Dreamy-Z3r0/VGU-WirelessMeteorologyStation/05 - Literature/Figures/Hardware/Misol station - internal PCB.jpg

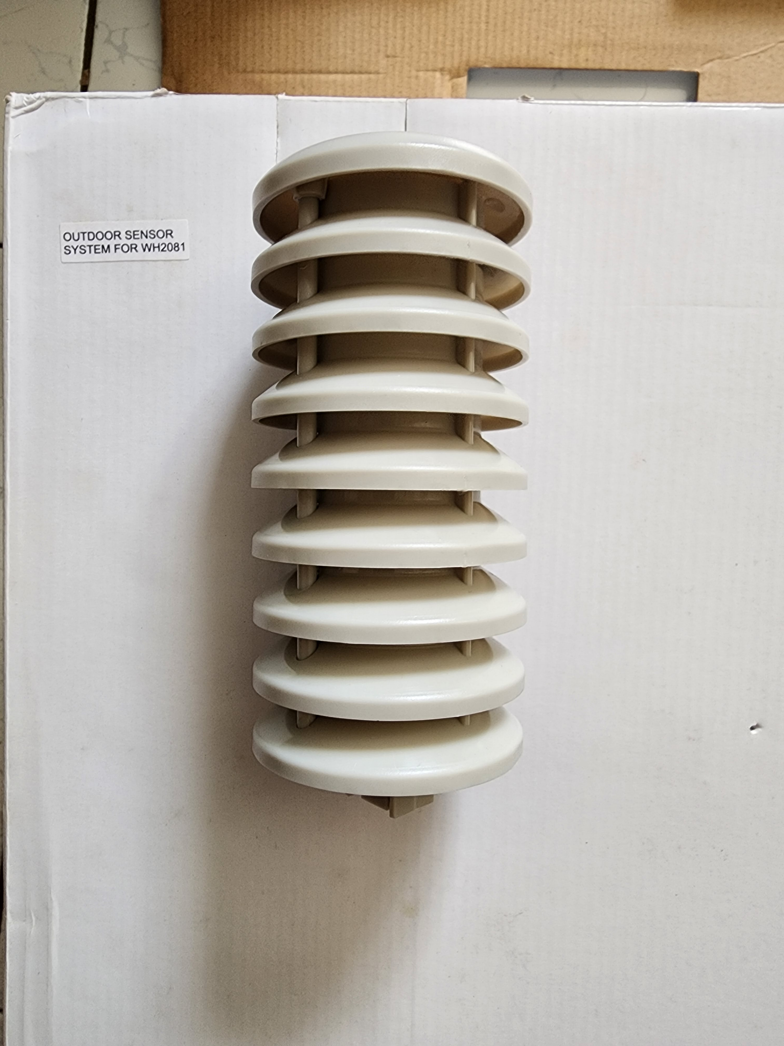
05 - Literature/Figures/Hardware/Misol station - internal PCB.jpg
