Dreamy-Z3r0/VGU-WirelessMeteorologyStation/05 - Literature/Figures/Hardware/Misol station - weather-proof case.jpg

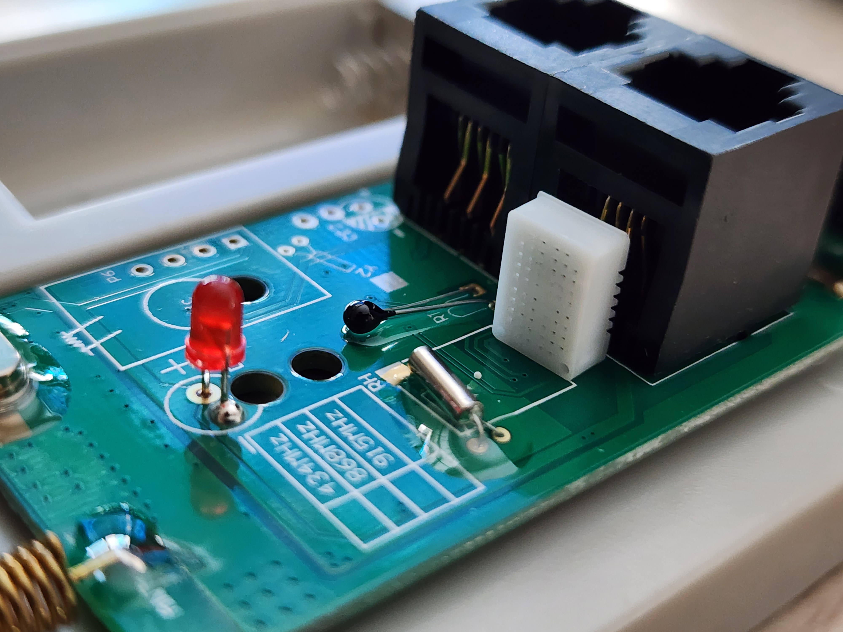
05 - Literature/Figures/Hardware/Misol station - weather-proof case.jpg
