Dreamy-Z3r0/VGU-WirelessMeteorologyStation/05 - Literature/Figures/40403.jpg

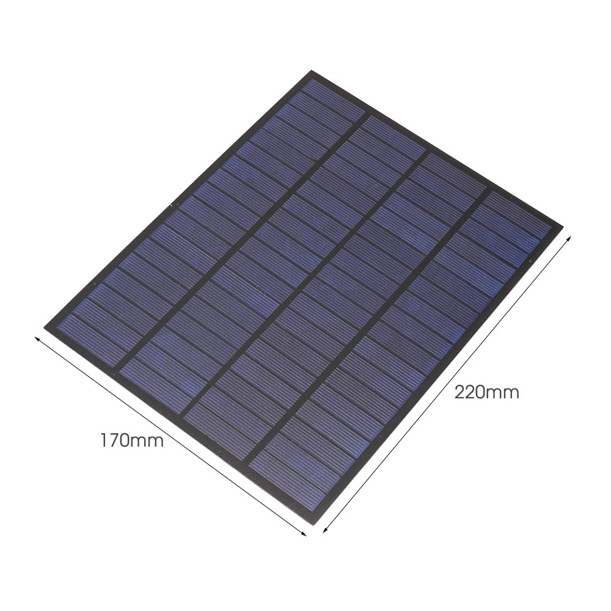
05 - Literature/Figures/40403.jpg
