Dreamy-Z3r0/VGU-WirelessMeteorologyStation/05 - Literature/Figures/50713.jpg

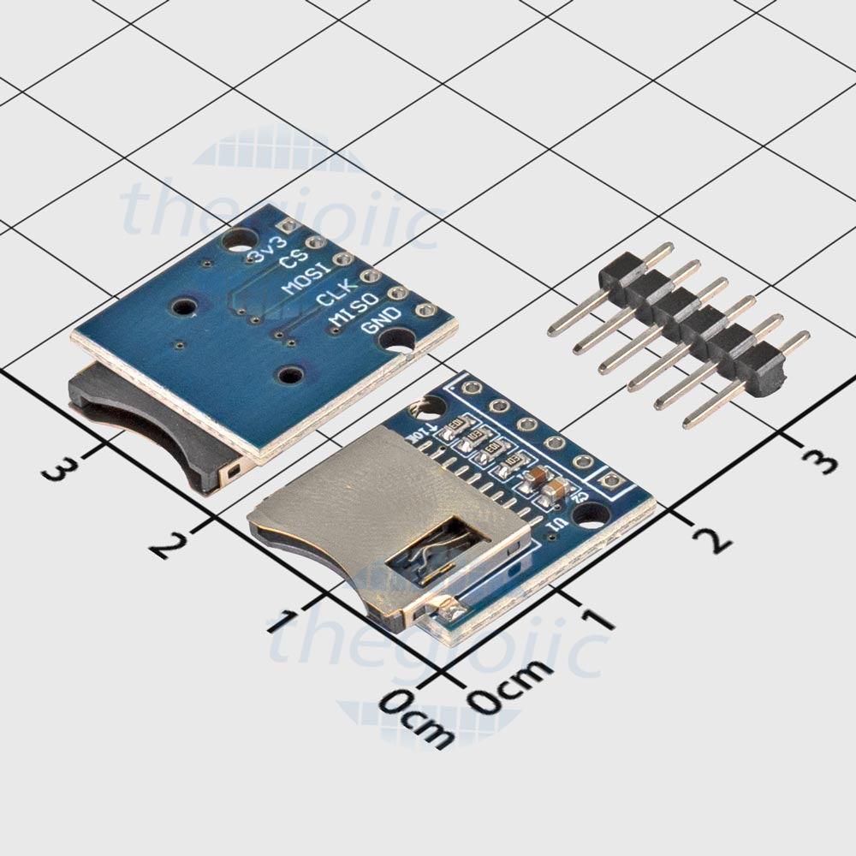
05 - Literature/Figures/50713.jpg
