Dreamy-Z3r0/VGU-WirelessMeteorologyStation/05 - Literature/Figures/20230910_115903.jpg

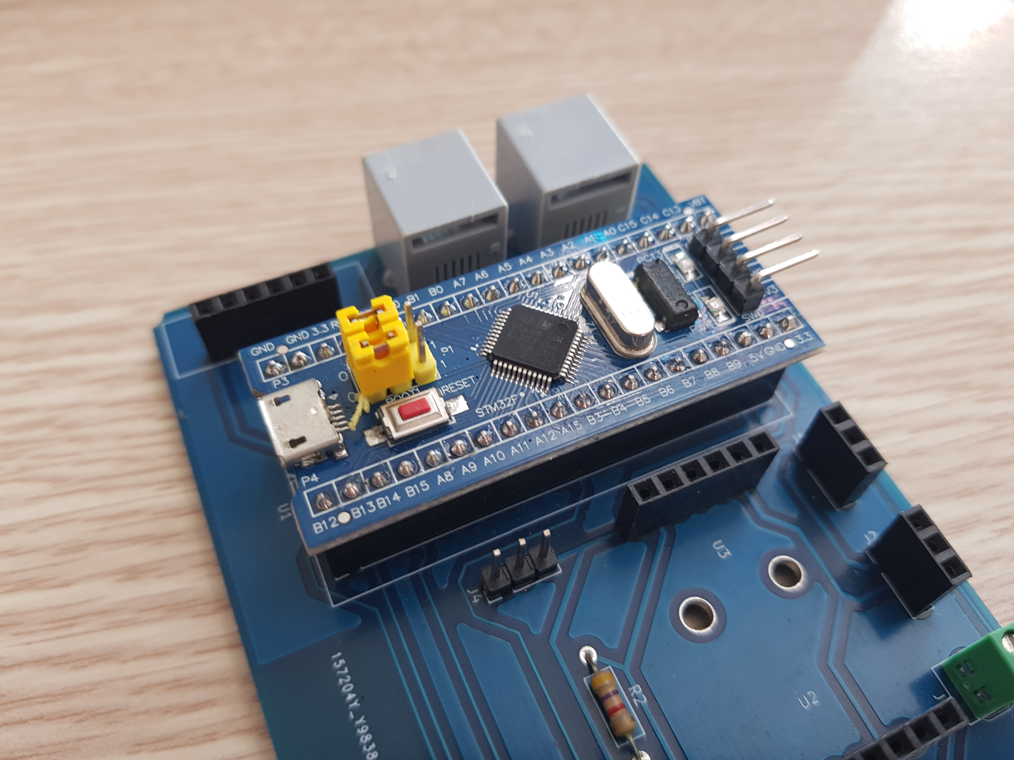
05 - Literature/Figures/20230910_115903.jpg
