Dreamy-Z3r0/VGU-WirelessMeteorologyStation/05 - Literature/Figures/[DS18B20] Read routine.png

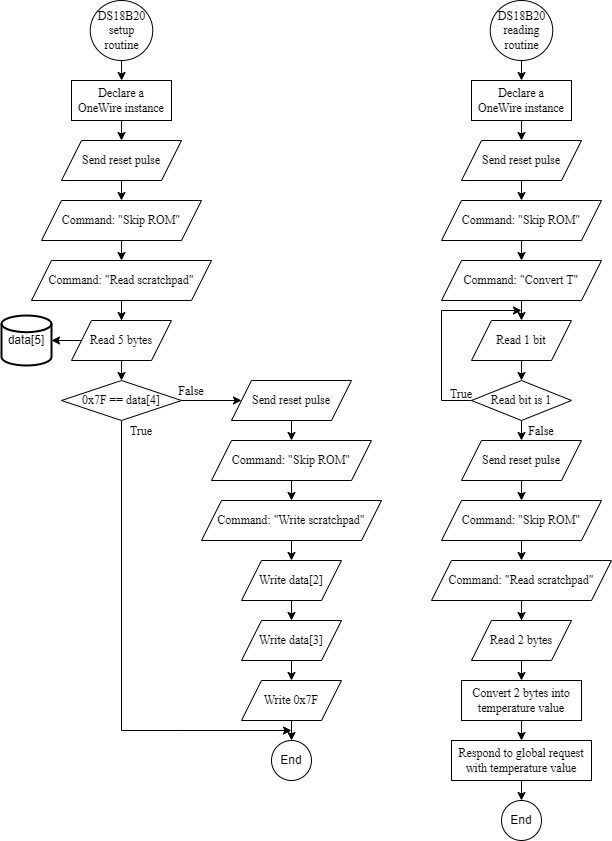
05 - Literature/Figures/[DS18B20] Read routine.png
