Dreamy-Z3r0/VGU-WirelessMeteorologyStation/05 - Literature/Figures/[Gateway] Software.png

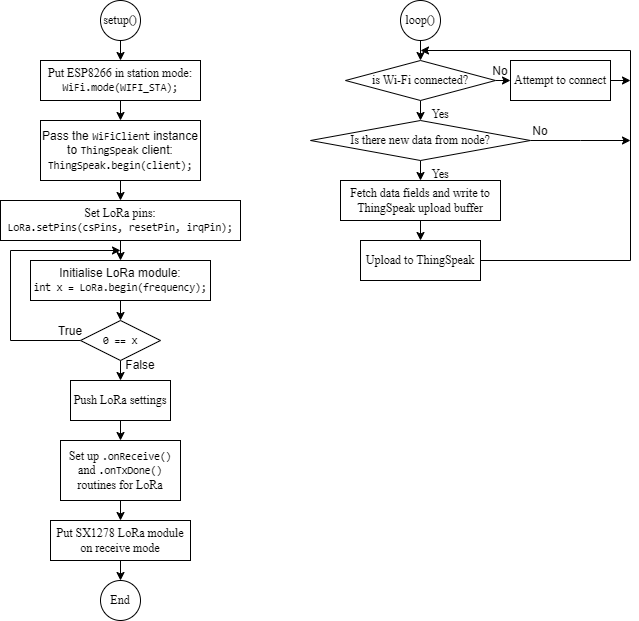
05 - Literature/Figures/[Gateway] Software.png
