Dreamy-Z3r0/VGU-WirelessMeteorologyStation/05 - Literature/Figures/[SX1278] Software design flow.png

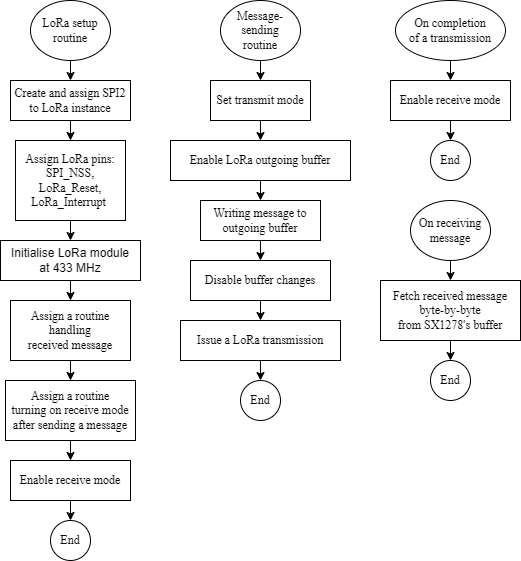
05 - Literature/Figures/[SX1278] Software design flow.png
