Dreamy-Z3r0/VGU-WirelessMeteorologyStation/05 - Literature/Figures/Active filter.PNG

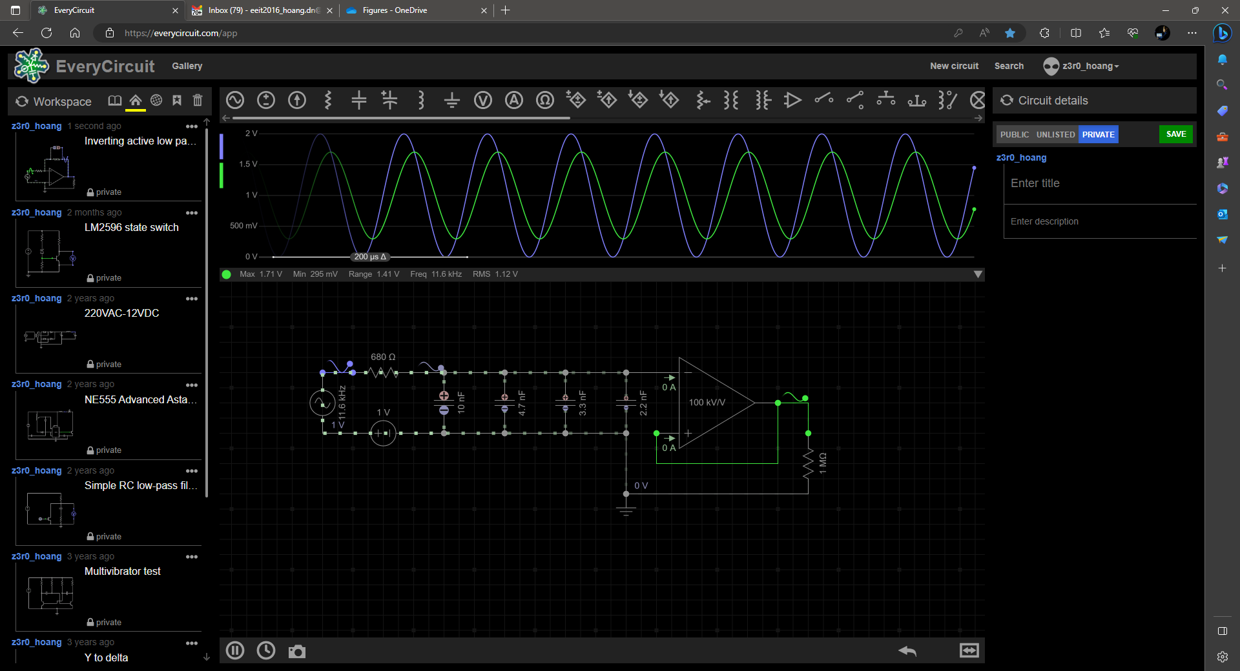
05 - Literature/Figures/Active filter.PNG
