Dreamy-Z3r0/VGU-WirelessMeteorologyStation/05 - Literature/Figures/Active filter/SCR46.PNG

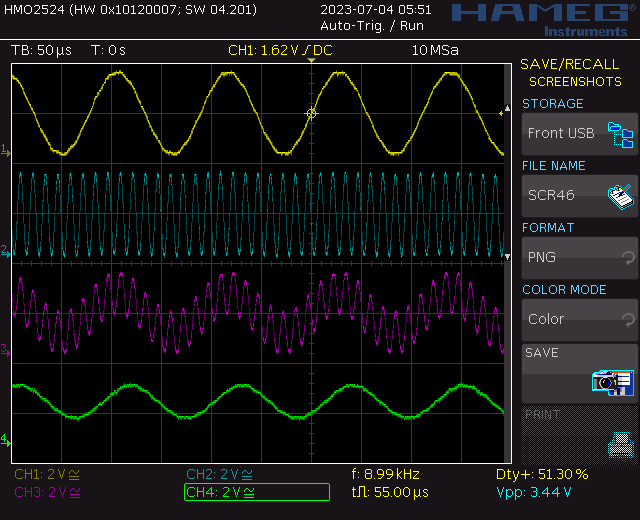
05 - Literature/Figures/Active filter/SCR46.PNG
