Dreamy-Z3r0/VGU-WirelessMeteorologyStation/05 - Literature/Figures/ADC_simplified.PNG

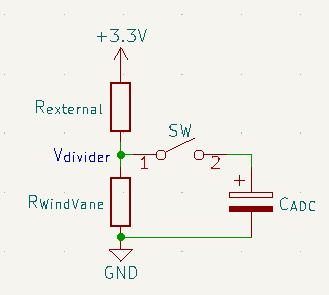
05 - Literature/Figures/ADC_simplified.PNG
