Dreamy-Z3r0/VGU-WirelessMeteorologyStation/05 - Literature/Figures/ADC_simplified_current source_equivalent.PNG

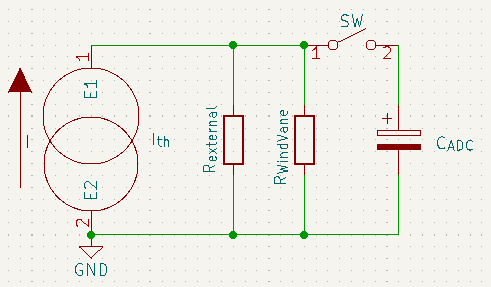
05 - Literature/Figures/ADC_simplified_current source_equivalent.PNG
