Dreamy-Z3r0/VGU-WirelessMeteorologyStation/05 - Literature/Figures/ADC_simplified_current source_final.PNG

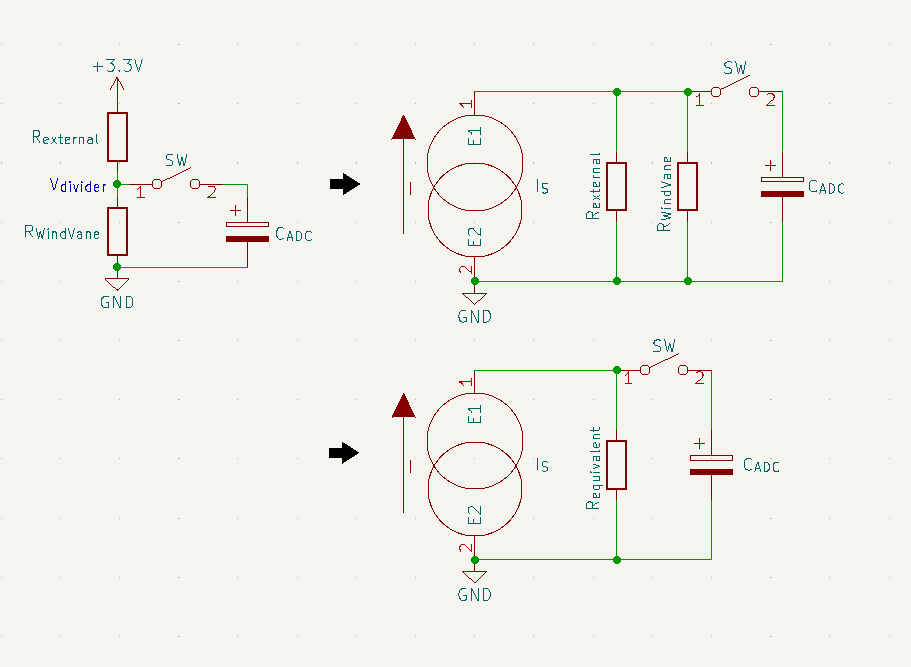
05 - Literature/Figures/ADC_simplified_current source_final.PNG
