Dreamy-Z3r0/VGU-WirelessMeteorologyStation/05 - Literature/Figures/ADC_simplified_current source_to voltage source.PNG

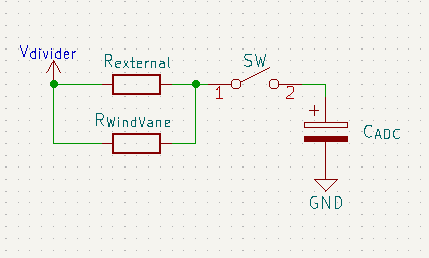
05 - Literature/Figures/ADC_simplified_current source_to voltage source.PNG
