Dreamy-Z3r0/VGU-WirelessMeteorologyStation/05 - Literature/Figures/Anemometer factor chart.png

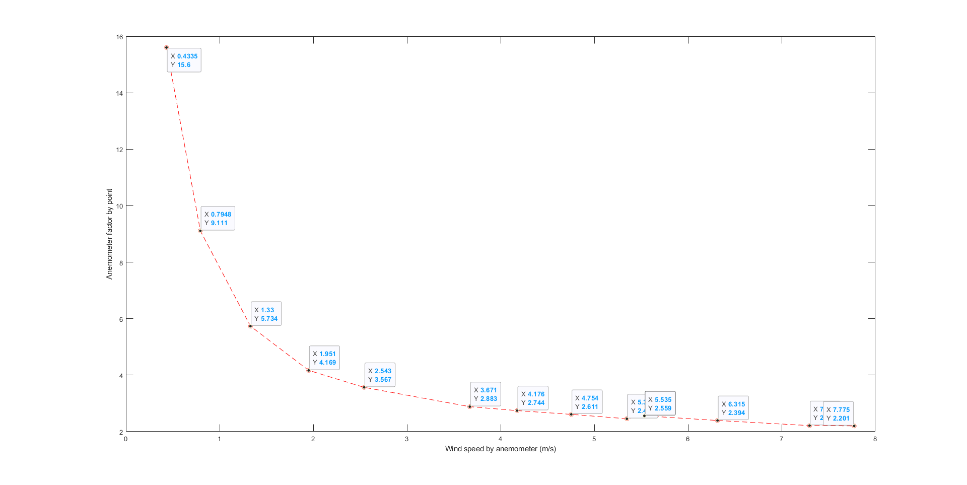
05 - Literature/Figures/Anemometer factor chart.png
