Dreamy-Z3r0/VGU-WirelessMeteorologyStation/05 - Literature/Figures/Blue Pill - ADC.PNG

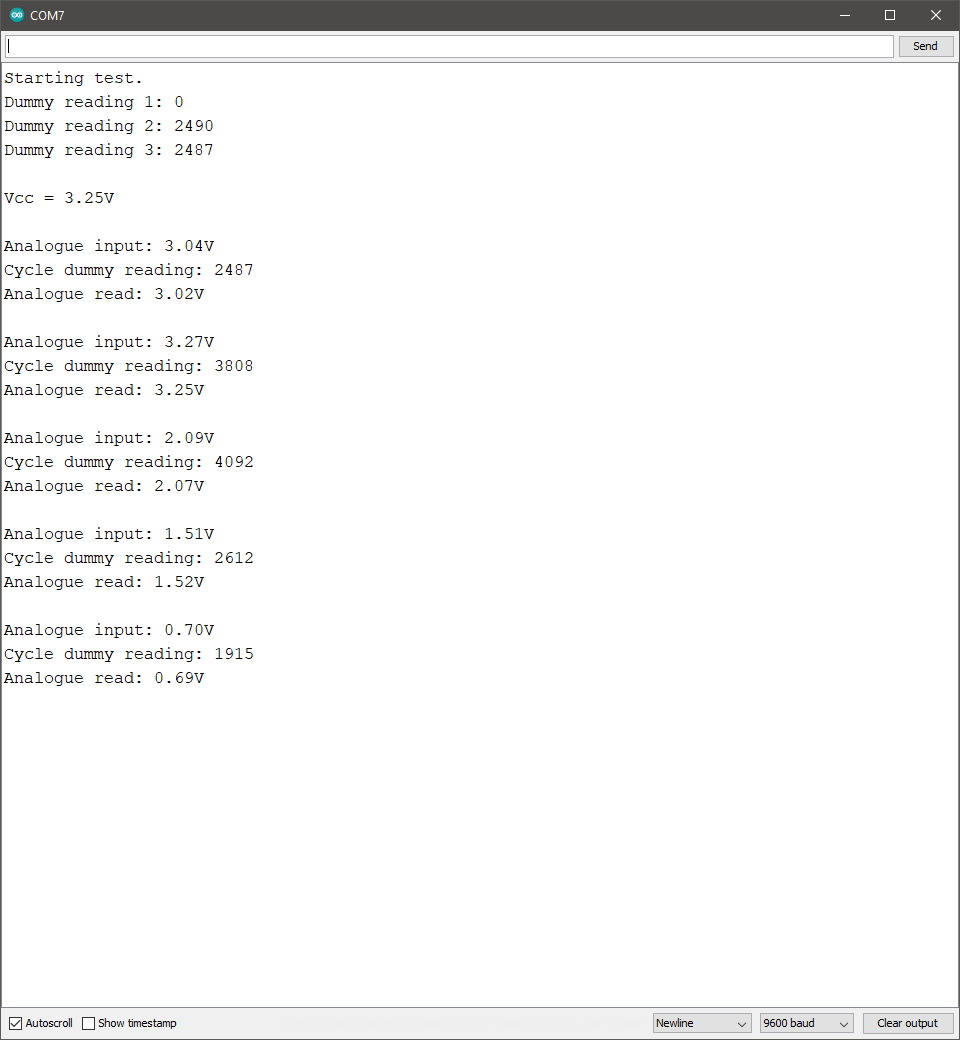
05 - Literature/Figures/Blue Pill - ADC.PNG
