Dreamy-Z3r0/VGU-WirelessMeteorologyStation/05 - Literature/Figures/Blue Pill - External interrupt and output delay.PNG

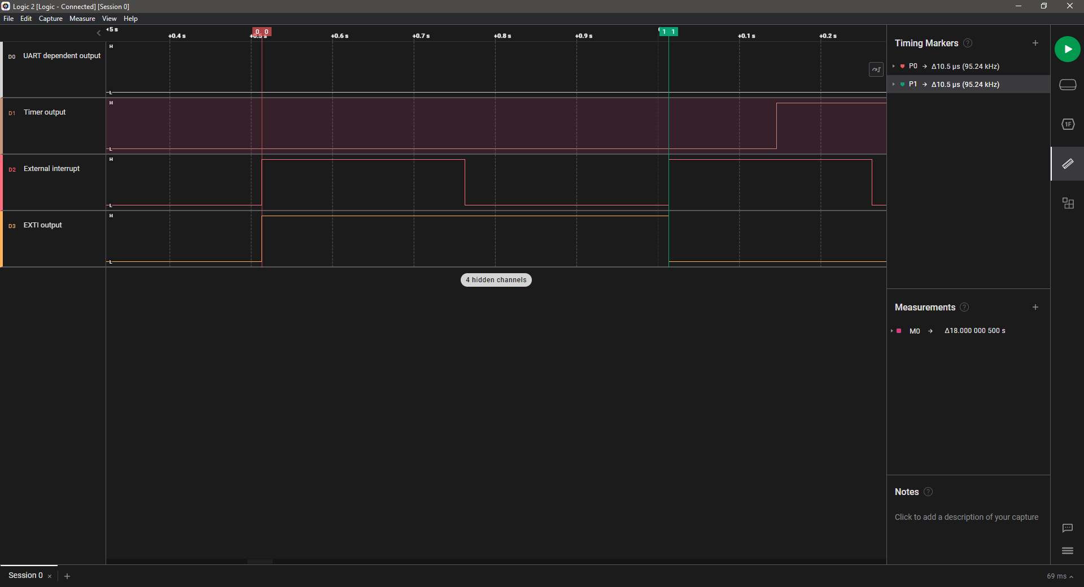
05 - Literature/Figures/Blue Pill - External interrupt and output delay.PNG
