Dreamy-Z3r0/VGU-WirelessMeteorologyStation/05 - Literature/Figures/Blue Pill - UART routine.PNG

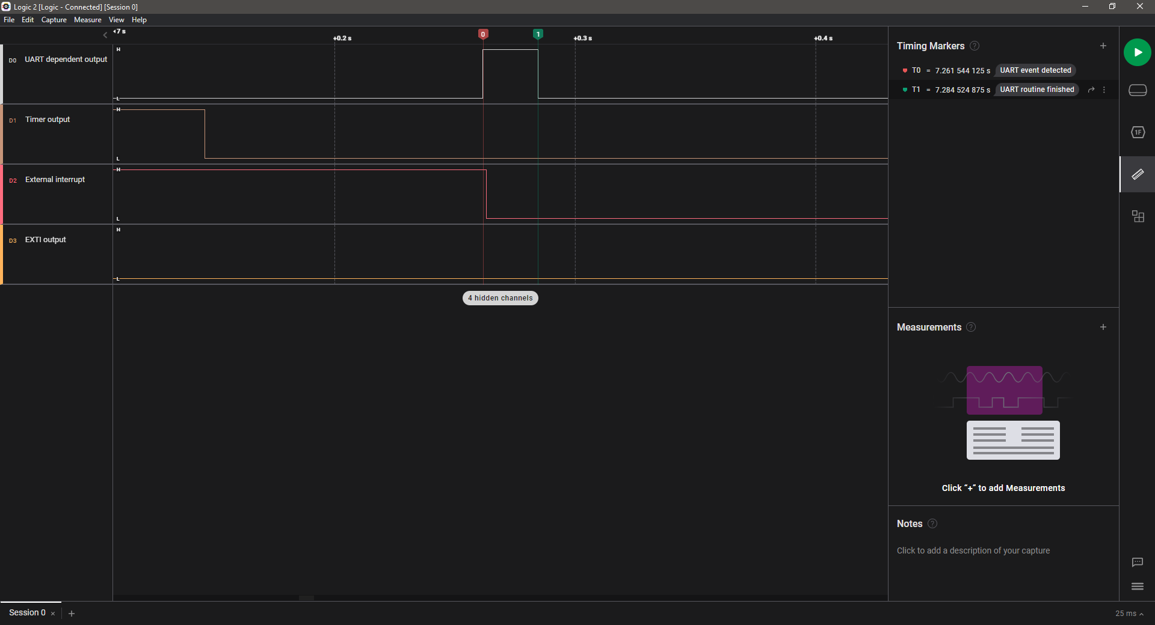
05 - Literature/Figures/Blue Pill - UART routine.PNG
