Dreamy-Z3r0/VGU-WirelessMeteorologyStation/05 - Literature/Figures/Blue Pill schematic.png

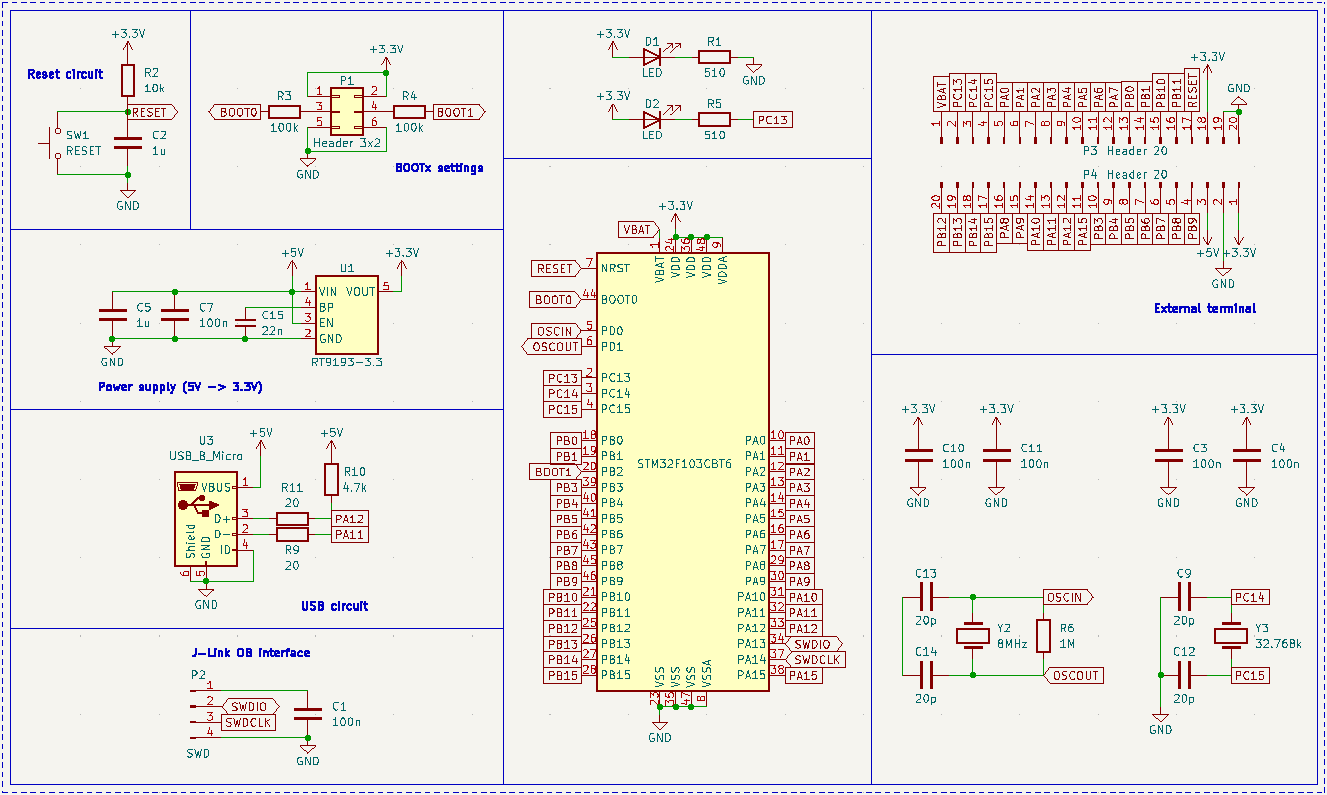
05 - Literature/Figures/Blue Pill schematic.png
