Dreamy-Z3r0/VGU-WirelessMeteorologyStation/05 - Literature/Figures/Blue Pill simplified - 1Hz output on EXTI.PNG

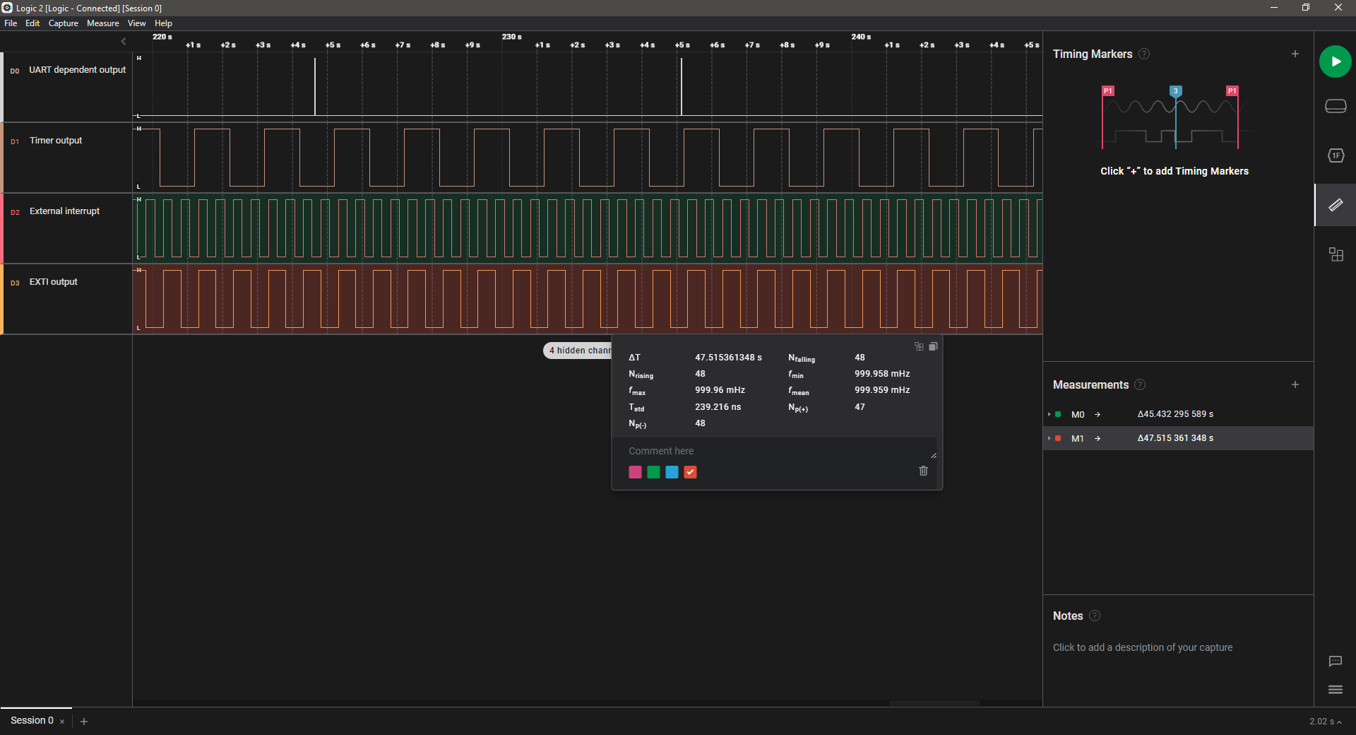
05 - Literature/Figures/Blue Pill simplified - 1Hz output on EXTI.PNG
