Dreamy-Z3r0/VGU-WirelessMeteorologyStation/05 - Literature/Figures/Blue Pill simplified - 1Hz Timer for 0.5Hz output.PNG

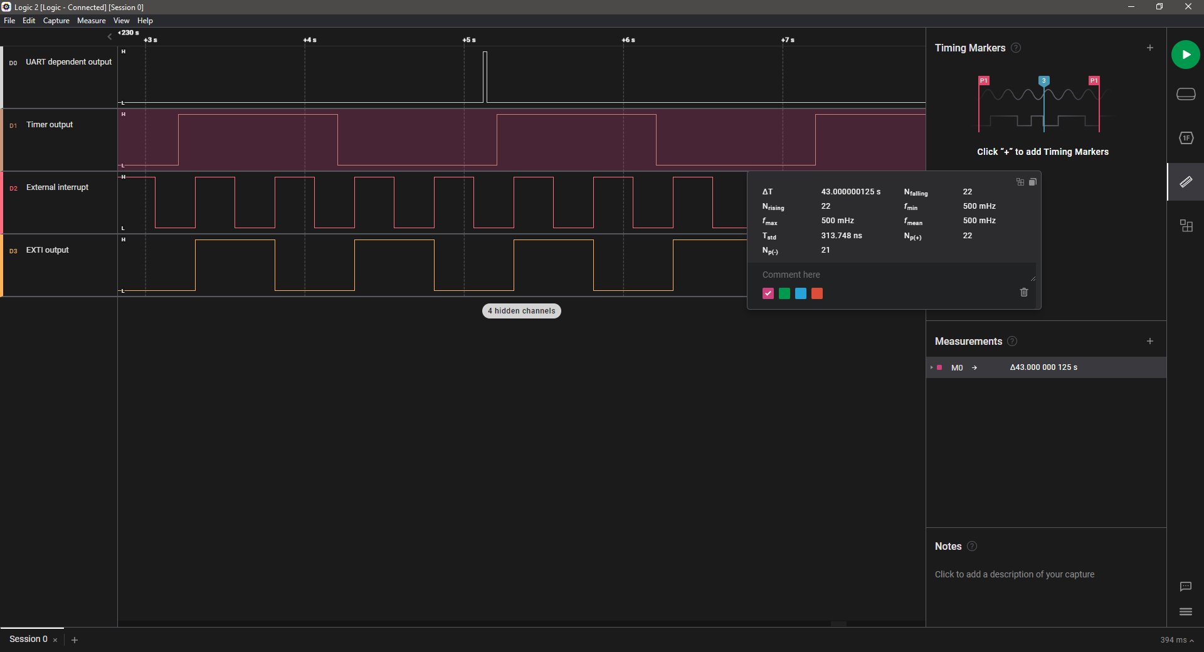
05 - Literature/Figures/Blue Pill simplified - 1Hz Timer for 0.5Hz output.PNG
