Dreamy-Z3r0/VGU-WirelessMeteorologyStation/05 - Literature/Figures/Blue Pill simplified - 2Hz external interrupt.PNG

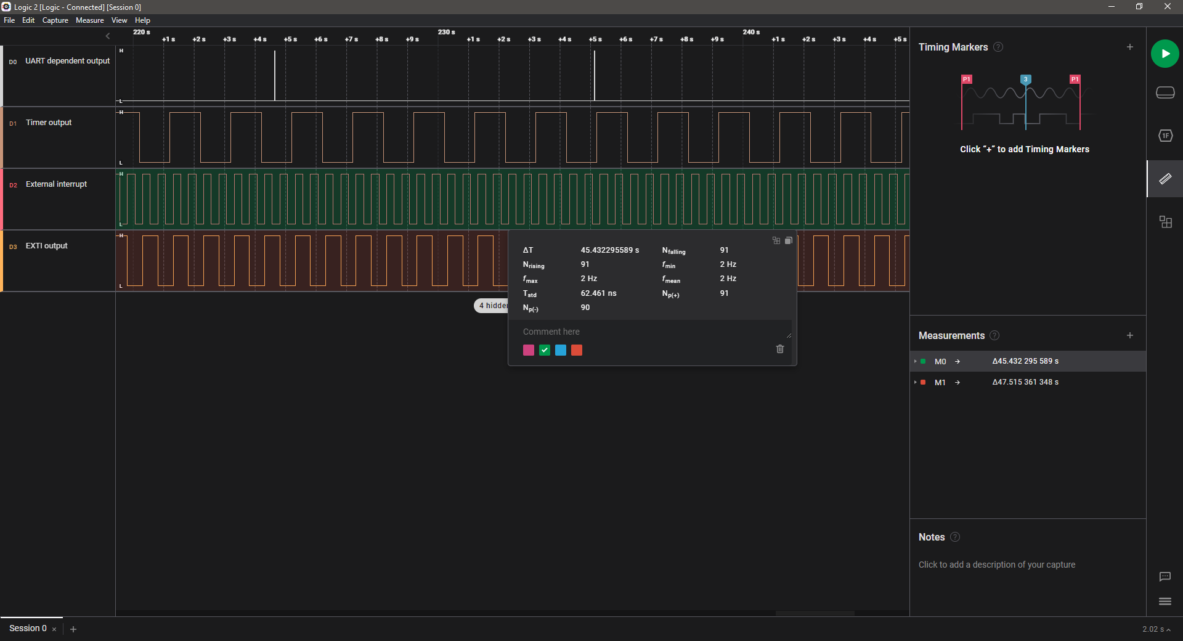
05 - Literature/Figures/Blue Pill simplified - 2Hz external interrupt.PNG
