Dreamy-Z3r0/VGU-WirelessMeteorologyStation/05 - Literature/Figures/Determining R_external.PNG

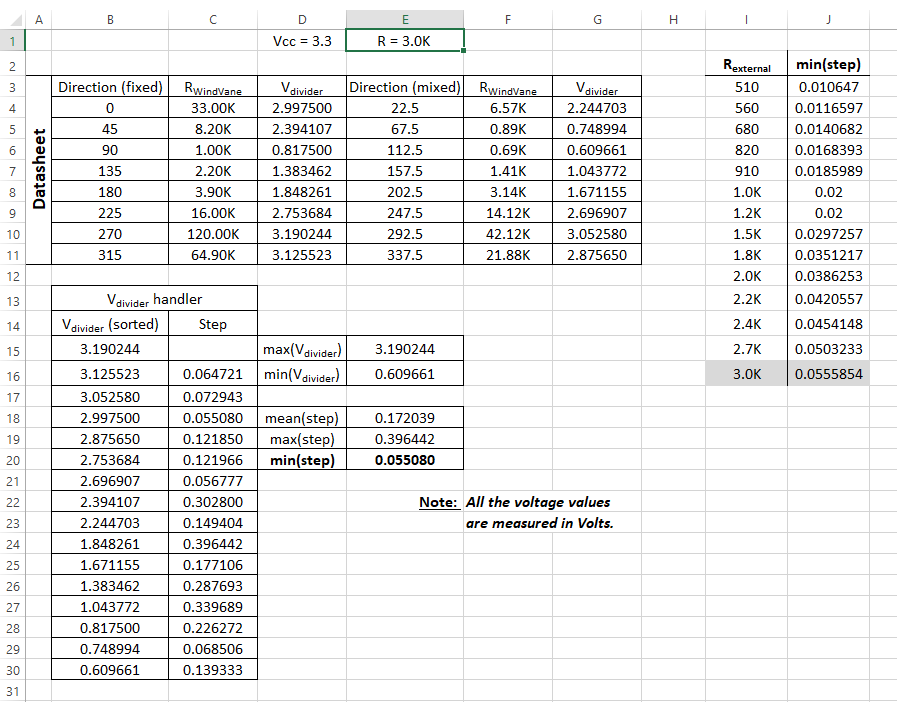
05 - Literature/Figures/Determining R_external.PNG
