Dreamy-Z3r0/VGU-WirelessMeteorologyStation/05 - Literature/Figures/Finalised circuitry for anemometer and rain gauge.PNG

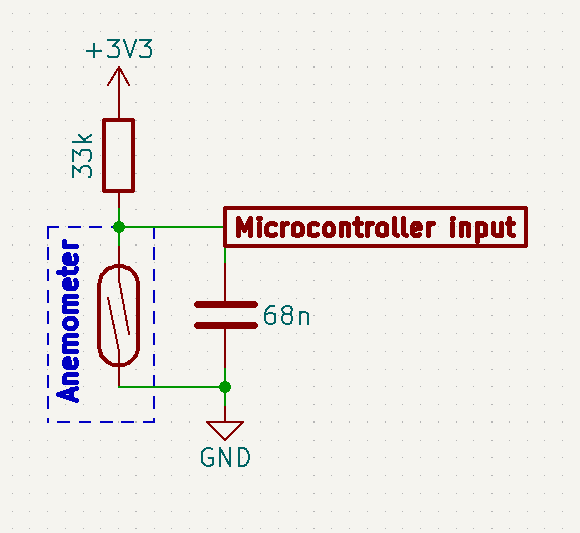
05 - Literature/Figures/Finalised circuitry for anemometer and rain gauge.PNG
