Dreamy-Z3r0/VGU-WirelessMeteorologyStation/05 - Literature/Figures/No reverse current protection - high pv output.jpeg

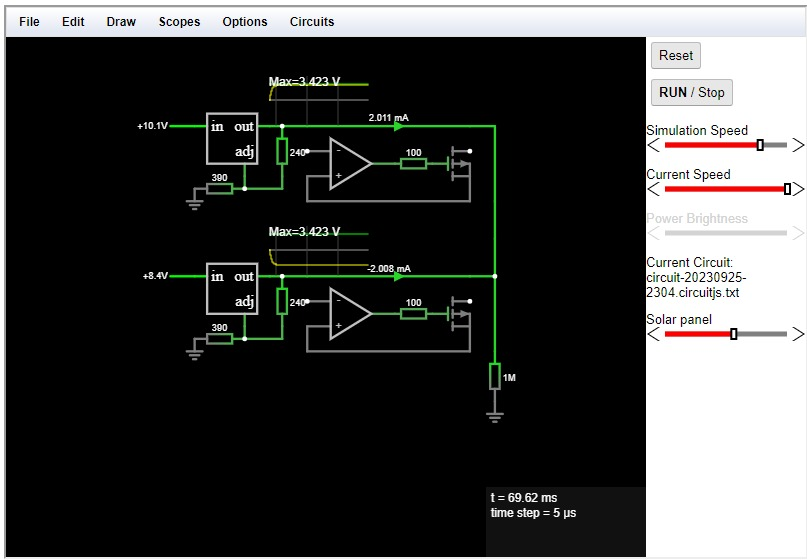
05 - Literature/Figures/No reverse current protection - high pv output.jpeg
