Dreamy-Z3r0/VGU-WirelessMeteorologyStation/05 - Literature/Figures/No reverse current protection - reverse current present.jpeg

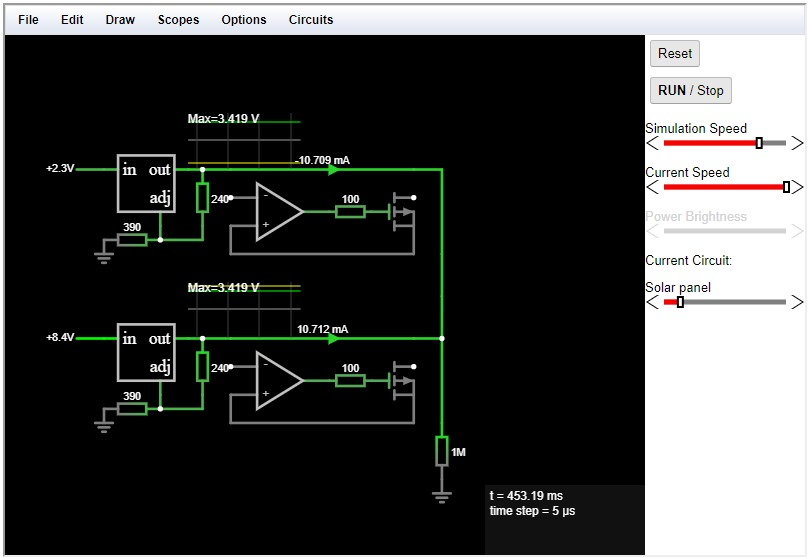
05 - Literature/Figures/No reverse current protection - reverse current present.jpeg
