Dreamy-Z3r0/VGU-WirelessMeteorologyStation/05 - Literature/Figures/STM32CubeProg detecting C8T6 with 128KB.PNG

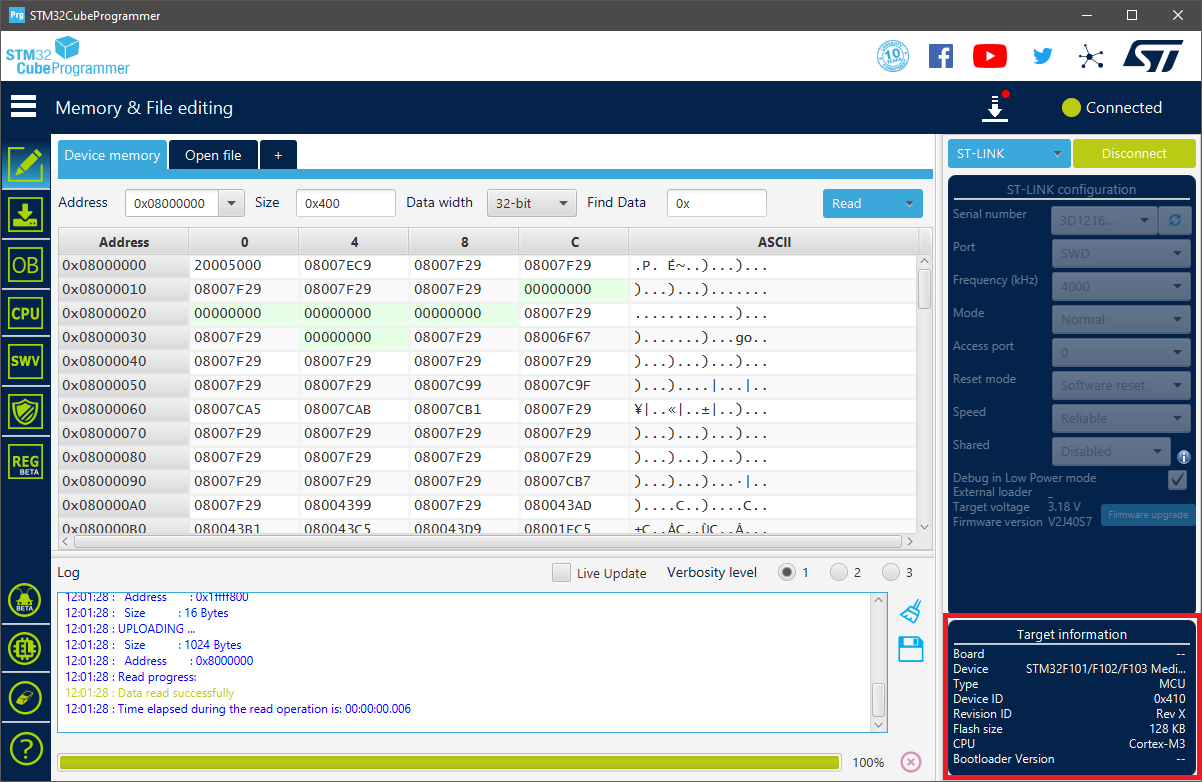
05 - Literature/Figures/STM32CubeProg detecting C8T6 with 128KB.PNG
