Dreamy-Z3r0/VGU-WirelessMeteorologyStation/05 - Literature/Figures/Thingspeak - configuring charts.jpeg

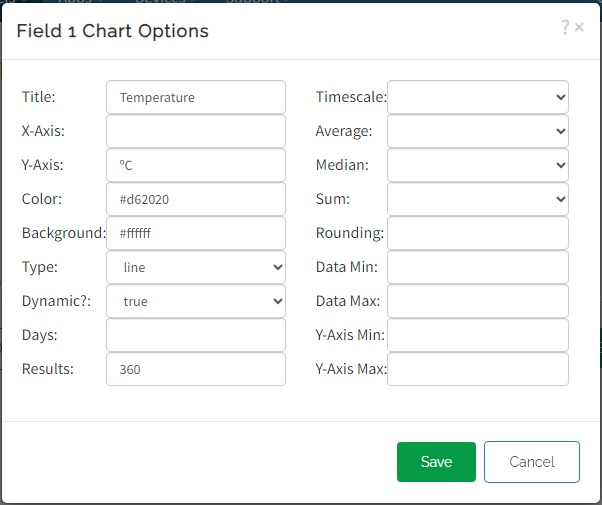
05 - Literature/Figures/Thingspeak - configuring charts.jpeg
