Dreamy-Z3r0/VGU-WirelessMeteorologyStation/01 - Simulations/2nd order active LPF/2nd order active LPF.png

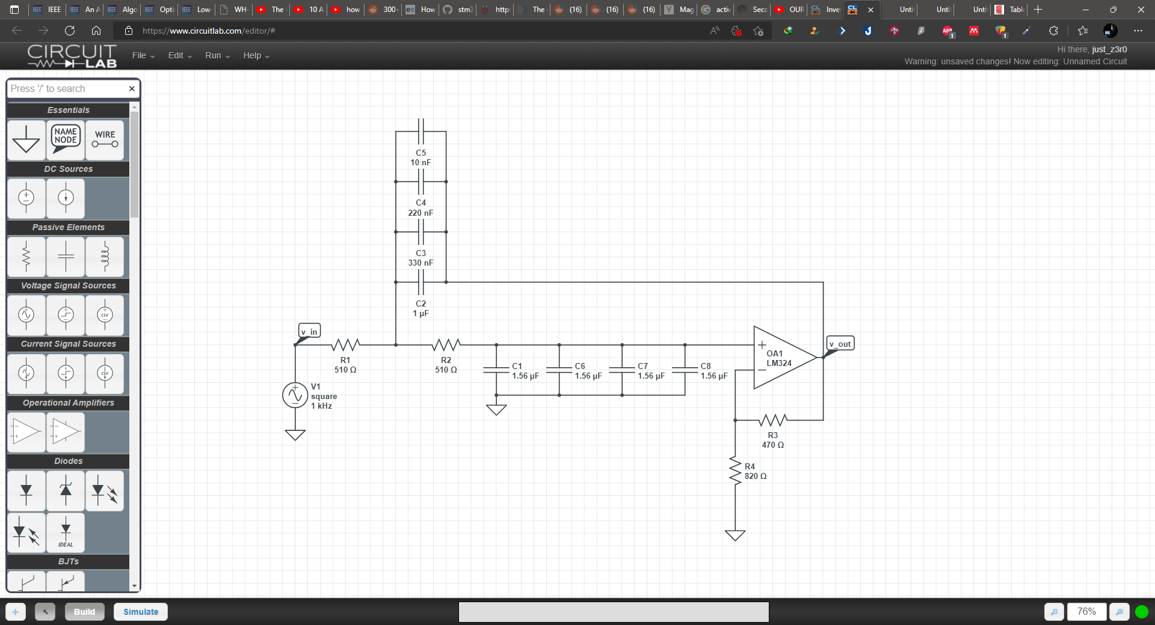
01 - Simulations/2nd order active LPF/2nd order active LPF.png
