Dreamy-Z3r0/VGU-WirelessMeteorologyStation/01 - Simulations/2nd order active LPF/LM324 - phase.png

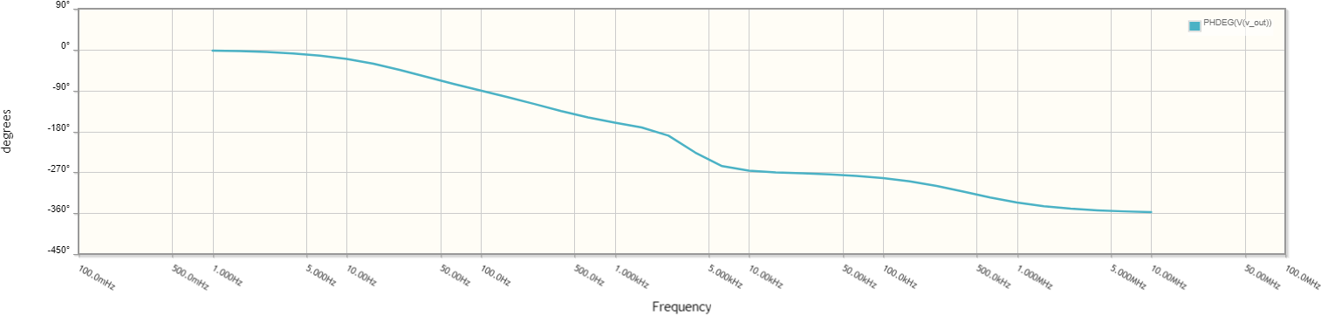
01 - Simulations/2nd order active LPF/LM324 - phase.png
