Dreamy-Z3r0/VGU-WirelessMeteorologyStation/04 - Assembly/Version 0.2.1 (Beta) - minor update/Main_Code/README.md

# Assembly
### Version 0.2.1 (beta)

- Initialization of the main code: ***Main_Code.ino***, ***Libraries.h***, and ***Macros_and_Variables.h***
- First feature of the assembly: *Real-time Clock*
- Second feature of the assembly: *Ambient temperature - Relative humidity - Barometric pressure*
- (*minor update*) Remove SPI remapping
