Dreamy-Z3r0/VGU-WirelessMeteorologyStation/04 - Assembly/Version 1.4 (Beta)/Main_Code/README.md

# Assembly
### Beta release - Version 1.4

Change log:
- Add main routine for Sensor_Control class
- Remove most of main.ino contents
