Dreamy-Z3r0/VGU-WirelessMeteorologyStation/04 - Assembly/Version 1.1 (Beta)/Main_Code/README.md

# Assembly
### Beta release - Version 1.1

Change log:
- HAL implementation added for ADC functionality.
- Improved code readability.
