Dreamy-Z3r0/VGU-WirelessMeteorologyStation/04 - Assembly/Version 1.2 (Beta)/Main_Code/README.md

# Assembly
### Beta release - Version 1.2

Change log:
- Restructured code hierarchies.
- New methods for anemometer control.
- Simplified processing functions of vind vane by the removal of unnecessary variable dynamic allocation.
- Bug fixed: Invalid results produced by high ordered IIR filter.
