Dreamy-Z3r0/VGU-WirelessMeteorologyStation/04 - Assembly/Version 1.3 (Beta)/Main_Code/README.md

# Assembly
### Beta release - Version 1.3

Change log:
- Change of wind vane reading method
- Bug fixed: Conflicted access of DS3231 due to the update of timestamps for sensors.
