Dreamy-Z3r0/VGU-WirelessMeteorologyStation/05 - Literature/Figures/[Anemometer] Software setup.png

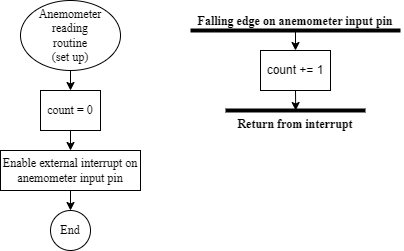
05 - Literature/Figures/[Anemometer] Software setup.png
