Dreamy-Z3r0/VGU-WirelessMeteorologyStation/05 - Literature/Figures/Bypass capacitor setup.PNG

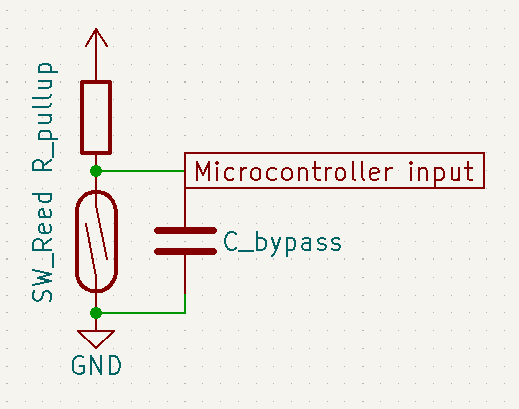
05 - Literature/Figures/Bypass capacitor setup.PNG
