Dreamy-Z3r0/VGU-WirelessMeteorologyStation/05 - Literature/Figures/Dummie mechanical switch setup.PNG

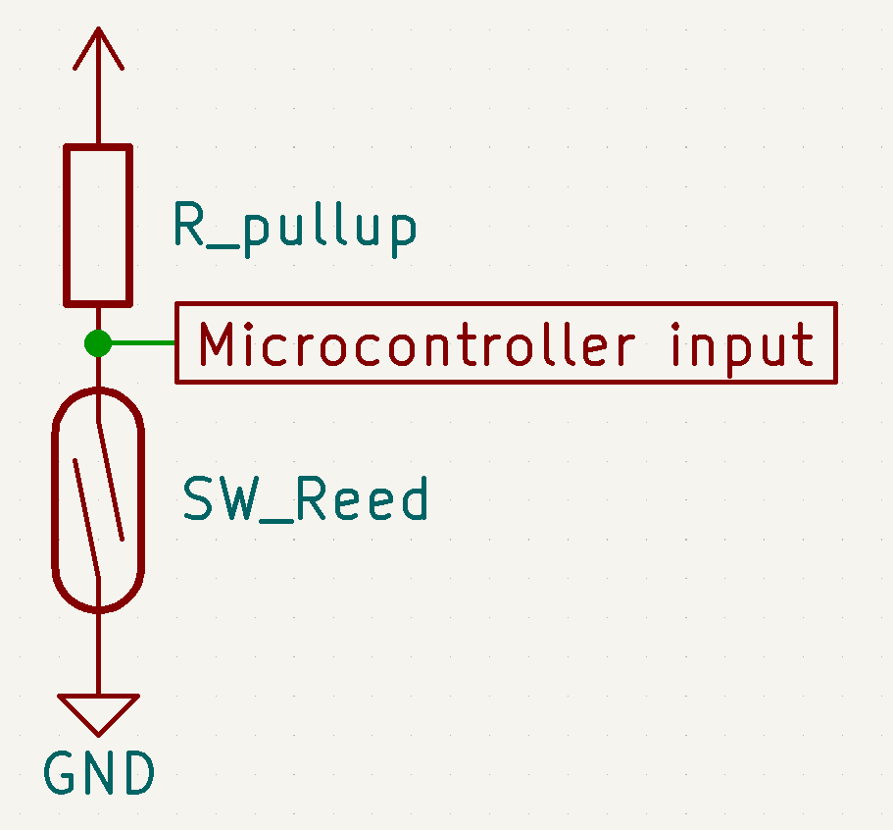
05 - Literature/Figures/Dummie mechanical switch setup.PNG
