Dreamy-Z3r0/VGU-WirelessMeteorologyStation/05 - Literature/Figures/OpAmp buffer test - CA3140EZ - Sine/TEST_INFO.txt

Device in test: CA3140EZ
Test wave: Sine wave, 440Hz, A = 3.3Vpp, 1.65V offset
Variable: OpAmp supply voltage
