Dreamy-Z3r0/VGU-WirelessMeteorologyStation/05 - Literature/Figures/OpAmp buffer test - CA3140EZ - Sawtooth/500mHz/TEST_INFO.txt

Device in test: CA3140EZ
Test wave: Sawtooth wave, 500mHz, A = 3.3Vpp, 1.65V offset, 100% symmetry
Variable: OpAmp supply voltage
