Dreamy-Z3r0/VGU-WirelessMeteorologyStation/05 - Literature/Figures/OpAmp buffer test - CA3140EZ - Sawtooth/50Hz/TEST_INFO.txt

Device in test: CA3140EZ
Test wave: Sawtooth wave, 50Hz, A = 3.3Vpp, 1.65V offset, 100% symmetry
Variable: OpAmp supply voltage
