Dreamy-Z3r0/VGU-WirelessMeteorologyStation/02 - Module Testings/Power supply tests/LM317.xlsx

LM317 |  |  |  |  |  | LM317 + TL431
18 | 3.3 | 18 | 3.93 | 18 | 4.25 | 18 | 18 | 3.55 | 18 | 3.74 | 18 | 15.13
15 | 3.27 | 15 | 3.78 | 15 | 4.08 | 15 | 15 | 3.47 | 15 | 3.62 | 15 | 14.06
12 | 3.13 | 12 | 3.59 | 12 | 3.88 | 12 | 12 | 3.39 | 12 | 3.52 | 12 | 11.05
10 | 3.13 | 10 | 3.44 | 10 | 3.71 | 10 | 10 | 3.33 | 10 | 3.44 | 10 | 9.18
8.4 | 3.13 | 8.4 | 3.3 | 8.4 | 3.56 | 8.4 | 8.4 | 3.3 | 8.4 | 3.39 | 8.4 | 7.59
6.3 | 3.12 | 6.3 | 3.06 | 6.3 | 3.3 | 6.3 | 6.3 | 3.24 | 6.3 | 3.3 | 6.3 | 5.46
5 | 3.09 | 5 | 2.88 | 5 | 3.1 | 4.1 | 4.1 | 3 | 4.1 | 3.04 | 4.1 | 3.3
3.3 | 2.4 | 3.3 | 2.43 | 3.3 | 2.36 | 3.3 | 3.3 | 2.29 | 3.3 | 2.34 | 3.3 | 2.53
2.5 | 1.67 | 2.5 | 1.67 | 2.5 | 1.69 | 2.5 | 2.5 | 1.62 | 2.5 | 1.57 | 2.5 | 1.74
1.25 | 0.55 | 1.25 | 0.55 | 1.25 | 0.56 | 1.25 | 1.25 | 0.52 | 1.25 | 0.54 | 1.25 | 0.44
 |  |  |  |  |  | min(Vin) = 4.1V
