Dreamy-Z3r0/VGU-WirelessMeteorologyStation/05 - Literature/Data/ADC test - wind vane/Active filter - 3.3k pull down/Active filter - 3.3k pull down.xlsx

Direction (read) | Raw ADC | V_in | R_read | Direction (read) | Raw ADC | V_in | R_read | Direction (read) | Raw ADC | V_in | R_read | Direction (read) | Raw ADC | V_in | R_read
Direction: | 0 | 2.9949 V |  | Direction: | 22.5 | 2.1995 V |  | Direction: | 45 | 2.3538 V |  | Direction: | 67.5 | 0.7084 V
0 | 3741 | 2.99 | 35643.78 | 22.5 | 2740 | 2.19 | 6680.43 | 45 | 2933 | 2.34 | 8339.53 | 67.5 | 867 | 0.69 | 885.04
0 | 3738 | 2.99 | 34873.71 | 22.5 | 2737 | 2.19 | 6673.06 | 45 | 2933 | 2.34 | 8329.52 | 67.5 | 864 | 0.69 | 886.34
0 | 3739 | 2.98 | 34552.92 | 22.5 | 2739 | 2.19 | 6651.03 | 45 | 2930 | 2.34 | 8329.52 | 67.5 | 873 | 0.69 | 882.45
0 | 3741 | 2.99 | 34659.27 | 22.5 | 2734 | 2.19 | 6665.71 | 45 | 2929 | 2.34 | 8299.57 | 67.5 | 863 | 0.7 | 894.13
0 | 3736 | 2.99 | 34873.71 | 22.5 | 2735 | 2.18 | 6629.1 | 45 | 2931 | 2.34 | 8289.62 | 67.5 | 861 | 0.69 | 881.16
0 | 3734 | 2.98 | 34342.06 | 22.5 | 2739 | 2.18 | 6636.4 | 45 | 2933 | 2.34 | 8309.54 | 67.5 | 865 | 0.69 | 878.57
0 | 3736 | 2.98 | 34133.5 | 22.5 | 2735 | 2.19 | 6665.71 | 45 | 2934 | 2.34 | 8329.52 | 67.5 | 863 | 0.69 | 883.75
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
