Dreamy-Z3r0/VGU-WirelessMeteorologyStation/05 - Literature/Data/ADC test - wind vane/Active filter - 4.7k pull down/Active filter - 4.7k pull down.xlsx

Direction (read) | Raw ADC | V_in | R_read | Direction (read) | Raw ADC | V_in | R_read | Direction (read) | Raw ADC | V_in | R_read | Direction (read) | Raw ADC | V_in | R_read
Direction: | 0 | 2.9943 V |  | Direction: | 22.5 | 2.1988 V |  | Direction: | 45 | 2.3535 V |  | Direction: | 67.5 | 0.7083 V
0 | 3744 | 2.99 | 35983.42 | 22.5 | 2755 | 2.19 | 6754.69 | 45 | 2957 | 2.35 | 8502.18 | 67.5 | 858 | 0.68 | 869.55
0 | 3745 | 2.99 | 35200 | 22.5 | 2753 | 2.2 | 6784.7 | 45 | 2945 | 2.36 | 8574.78 | 67.5 | 860 | 0.68 | 874.7
0 | 3749 | 2.99 | 35309.99 | 22.5 | 2752 | 2.2 | 6769.67 | 45 | 2945 | 2.35 | 8450.87 | 67.5 | 860 | 0.69 | 877.28
0 | 3744 | 2.99 | 35756.36 | 22.5 | 2753 | 2.19 | 6762.17 | 45 | 2946 | 2.35 | 8450.87 | 67.5 | 857 | 0.69 | 877.28
0 | 3747 | 2.99 | 35200 | 22.5 | 2746 | 2.2 | 6769.67 | 45 | 2946 | 2.35 | 8461.1 | 67.5 | 861 | 0.68 | 873.41
0 | 3744 | 2.99 | 35531.88 | 22.5 | 2749 | 2.19 | 6717.42 | 45 | 2952 | 2.35 | 8461.1 | 67.5 | 857 | 0.69 | 878.57
0 | 3746 | 2.99 | 35200 | 22.5 | 2750 | 2.19 | 6739.75 | 45 | 2947 | 2.35 | 8522.83 | 67.5 | 863 | 0.68 | 873.41
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
