Dreamy-Z3r0/VGU-WirelessMeteorologyStation/05 - Literature/Data/ADC test - wind vane/CA3140EZ @ 6V/Filter (11.587kHz) and voltage buffer.xlsx

Direction (read) | Raw ADC | V_in | R_read | Direction (read) | Raw ADC | V_in | R_read | Direction (read) | Raw ADC | V_in | R_read | Direction (read) | Raw ADC | V_in | R_read
Direction: | 0 |  |  | Direction: | 22.5 |  |  | Direction: | 45 |  |  | Direction: | 67.5
0 | 3711 | 2.95 | 31528.6 | 22.5 | 2711 | 2.16 | 6499.49 | 45 | 2905 | 2.31 | 8065.43 | 67.5 | 932 | 0.72 | 928.25
0 | 3713 | 2.96 | 31891.39 | 22.5 | 2715 | 2.16 | 6464.09 | 45 | 2900 | 2.31 | 8055.88 | 90 | 927 | 0.74 | 972.37
0 | 3701 | 2.96 | 32075.66 | 22.5 | 2715 | 2.16 | 6492.39 | 45 | 2903 | 2.31 | 8008.37 | 90 | 911 | 0.74 | 965.62
0 | 3723 | 2.95 | 30998.23 | 22.5 | 2709 | 2.16 | 6492.39 | 45 | 2903 | 2.31 | 8036.83 | 67.5 | 934 | 0.73 | 944.19
0 | 3703 | 2.96 | 33026.6 | 22.5 | 2724 | 2.16 | 6450 | 45 | 2899 | 2.31 | 8036.83 | 90 | 913 | 0.74 | 975.07
0 | 3723 | 2.95 | 31173.22 | 22.5 | 2719 | 2.17 | 6556.67 | 45 | 2899 | 2.31 | 7998.91 | 90 | 913 | 0.73 | 946.86
0 | 3716 | 2.96 | 33026.6 | 22.5 | 2709 | 2.17 | 6520.86 | 45 | 2900 | 2.31 | 7998.91 | 90 | 902 | 0.73 | 946.86
0 | 3724 | 2.96 | 32355.68 | 22.5 | 2711 | 2.16 | 6450 | 45 | 2895 | 2.31 | 8008.37 | 67.5 | 909 | 0.72 | 932.23
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
