Dreamy-Z3r0/VGU-WirelessMeteorologyStation/05 - Literature/Data/ADC test - wind vane/CA3140EZ @ 6V/Only voltage buffer.xlsx

Direction (read) | Raw ADC | V_in | R_read | Direction (read) | Raw ADC | V_in | R_read | Direction (read) | Raw ADC | V_in | R_read | Direction (read) | Raw ADC | V_in | R_read
Direction: | 0 |  |  | Direction: | 22.5 |  |  | Direction: | 45 |  |  | Direction: | 67.5
0 | 3730 | 2.97 | 33421.47 | 22.5 | 2720 | 2.17 | 6535.15 | 45 | 2906 | 2.31 | 7998.91 | 67.5 | 905 | 0.72 | 938.86
0 | 3721 | 2.97 | 33723.28 | 22.5 | 2717 | 2.17 | 6528 | 45 | 2909 | 2.32 | 8065.43 | 67.5 | 917 | 0.72 | 936.21
0 | 3719 | 2.96 | 32832.35 | 22.5 | 2698 | 2.16 | 6506.6 | 45 | 2912 | 2.32 | 8094.18 | 90 | 913 | 0.73 | 952.2
0 | 3725 | 2.96 | 32640.16 | 22.5 | 2715 | 2.15 | 6373.23 | 45 | 2921 | 2.32 | 8123.08 | 90 | 917 | 0.73 | 946.86
0 | 3718 | 2.97 | 33222.98 | 22.5 | 2707 | 2.16 | 6492.39 | 45 | 2927 | 2.33 | 8210.65 | 90 | 901 | 0.73 | 952.2
0 | 3705 | 2.96 | 32544.83 | 22.5 | 2714 | 2.16 | 6435.95 | 45 | 2917 | 2.33 | 8269.78 | 67.5 | 892 | 0.72 | 930.9
0 | 3721 | 2.95 | 31350 | 22.5 | 2729 | 2.16 | 6485.3 | 45 | 2906 | 2.32 | 8171.56 | 67.5 | 912 | 0.71 | 919.01
0 | 3715 | 2.96 | 32832.35 | 22.5 | 2719 | 2.17 | 6592.75 | 45 | 2894 | 2.32 | 8065.43 | 90 | 898 | 0.73 | 945.52
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
