Dreamy-Z3r0/VGU-WirelessMeteorologyStation/05 - Literature/Data/ADC test - wind vane/MCP6002 @ 3.3V/Filter (11.587kHz) and voltage buffer.xlsx

Direction (read) | Raw ADC | V_in | R_read | Direction (read) | Raw ADC | V_in | R_read | Direction (read) | Raw ADC | V_in | R_read | Direction (read) | Raw ADC | V_in | R_read
Direction: | 0 |  |  | Direction: | 22.5 |  |  | Direction: | 45 |  |  | Direction: | 67.5
292.5 | 3771 | 3.02 | 38929.68 | 22.5 | 2756 | 2.2 | 6784.7 | 45 | 2965 | 2.37 | 8637.72 | 67.5 | 869 | 0.69 | 882.45
292.5 | 3776 | 3.02 | 38408.32 | 22.5 | 2758 | 2.2 | 6792.23 | 45 | 2962 | 2.37 | 8658.85 | 67.5 | 855 | 0.7 | 888.93
292.5 | 3769 | 3.02 | 39062.05 | 22.5 | 2762 | 2.21 | 6807.33 | 45 | 2955 | 2.37 | 8627.19 | 67.5 | 862 | 0.68 | 870.83
292.5 | 3774 | 3.02 | 38152.44 | 22.5 | 2754 | 2.21 | 6837.66 | 45 | 2954 | 2.36 | 8553.95 | 67.5 | 854 | 0.69 | 879.86
292.5 | 3771 | 3.02 | 38798.1 | 22.5 | 2755 | 2.2 | 6777.18 | 45 | 2963 | 2.36 | 8543.56 | 67.5 | 860 | 0.68 | 869.55
292.5 | 3771 | 3.02 | 38408.32 | 22.5 | 2758 | 2.2 | 6784.7 | 45 | 2960 | 2.37 | 8637.72 | 67.5 | 854 | 0.69 | 877.28
292.5 | 3771 | 3.02 | 38408.32 | 22.5 | 2759 | 2.21 | 6807.33 | 45 | 2943 | 2.37 | 8606.17 | 67.5 | 862 | 0.68 | 869.55
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
