Dreamy-Z3r0/VGU-WirelessMeteorologyStation/05 - Literature/Figures/LoRa - Range test - Server signal.jpeg

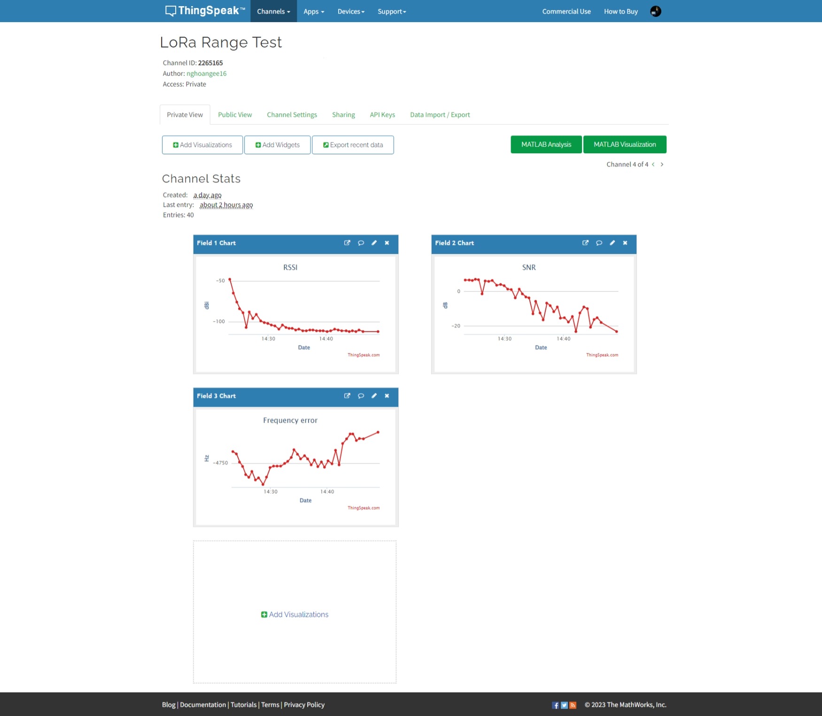
05 - Literature/Figures/LoRa - Range test - Server signal.jpeg
