Dreamy-Z3r0/VGU-WirelessMeteorologyStation/05 - Literature/Figures/microSD - interfacing test - root.PNG

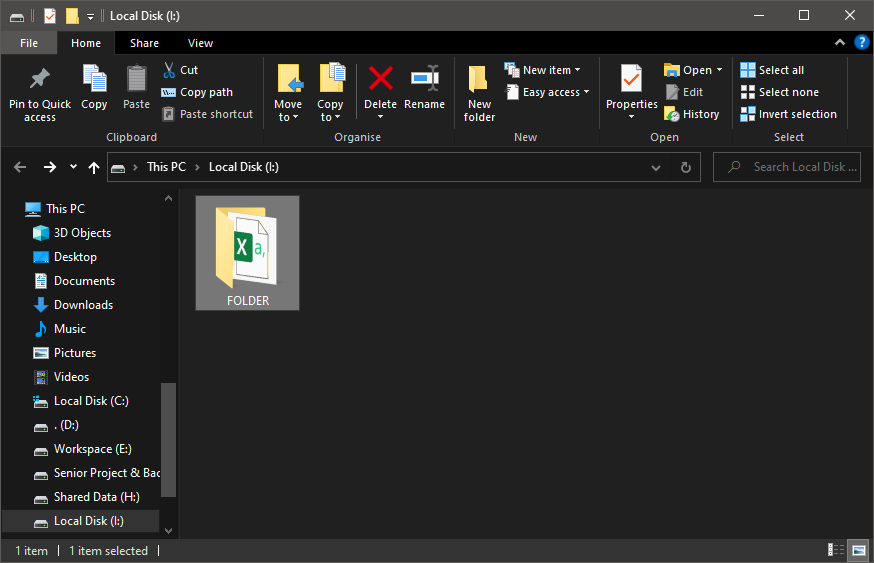
05 - Literature/Figures/microSD - interfacing test - root.PNG
