Dreamy-Z3r0/VGU-WirelessMeteorologyStation/05 - Literature/Figures/OpAmp buffer test - CA3140EZ - Sawtooth/500mHz/(5) 17V5.PNG

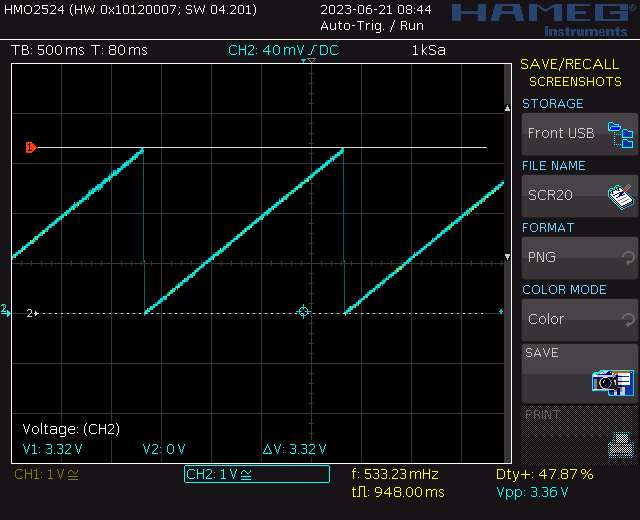
05 - Literature/Figures/OpAmp buffer test - CA3140EZ - Sawtooth/500mHz/(5) 17V5.PNG
