Dreamy-Z3r0/VGU-WirelessMeteorologyStation/05 - Literature/Figures/OpAmp buffer test - CA3140EZ - Sine/(2) 5V.PNG

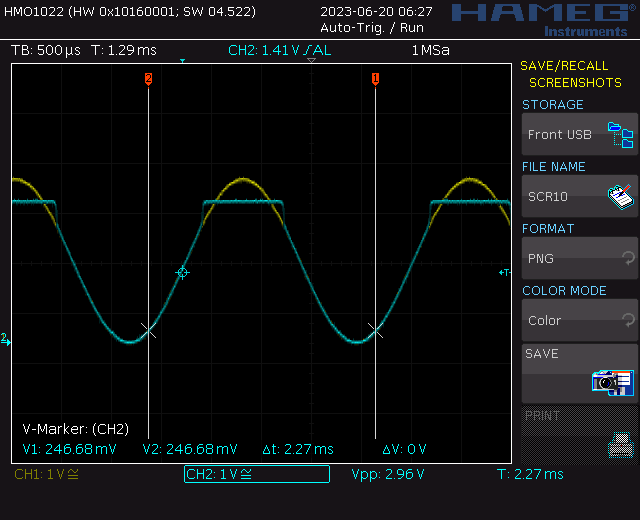
05 - Literature/Figures/OpAmp buffer test - CA3140EZ - Sine/(2) 5V.PNG
