Dreamy-Z3r0/VGU-WirelessMeteorologyStation/05 - Literature/Figures/OpAmp buffer test - CA3140EZ - Sine/(7) 8V5.PNG

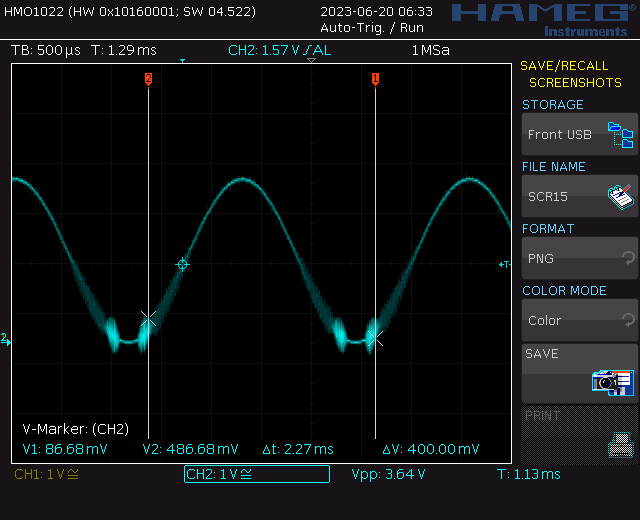
05 - Literature/Figures/OpAmp buffer test - CA3140EZ - Sine/(7) 8V5.PNG
