Dreamy-Z3r0/VGU-WirelessMeteorologyStation/05 - Literature/Figures/OpAmp device test for voltage buffer (3.3V)/UA741CP.PNG

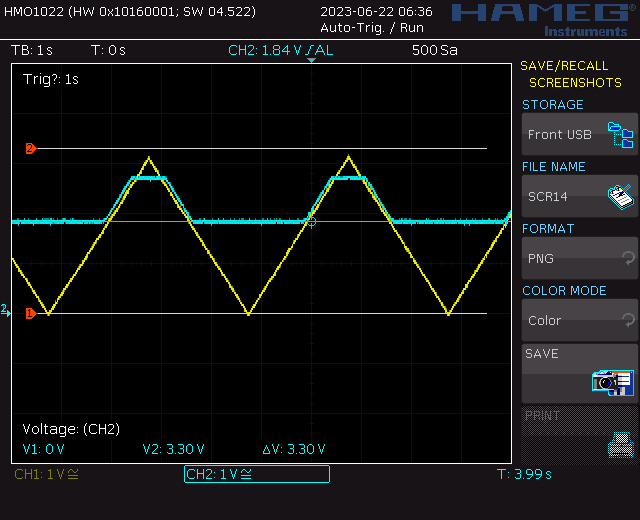
05 - Literature/Figures/OpAmp device test for voltage buffer (3.3V)/UA741CP.PNG
