Dreamy-Z3r0/VGU-WirelessMeteorologyStation/05 - Literature/Figures/RC practicability test circuit.PNG

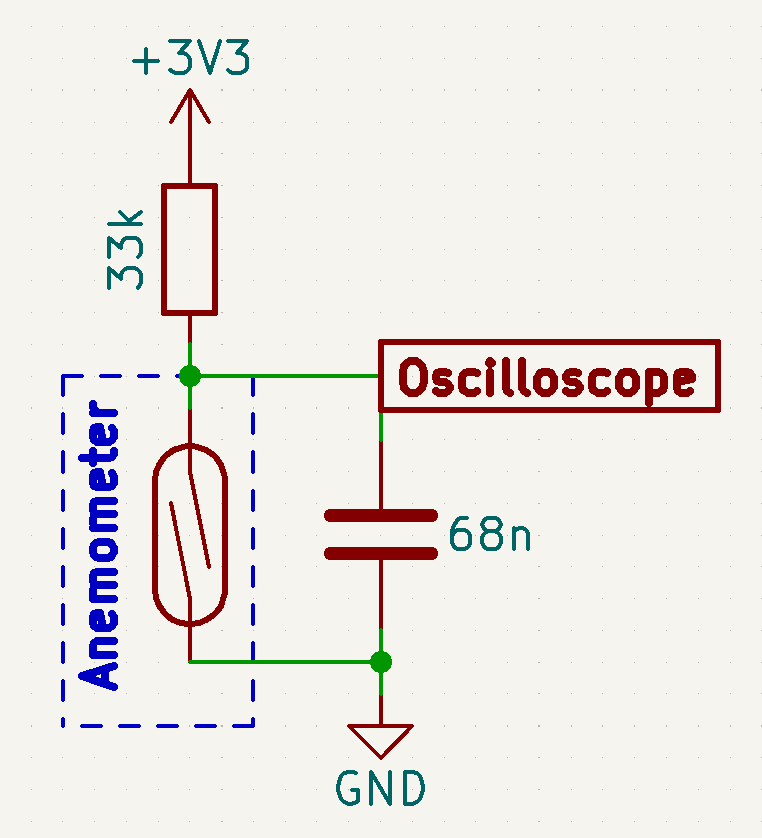
05 - Literature/Figures/RC practicability test circuit.PNG
