Dreamy-Z3r0/VGU-WirelessMeteorologyStation/05 - Literature/Figures/RTC - alarm test.PNG

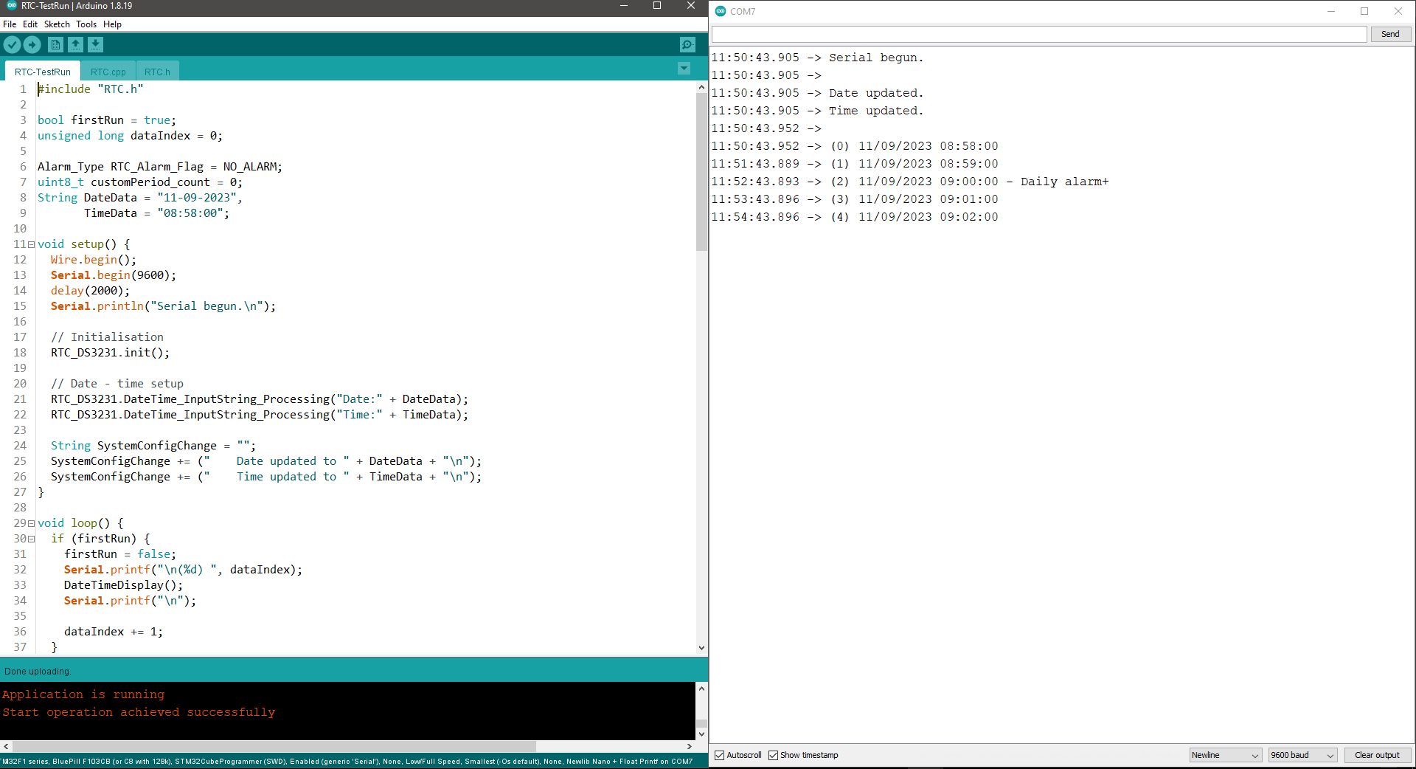
05 - Literature/Figures/RTC - alarm test.PNG
