Dreamy-Z3r0/VGU-WirelessMeteorologyStation/05 - Literature/Figures/RTC and microSD - joint test - halted.PNG

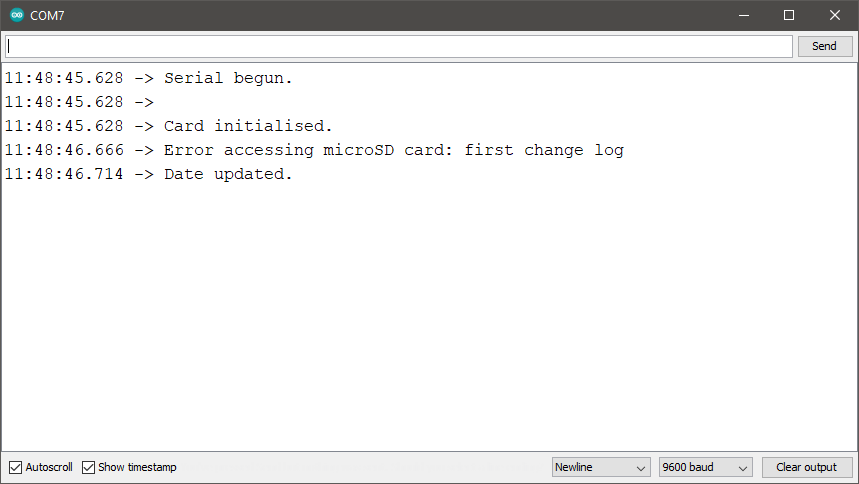
05 - Literature/Figures/RTC and microSD - joint test - halted.PNG
