Dreamy-Z3r0/VGU-WirelessMeteorologyStation/05 - Literature/Figures/Server test - private view.jpeg

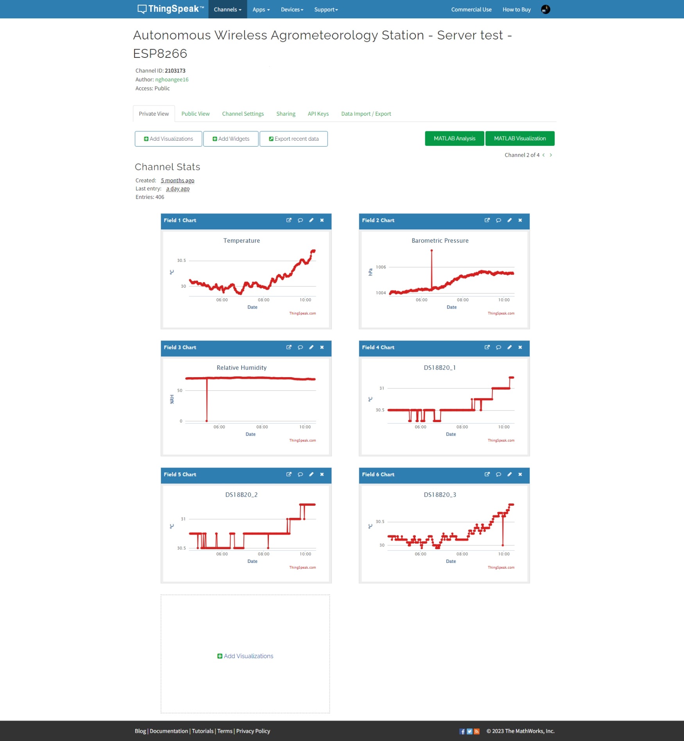
05 - Literature/Figures/Server test - private view.jpeg
