Dreamy-Z3r0/VGU-WirelessMeteorologyStation/05 - Literature/Figures/Server test - public view - 60 data points per chart.jpeg

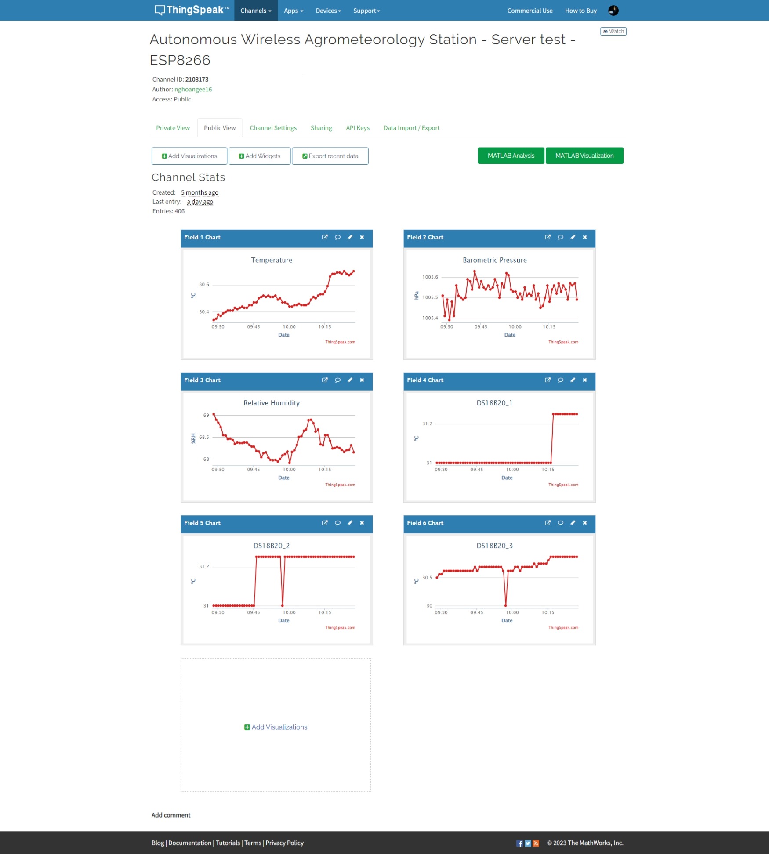
05 - Literature/Figures/Server test - public view - 60 data points per chart.jpeg
