Dreamy-Z3r0/VGU-WirelessMeteorologyStation/01 - Simulations/LM317 output simulation/V_out and V_adj from V_in.pdf

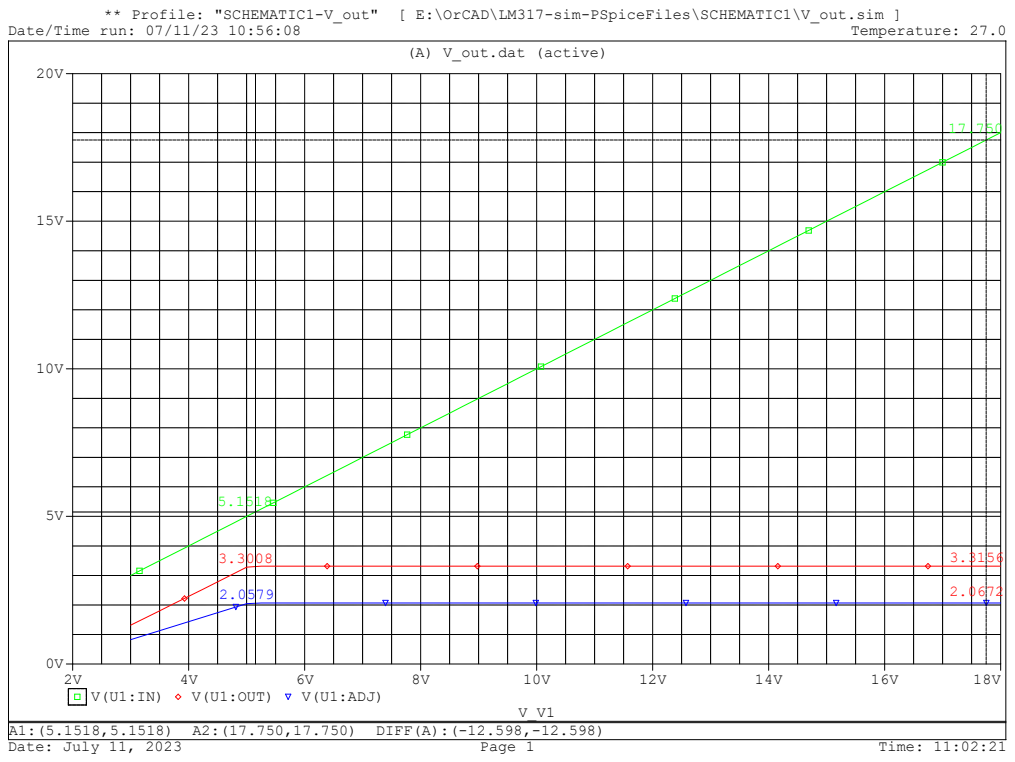
[picture p66: page 1]
A1:(5.1518,5.1518) A2:(17.750,17.750) DIFF(A):(-12.598,-12.598); Temperature: 27.0; Date: July 11, 2023; Page 1; Time: 11:02:21; (A) V_out.dat (active); V(U1:OUT); V(U1:ADJ)

** Profile: "SCHEMATIC1-V_out" [ E:\OrCAD\LM317-sim-PSpiceFiles\SCHEMATIC1\V_out.sim ]

Date/Time run: 07/11/23 10:56:08
