Dreamy-Z3r0/VGU-WirelessMeteorologyStation/01 - Simulations/LM317 output simulation/Simulation setup.pdf

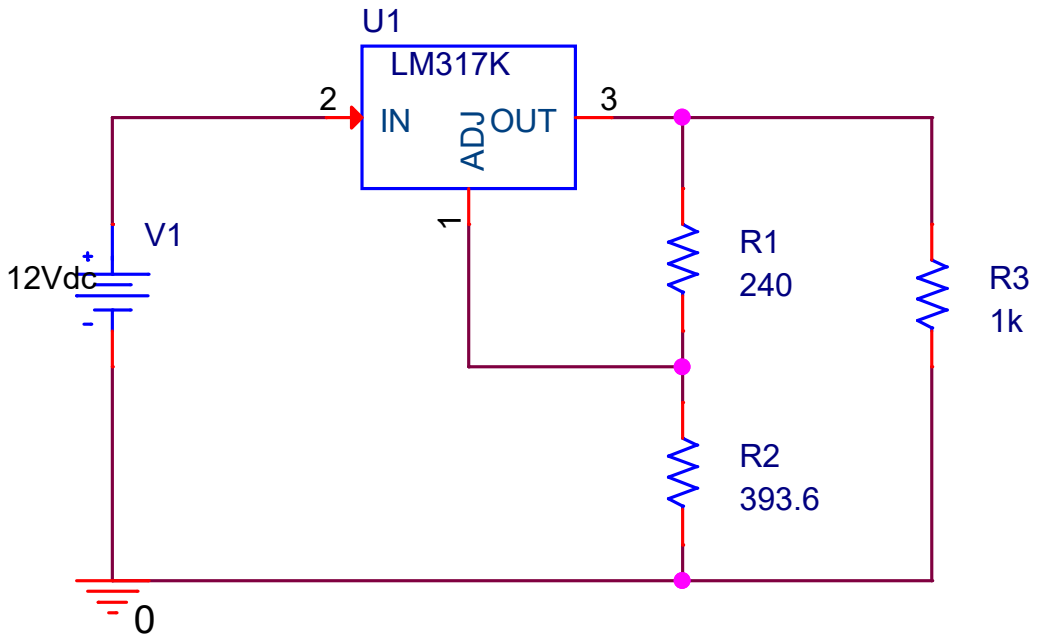
[picture p67: page 1]
Title; Size; Document Number; Rev; Date:; Sheet; <Doc>; <RevCode>; <Title>; Tuesday, July 11, 2023; OUT 3 ADJ 1V1; 12Vdc
