Dreamy-Z3r0/VGU-WirelessMeteorologyStation/03 - Hardware/01-Beta-PCB-From-Breadboard/Schematic.pdf

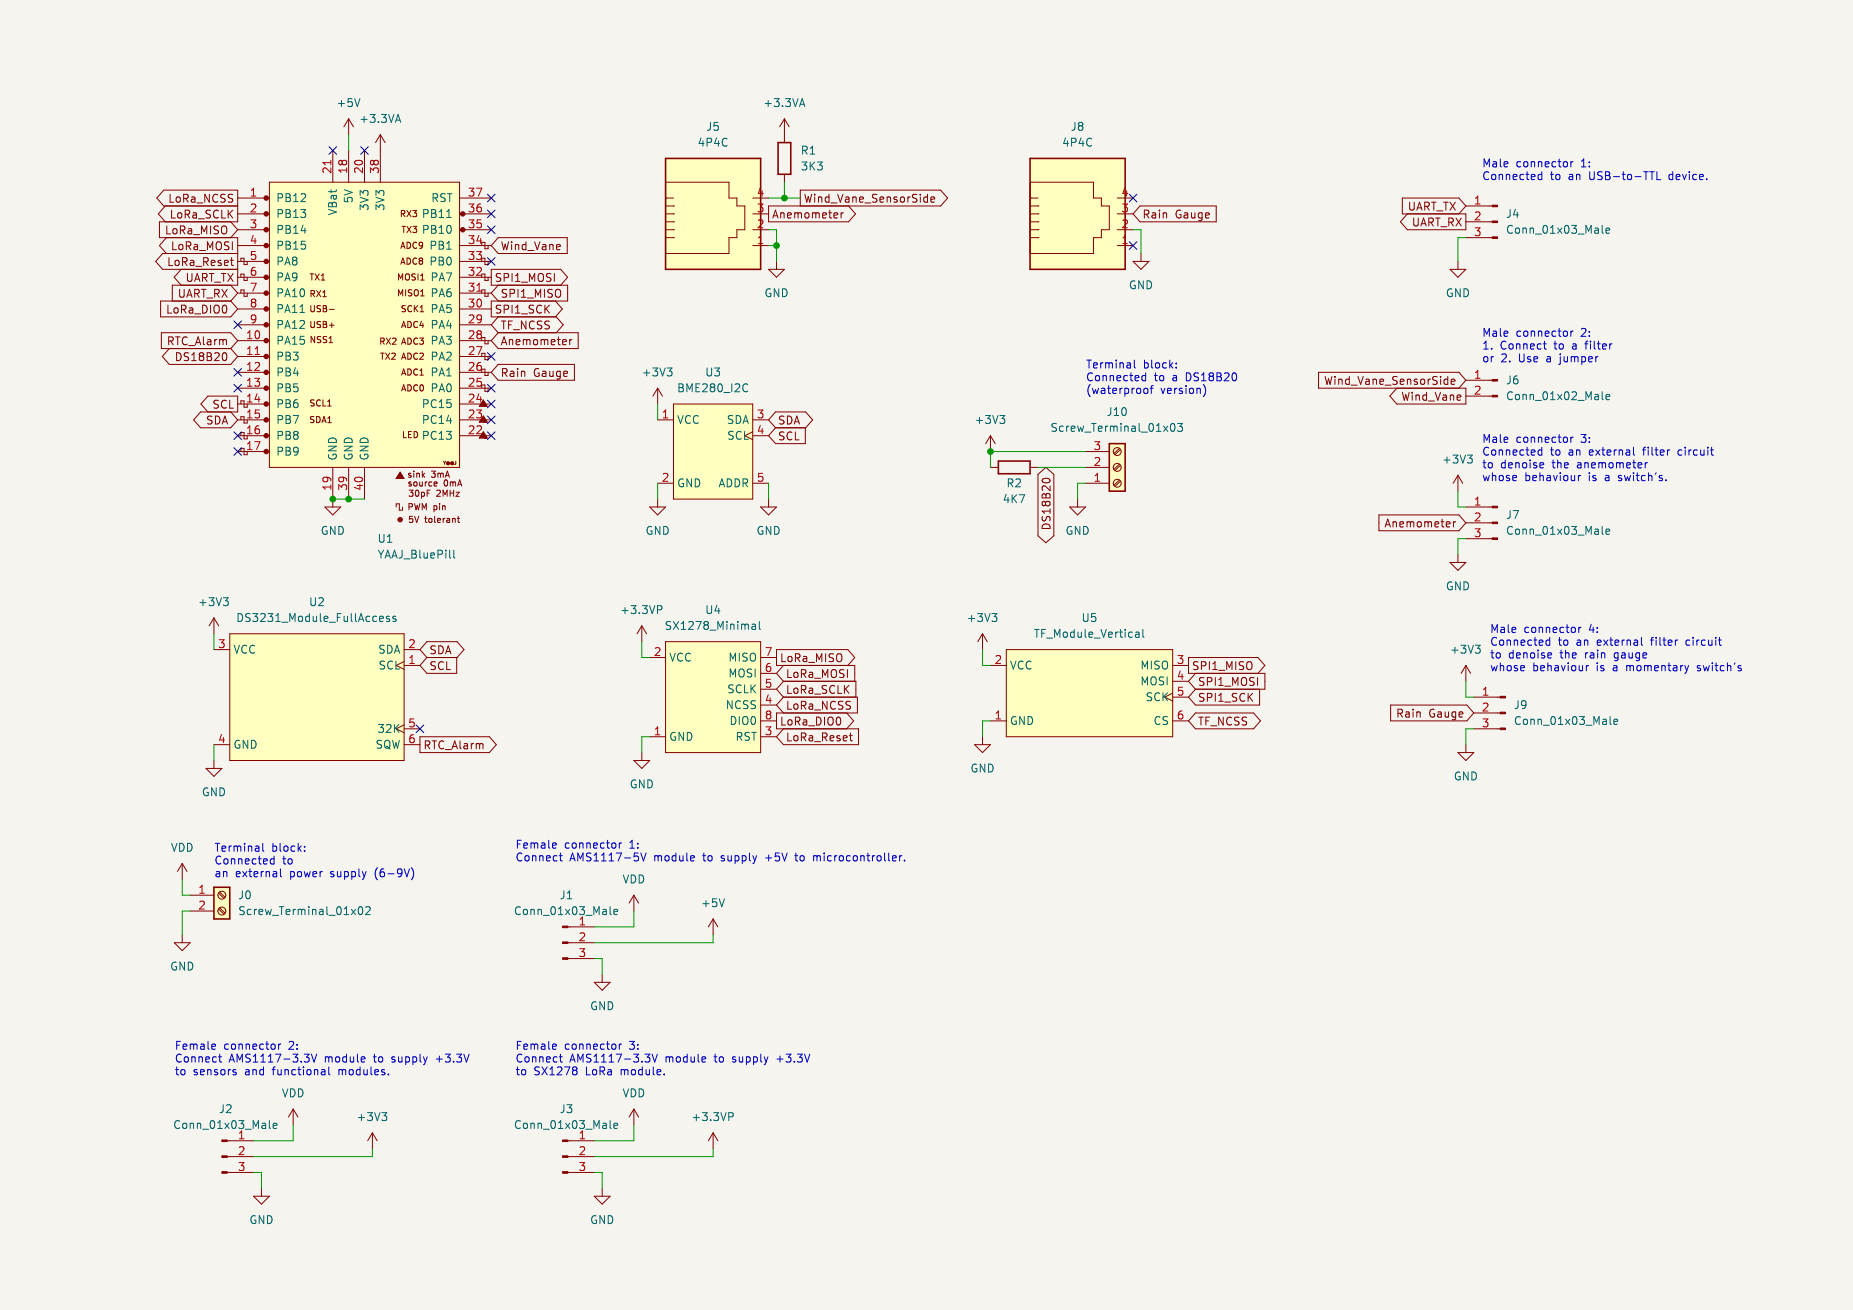
[picture p68: page 1]
