Dreamy-Z3r0/VGU-WirelessMeteorologyStation/03 - Hardware/09-Prototype-Final/gerber/copper_layers.pdf

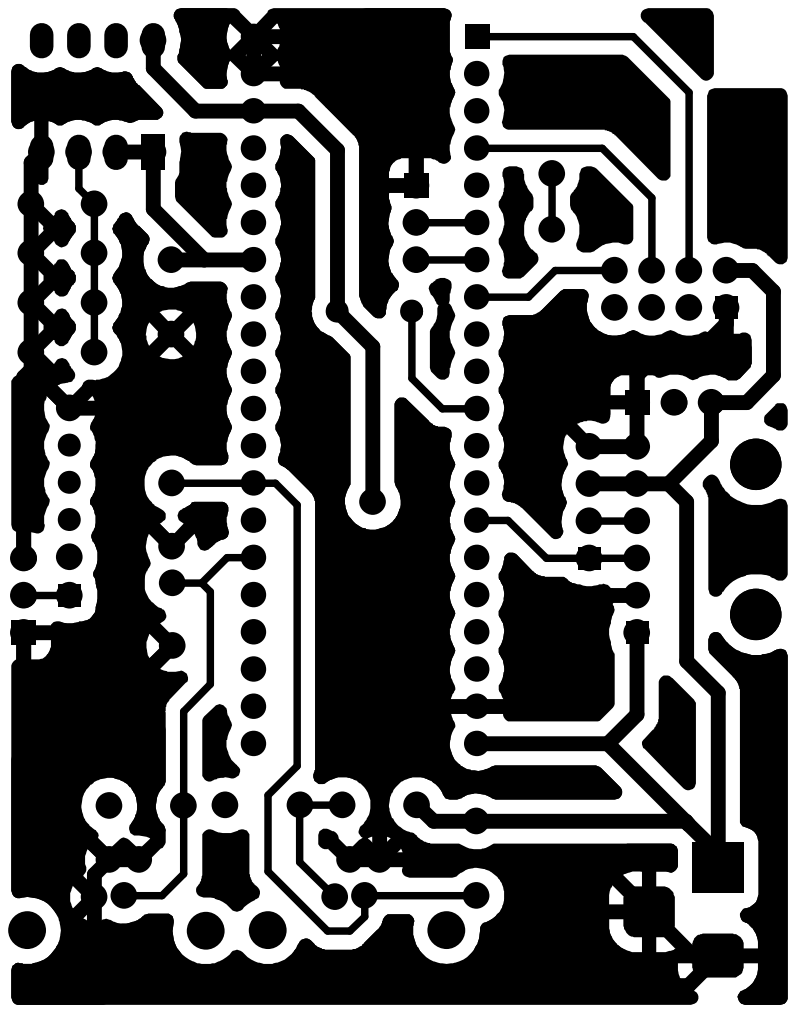
[picture p69: page 1]

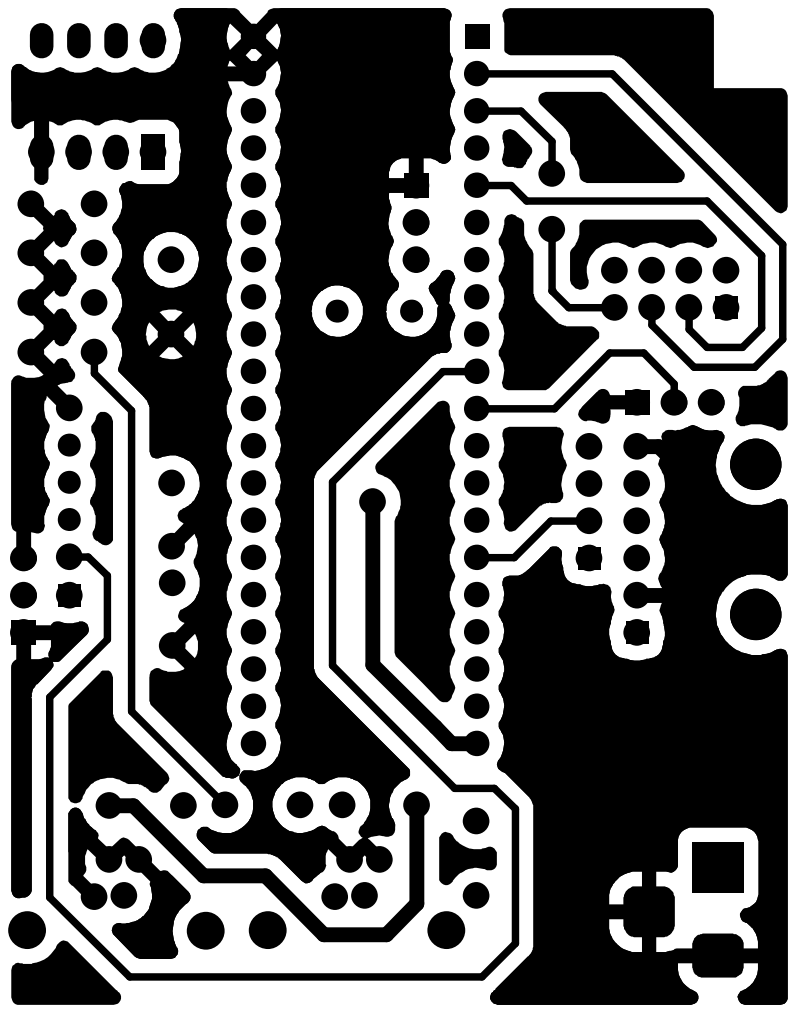
[picture p70: page 2]
