Dreamy-Z3r0/VGU-WirelessMeteorologyStation/(list of files, drawings)

Other design files:
01 - Simulations/Archive - from Senior Project/LPF/Analog RC Filter/01-ChebyshevLPF/CHEBYSHEVLPF.DSN
01 - Simulations/Archive - from Senior Project/LPF/Analog RC Filter/01-ChebyshevLPF/ChebyshevLPF.opj
01 - Simulations/LPF/Analog RC Filter/01-ChebyshevLPF/CHEBYSHEVLPF.DSN
01 - Simulations/LPF/Analog RC Filter/01-ChebyshevLPF/ChebyshevLPF.opj
