Dreamy-Z3r0/VGU-WirelessMeteorologyStation/03 - Hardware/10-Prototype-SMT/10-Prototype-SMT.kicad_pcb

## KiCad design 03 - Hardware/10-Prototype-SMT/10-Prototype-SMT.kicad_pcb (2023-10-22)

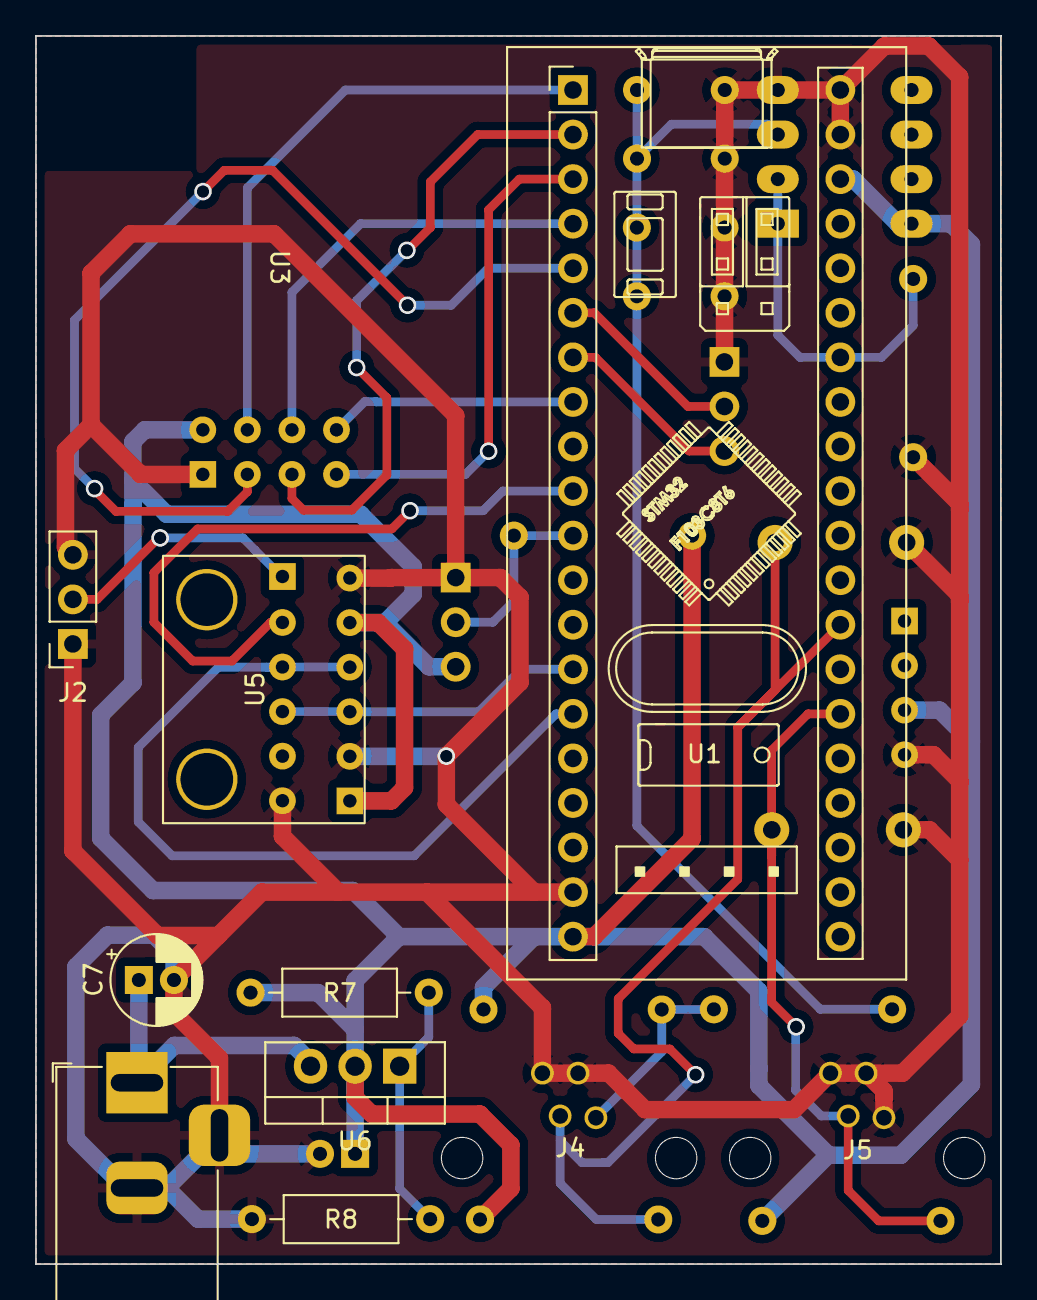
[picture p71: board 10-Prototype-SMT.kicad_pcb from above]

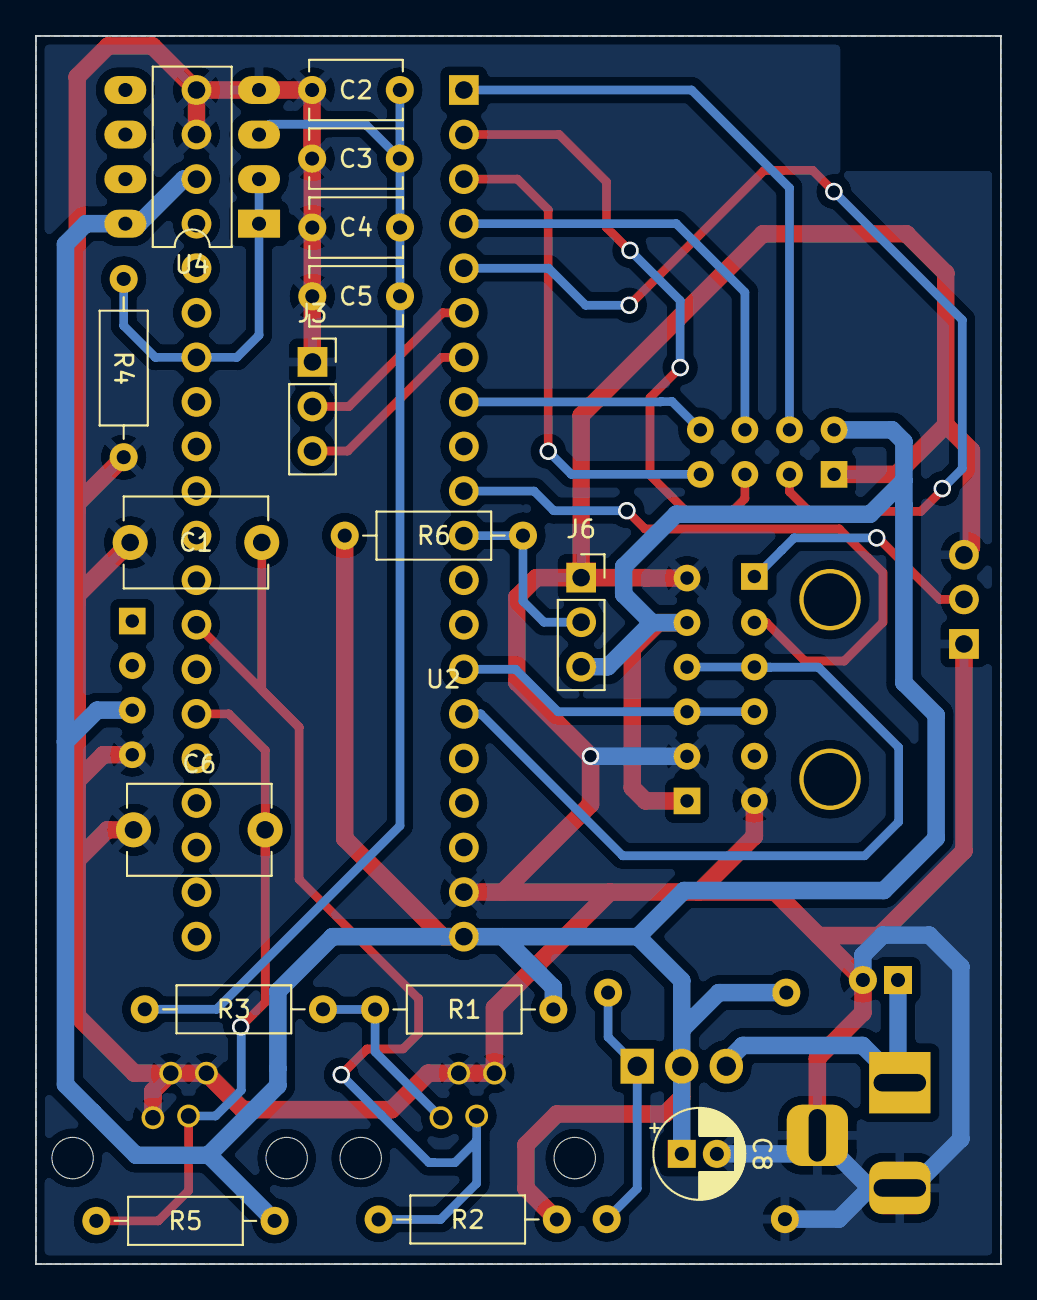
[picture p72: board 10-Prototype-SMT.kicad_pcb from below]

Board: 2 copper layers, 55.0 x 70.0 mm, 28 parts (17 on the bottom side), 22 nets.

Parts:
C1, C6: 68n; C_Disc_D8.0mm_W5.0mm_P7.50mm
C2: 10n; C_Disc_D5.1mm_W3.2mm_P5.00mm
C3: 4.7n; C_Disc_D5.1mm_W3.2mm_P5.00mm
C4: 3.3n; C_Disc_D5.1mm_W3.2mm_P5.00mm
C5: 2.2n; C_Disc_D5.1mm_W3.2mm_P5.00mm
C7: 0.1u; CP_Radial_D5.0mm_P2.00mm
C8: 1u; CP_Radial_D5.0mm_P2.00mm
J1: Barrel_Jack; BarrelJack_Horizontal
J2, J3, J6: Conn_01x03_Male; PinSocket_1x03_P2.54mm_Vertical
J4, J5: 4P4C
R1: 3k; R_Axial_DIN0207_L6.3mm_D2.5mm_P10.16mm_Horizontal
R2, R5: 33k; R_Axial_DIN0207_L6.3mm_D2.5mm_P10.16mm_Horizontal
R3: 680; R_Axial_DIN0207_L6.3mm_D2.5mm_P10.16mm_Horizontal
R4: 3.3k; R_Axial_DIN0207_L6.3mm_D2.5mm_P10.16mm_Horizontal
R6: 4.7k; R_Axial_DIN0207_L6.3mm_D2.5mm_P10.16mm_Horizontal
R7: 240; R_Axial_DIN0207_L6.3mm_D2.5mm_P10.16mm_Horizontal
R8: 390; R_Axial_DIN0207_L6.3mm_D2.5mm_P10.16mm_Horizontal
U1: YAAJ_BluePill; YAAJ_BluePill_1
U2: DS3231_Full_Pinout; DS3231_Module_FullSize
U3: SX1278_Minimal
U4: MCP6002-xP; DIP-8_W7.62mm_LongPads
U5: BME280_I2C_New_LK888; BME280_I2C_Small
U6: LM317_TO-220; TO-220-3_Vertical

Connections:
+3V3: C8.1, J6.3, R1.1, R2.1, R5.1, R6.1, R7.2, U1.20 (3V3), U1.38 (3V3), U2.3 (VCC), U3.2 (VCC), U4.8 (V+), U5.1 (VCC), U6.2 (VO)
/32768Hz out: J2.2, U2.5 (32K)
/Passive LPF: C2.1, C3.1, C4.1, C5.1, R3.2, U4.3 (+)
/V_adj: R7.1, R8.1, U6.1 (ADJ)
Anemometer: C1.2, J4.3, R2.2, U1.28 (PA3)
DS18B20: J6.2, R6.2, U1.11 (PB3)
GND: C1.1, C2.2, C3.2, C4.2, C5.2, C6.1, C7.2, C8.2, J1.2, J1.3, J2.1, J2.3, J3.1, J4.1, J4.2, J5.1, J5.2, J5.4, J6.1, R4.1, R8.2, U1.19 (GND), U1.39 (GND), U1.40 (GND), U2.4 (GND), U2.10 (GND), U3.1 (GND), U4.4 (V-), U5.2 (GND), U5.5 (ADDR)
I2C_CLK: U1.14 (PB6), U2.7 (SCL), U5.3 (SCL)
I2C_SDA: U1.15 (PB7), U2.8 (SDA), U5.4 (SDA)
LoRa_DIO0: U1.8 (PA11), U3.8 (DIO0)
LoRa_MISO: U1.3 (PB14), U3.7 (MISO)
LoRa_MOSI: U1.4 (PB15), U3.6 (MOSI)
LoRa_NCSS: U1.1 (PB12), U3.4 (NCSS)
LoRa_Reset: U1.5 (PA8), U3.3 (RST)
LoRa_SCLK: U1.2 (PB13), U3.5 (SCLK)
RTC_ALARM: U1.10 (PA15), U2.6 (SQW)
Rain_Gauge: C6.2, J5.3, R5.2, U1.26 (PA1)
UART_RX: J3.3, U1.7 (PA10)
UART_TX: J3.2, U1.6 (PA9)
VCC: C7.1, J1.1, U6.3 (VI)
WindVane_raw: J4.4, R1.2, R3.1
Wind_Vane: R4.2, U1.34 (PB1), U4.1, U4.2 (-)
