Dreamy-Z3r0/VGU-WirelessMeteorologyStation/03 - Hardware/06-LM317/06-LM317.kicad_pcb

## KiCad design 03 - Hardware/06-LM317/06-LM317.kicad_pcb (2023-10-22)

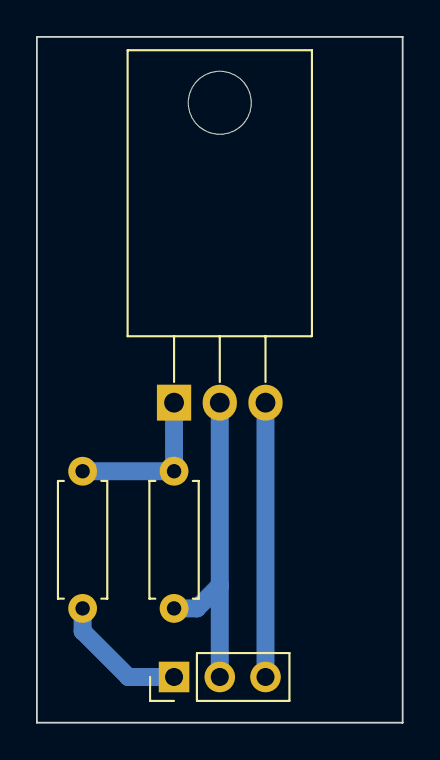
[picture p73: board 06-LM317.kicad_pcb from above]

Board: 2 copper layers, 20.3 x 38.1 mm, 4 parts (0 on the bottom side), 4 nets.

Parts:
J1: Conn_01x03_Male; PinHeader_1x03_P2.54mm_Vertical
R1: 240; R_Axial_DIN0207_L6.3mm_D2.5mm_P7.62mm_Horizontal
R2: 390; R_Axial_DIN0207_L6.3mm_D2.5mm_P7.62mm_Horizontal
U1: LM317_TO-220; TO-220-3_Horizontal_TabDown

Connections:
/ADJ: R1.2, R2.1, U1.1 (ADJ)
GND: J1.1, R2.2
VIN: J1.3, U1.3 (VI)
VOUT: J1.2, R1.1, U1.2 (VO)
