Dreamy-Z3r0/VGU-WirelessMeteorologyStation/03 - Hardware/07-LM317-RippleRejection/07-LM317-RippleRejection.kicad_pcb

## KiCad design 03 - Hardware/07-LM317-RippleRejection/07-LM317-RippleRejection.kicad_pcb (2023-10-22)

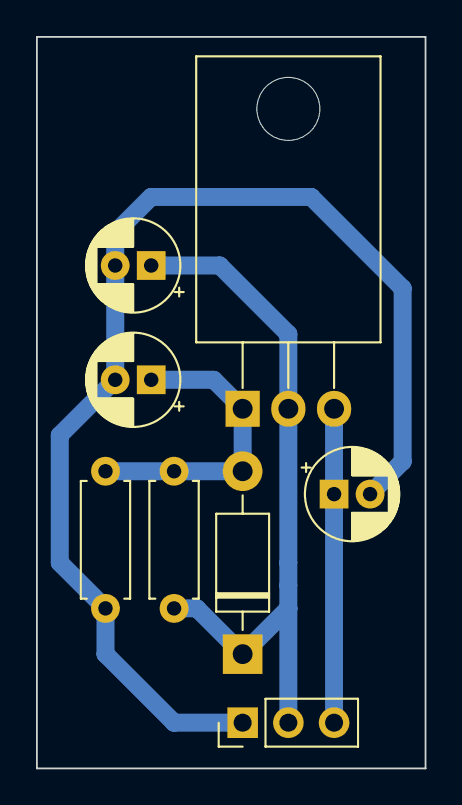
[picture p74: board 07-LM317-RippleRejection.kicad_pcb from above]

Board: 2 copper layers, 21.6 x 40.6 mm, 8 parts (0 on the bottom side), 4 nets.

Parts:
C1: 0.1u; CP_Radial_D5.0mm_P2.00mm
C2: 10u; CP_Radial_D5.0mm_P2.00mm
C3: 1u; CP_Radial_D5.0mm_P2.00mm
D1: 1N4007; D_DO-41_SOD81_P10.16mm_Horizontal
J1: Conn_01x03_Male; PinHeader_1x03_P2.54mm_Vertical
R1: 240; R_Axial_DIN0207_L6.3mm_D2.5mm_P7.62mm_Horizontal
R2: 390; R_Axial_DIN0207_L6.3mm_D2.5mm_P7.62mm_Horizontal
U1: LM317_TO-220; TO-220-3_Horizontal_TabDown

Connections:
/ADJ: C2.1, D1.2 (A), R1.2, R2.1, U1.1 (ADJ)
GND: C1.2, C2.2, C3.2, J1.1, R2.2
VIN: C1.1, J1.3, U1.3 (VI)
VOUT: C3.1, D1.1 (K), J1.2, R1.1, U1.2 (VO)
