Dreamy-Z3r0/VGU-WirelessMeteorologyStation/03 - Hardware/05-Prototype-UpdatedComponents/05-Prototype-UpdatedComponents.kicad_pcb

## KiCad design 03 - Hardware/05-Prototype-UpdatedComponents/05-Prototype-UpdatedComponents.kicad_pcb (2023-10-22)

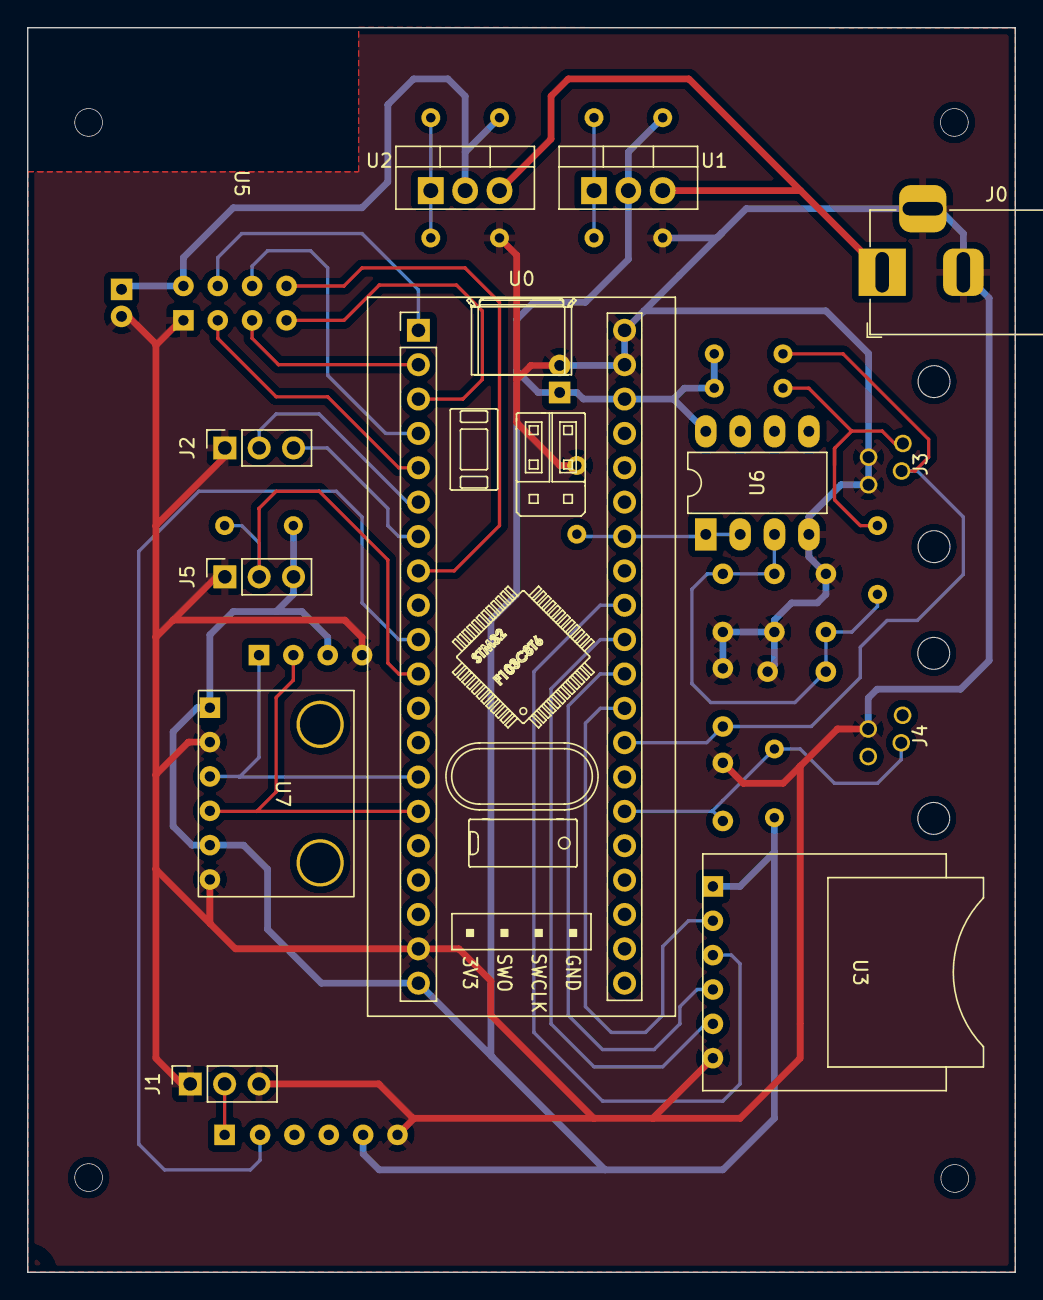
[picture p75: board 05-Prototype-UpdatedComponents.kicad_pcb from above]

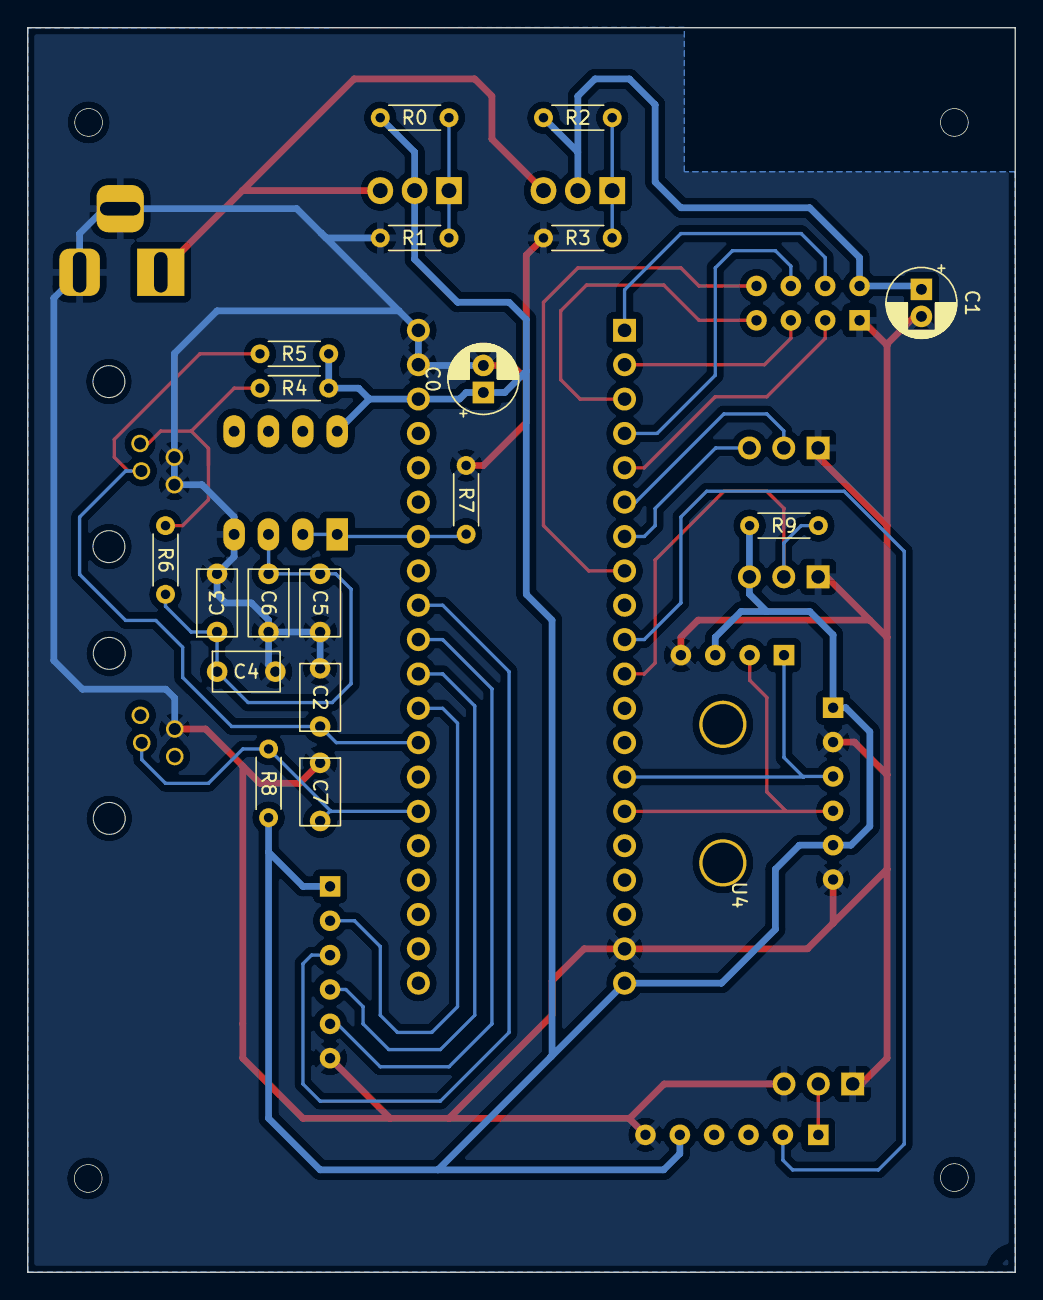
[picture p76: board 05-Prototype-UpdatedComponents.kicad_pcb from below]

Board: 2 copper layers, 73.0 x 92.0 mm, 32 parts (19 on the bottom side), 28 nets.

Parts:
C0, C1: 1u; CP_Radial_D5.0mm_P2.00mm
C2, C7: 68n; C_Radial_W5.5mm_H9.0mm_T3.0mm_P4.3mm
C3: 10n; C_Radial_W5.5mm_H9.0mm_T3.0mm_P4.3mm
C4: 4.7n; C_Radial_W5.5mm_H9.0mm_T3.0mm_P4.3mm
C5: 3.3n; C_Radial_W5.5mm_H9.0mm_T3.0mm_P4.3mm
C6: 2.2n; C_Radial_W5.5mm_H9.0mm_T3.0mm_P4.3mm
J0: Barrel_Jack; BarrelJack_Horizontal
J1, J2, J5: Conn_01x03_Male; PinSocket_1x03_P2.54mm_Vertical
J3, J4: 4P4C
R0, R2: 240; R_Axial_DIN0204_L3.6mm_D1.6mm_P5.08mm_Horizontal
R1, R3: 390; R_Axial_DIN0204_L3.6mm_D1.6mm_P5.08mm_Horizontal
R4, R7: 3.3k; R_Axial_DIN0204_L3.6mm_D1.6mm_P5.08mm_Horizontal
R5, R8: 33k; R_Axial_DIN0204_L3.6mm_D1.6mm_P5.08mm_Horizontal
R6: 680; R_Axial_DIN0204_L3.6mm_D1.6mm_P5.08mm_Horizontal
R9: 4.7k; R_Axial_DIN0204_L3.6mm_D1.6mm_P5.08mm_Horizontal
U0: YAAJ_BluePill; YAAJ_BluePill_1
U1, U2: LM317_TO-220; TO-220-3_Vertical
U3: microSD_Module_3V3_Horizontal; microSD_mini
U4: DS3231_Module_FullAccess; DS3231_Module_FullSize
U5: SX1278_Minimal
U6: MCP6002-xP; DIP-8_W7.62mm_LongPads
U7: BME280_I2C_New_LK888; BME280_I2C_Small

Connections:
+3.3VP: C1.1, R2.1, U2.2 (VO), U5.2 (VCC)
+3V3: C0.1, J5.3, R0.1, R4.1, R5.1, R8.1, R9.1, U0.20 (3V3), U0.38 (3V3), U1.2 (VO), U3.1 (3V3), U4.3 (VCC), U6.8 (V+), U7.1 (VCC)
+VDC: J0.1, U1.3 (VI), U2.3 (VI)
/32768Hz out: J1.2, U4.5 (32K)
/Passive LPF: C3.1, C4.1, C5.1, C6.1, R6.2, U6.3 (+)
/V_adj: R0.2, R1.1, U1.1 (ADJ)
/V_adj_VP: R2.2, R3.1, U2.1 (ADJ)
Anemometer: C2.2, J3.3, R5.2, U0.28 (PA3)
DS18B20: J5.2, R9.2, U0.11 (PB3)
GND: C0.2, C1.2, C2.1, C3.2, C4.2, C5.2, C6.2, C7.1, J0.2, J0.3, J1.1, J1.3, J2.1, J3.1, J3.2, J4.2, J5.1, R1.2, R3.2, R7.1, U0.19 (GND), U0.39 (GND), U0.40 (GND), U3.6 (GND), U4.4 (GND), U5.1 (GND), U6.4 (V-), U7.2 (GND), U7.5 (ADDR)
I2C_CLK: U0.14 (PB6), U4.1 (SCL), U7.3 (SCL)
I2C_SDA: U0.15 (PB7), U4.2 (SDA), U7.4 (SDA)
LoRa_DIO0: U0.8 (PA11), U5.8 (DIO0)
LoRa_MISO: U0.3 (PB14), U5.7 (MISO)
LoRa_MOSI: U0.4 (PB15), U5.6 (MOSI)
LoRa_NCSS: U0.1 (PB12), U5.4 (NCSS)
LoRa_Reset: U0.5 (PA8), U5.3 (RST)
LoRa_SCLK: U0.2 (PB13), U5.5 (SCLK)
MICROSD_NCSS: U0.29 (PA4), U3.2 (CS)
RTC_ALARM: U0.10 (PA15), U4.6 (SQW)
Rain gauge: C7.2, J4.3, R8.2, U0.26 (PA1)
SPI1_MISO: U0.31 (PA6), U3.5 (MISO)
SPI1_MOSI: U0.32 (PA7), U3.3 (MOSI)
SPI1_SCK: U0.30 (PA5), U3.4 (CLK)
UART_RX: J2.3, U0.7 (PA10)
UART_TX: J2.2, U0.6 (PA9)
WindVane_filtered: R7.2, U0.34 (PB1), U6.1, U6.2 (-)
WindVane_raw: J3.4, R4.2, R6.1
