Dreamy-Z3r0/VGU-WirelessMeteorologyStation/03 - Hardware/04-BuckConverter/04-BuckConverter.kicad_pcb

## KiCad design 03 - Hardware/04-BuckConverter/04-BuckConverter.kicad_pcb (2023-04-22)

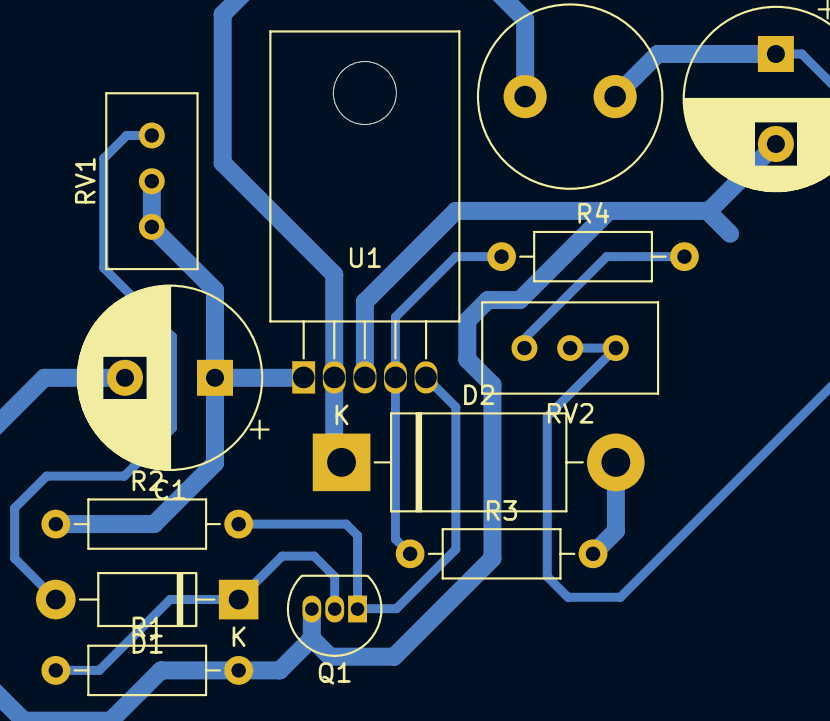
[picture p77: board 04-BuckConverter.kicad_pcb from above]

Board: 2 copper layers, 13 parts (0 on the bottom side), 9 nets.

Parts:
C1: 470u; CP_Radial_D10.0mm_P5.00mm
C2: 220n; CP_Radial_D10.0mm_P5.00mm
D1: 1N47xxA; D_DO-41_SOD81_P10.16mm_Horizontal
D2: SR540; D_DO-201AD_P15.24mm_Horizontal
L1: 68u; L_Radial_D10.0mm_P5.00mm_Neosid_SD12k_style3
Q1: BC548; TO-92_Inline
R1, R2: 47k; R_Axial_DIN0207_L6.3mm_D2.5mm_P10.16mm_Horizontal
R3, R4: 1k; R_Axial_DIN0207_L6.3mm_D2.5mm_P10.16mm_Horizontal
RV1, RV2: 1k; Potentiometer_Bourns_3296W_Vertical
U1: LM2596-ADJ; LM2596-ADJ-Horizontal-THT

Connections:
Earth: C1.2, C2.2, D2.2 (A), Q1.3 (E), R1.2, R3.2, U1.3 (GND)
unnamed: D1.1 (K), Q1.2 (B), R1.1
unnamed: D1.2 (A), RV1.1
unnamed: D2.1 (K), L1.1, U1.2 (OUT)
unnamed: C2.1, L1.2, RV2.2, RV2.3
unnamed: R3.1, R4.1, U1.4 (FB)
unnamed: R4.2, RV2.1
unnamed: C1.1, R2.1, RV1.2, RV1.3, U1.1 (VIN)
unnamed: Q1.1 (C), R2.2, U1.5 (~ON/OFF)
