Dreamy-Z3r0/VGU-WirelessMeteorologyStation/03 - Hardware/01-Beta-PCB-From-Breadboard/01-Beta-PCB-From-Breadboard.kicad_pcb

## KiCad design 03 - Hardware/01-Beta-PCB-From-Breadboard/01-Beta-PCB-From-Breadboard.kicad_pcb (2023-02-27)

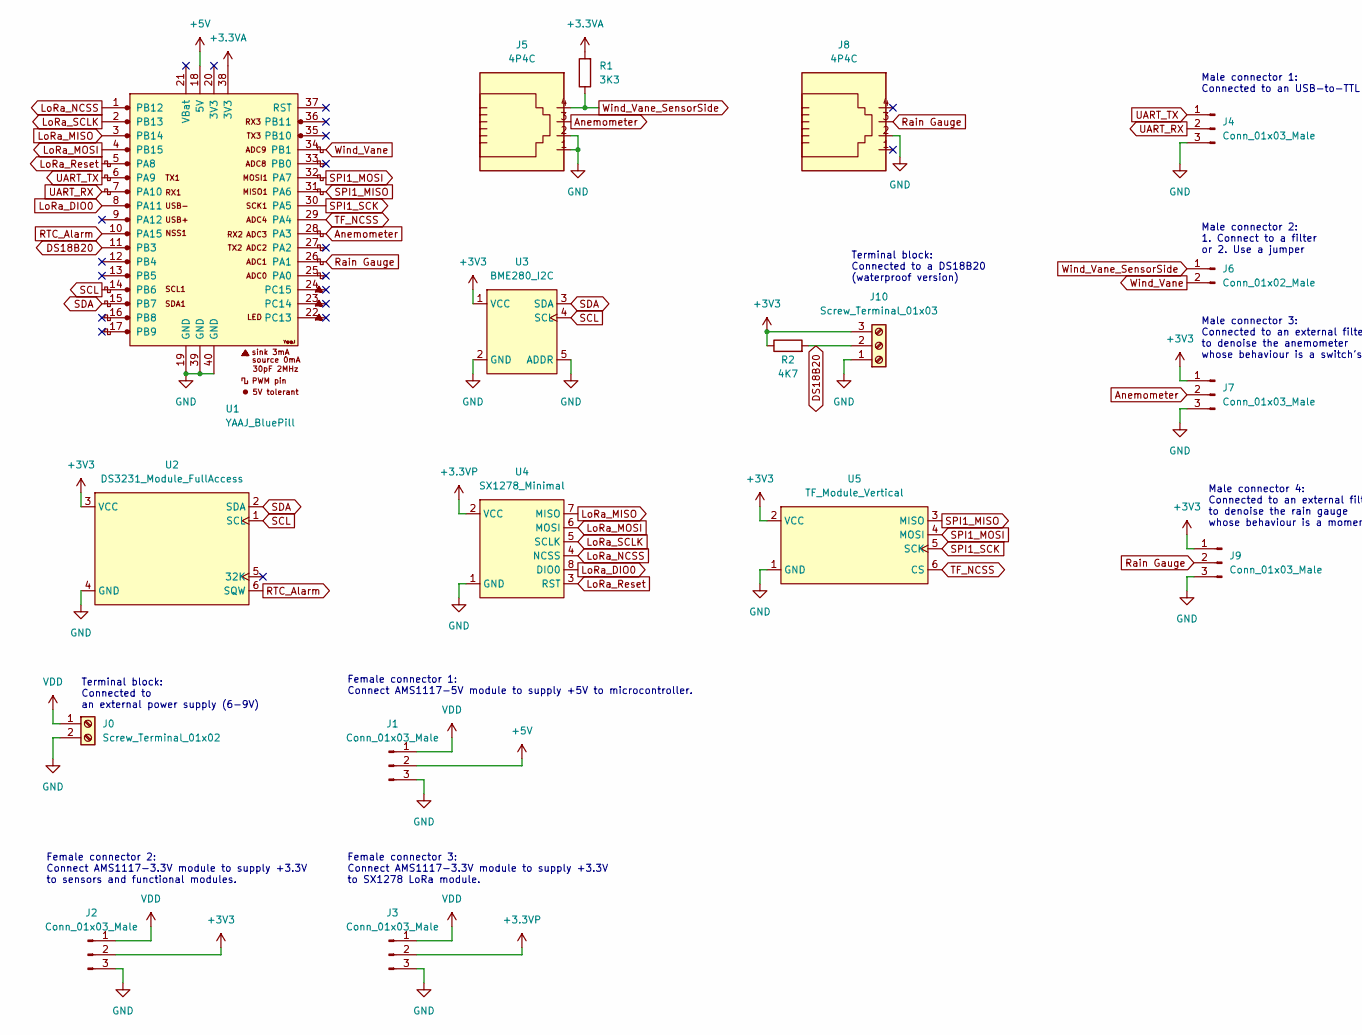
[picture p78: schematic 01-Beta-PCB-From-Breadboard.kicad_sch, First Prototype from Breadboard, part in row 1, column 1]

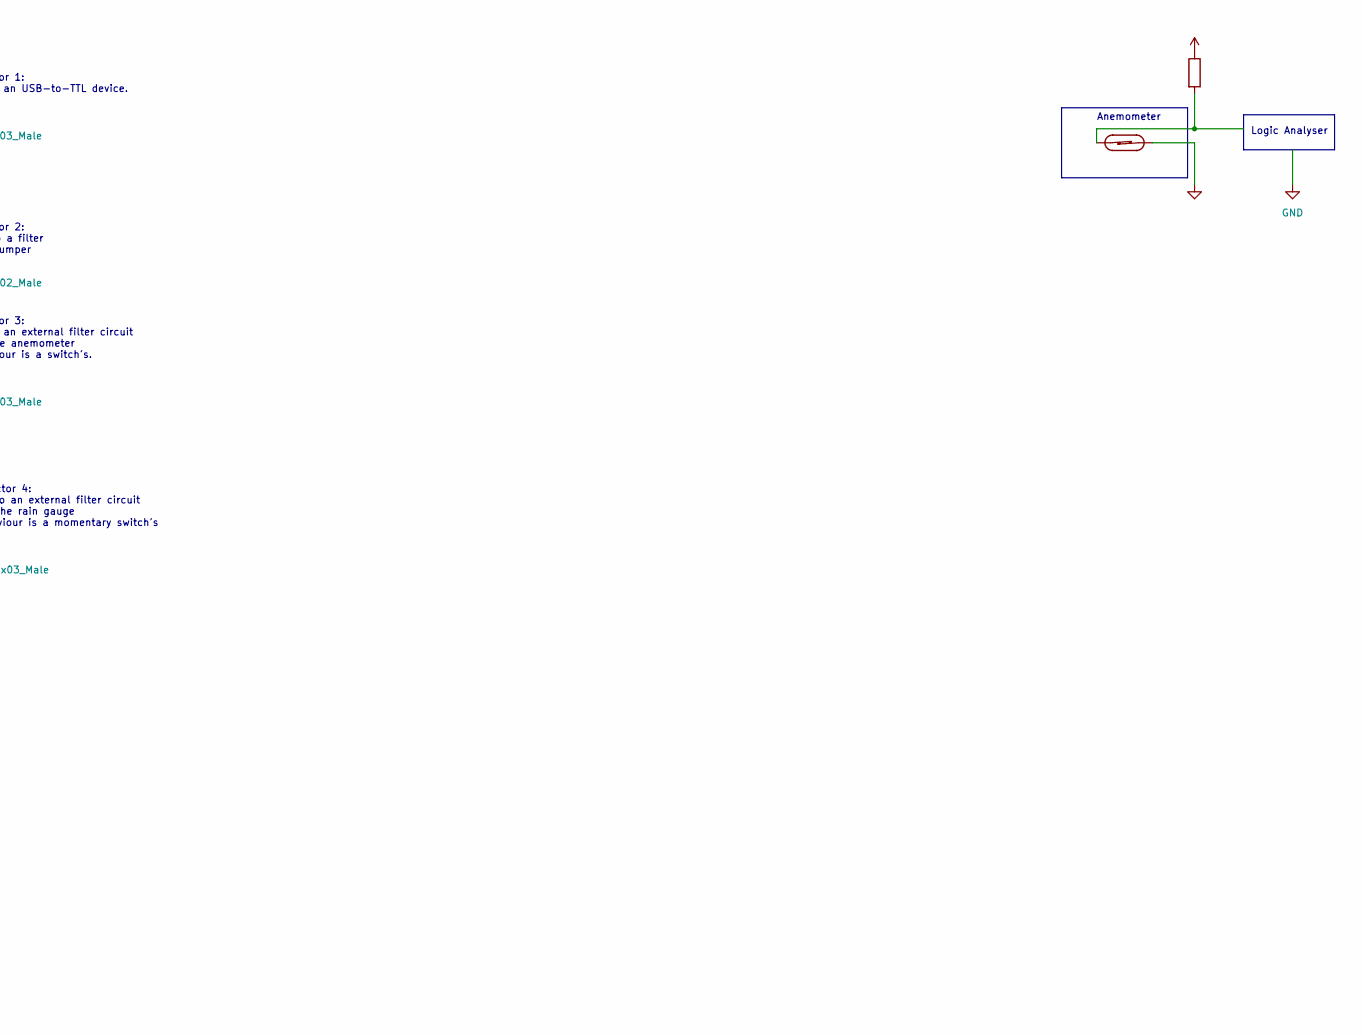
[picture p79: schematic 01-Beta-PCB-From-Breadboard.kicad_sch, First Prototype from Breadboard, part in row 1, column 2]

Parts:
J0: Screw_Terminal_01x02; TerminalBlock_TE_282834-2_1x02_P2.54mm_Horizontal
J1, J2, J3, J4, J7, J9: Conn_01x03_Male; PinHeader_1x03_P2.54mm_Vertical
J5, J8: 4P4C
J6: Conn_01x02_Male; PinHeader_1x02_P2.54mm_Vertical
J10: Screw_Terminal_01x03; TerminalBlock_TE_282834-3_1x03_P2.54mm_Horizontal
R1: 3K3; R_Axial_DIN0207_L6.3mm_D2.5mm_P10.16mm_Horizontal
R2: 4K7; R_Axial_DIN0207_L6.3mm_D2.5mm_P10.16mm_Horizontal
U1: YAAJ_BluePill; YAAJ_BluePill_1
U2: DS3231_Module_FullAccess; DS3231_Module_Minimal
U3: BME280_I2C
U4: SX1278_Minimal
U5: TF_Module_Vertical; TF_Module_Veritcal

Connections:
+3.3VA: R1.2, U1.38 (3V3)
+3.3VP: J3.2, U4.2 (VCC)
+3V3: J2.2, J7.1, J9.1, J10.3, R2.1, U2.3 (VCC), U3.1 (VCC), U5.2 (VCC)
+5V: J1.2, U1.18 (5V)
Anemometer: J5.3, J7.2, U1.28 (PA3)
DS18B20: J10.2, R2.2, U1.11 (PB3)
GND: J0.2, J1.3, J2.3, J3.3, J4.3, J5.1, J5.2, J7.3, J8.2, J9.3, J10.1, U1.19 (GND), U1.39 (GND), U1.40 (GND), U2.4 (GND), U3.2 (GND), U3.5 (ADDR), U4.1 (GND), U5.1 (GND)
LoRa_DIO0: U1.8 (PA11), U4.8 (DIO0)
LoRa_MISO: U1.3 (PB14), U4.7 (MISO)
LoRa_MOSI: U1.4 (PB15), U4.6 (MOSI)
LoRa_NCSS: U1.1 (PB12), U4.4 (NCSS)
LoRa_Reset: U1.5 (PA8), U4.3 (RST)
LoRa_SCLK: U1.2 (PB13), U4.5 (SCLK)
RTC_Alarm: U1.10 (PA15), U2.6 (SQW)
Rain Gauge: J8.3, J9.2, U1.26 (PA1)
SCL: U1.14 (PB6), U2.1 (SCL), U3.4 (SCL)
SDA: U1.15 (PB7), U2.2 (SDA), U3.3 (SDA)
SPI1_MISO: U1.31 (PA6), U5.3 (MISO)
SPI1_MOSI: U1.32 (PA7), U5.4 (MOSI)
SPI1_SCK: U1.30 (PA5), U5.5 (SCK)
TF_NCSS: U1.29 (PA4), U5.6 (CS)
UART_RX: J4.2, U1.7 (PA10)
UART_TX: J4.1, U1.6 (PA9)
VDD: J0.1, J1.1, J2.1, J3.1
Wind_Vane: J6.2, U1.34 (PB1)
Wind_Vane_SensorSide: J5.4, J6.1, R1.1

Notes on the sheet:
Anemometer
Male connector 2: 1. Connect to a filter or 2. Use a jumper
Female connector 2: Connect AMS1117-3.3V module to supply +3.3V to sensors and functional modules.
Terminal block: Connected to an external power supply (6-9V)
Male connector 3: Connected to an external filter circuit to denoise the anemometer whose behaviour is a switch's.
Male connector 4: Connected to an external filter circuit to denoise the rain gauge whose behaviour is a momentary switch's
Male connector 1: Connected to an USB-to-TTL device.
Terminal block: Connected to a DS18B20 (waterproof version)
Logic Analyser
Female connector 3: Connect AMS1117-3.3V module to supply +3.3V to SX1278 LoRa module.
Female connector 1: Connect AMS1117-5V module to supply +5V to microcontroller.

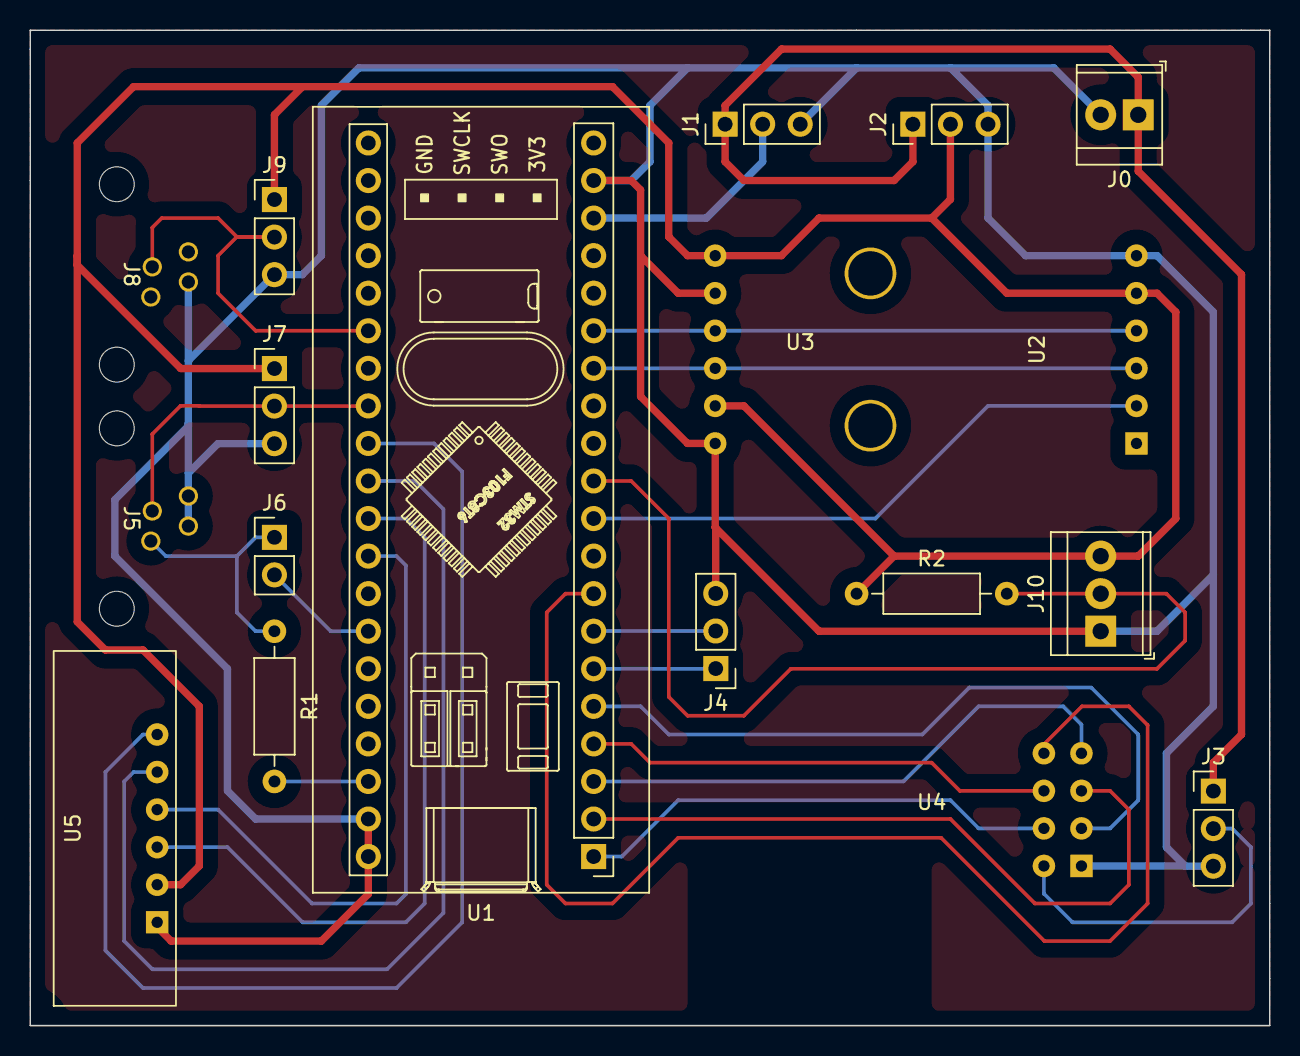
[picture p80: board 01-Beta-PCB-From-Breadboard.kicad_pcb from above]

Board: 2 copper layers, 83.8 x 67.3 mm, 18 parts (0 on the bottom side), 26 nets.
