Dreamy-Z3r0/VGU-WirelessMeteorologyStation/01 - Simulations/01 - Analogue Filter - 1st order RC LPF/LPF simulation for thesis/LPF simulation for thesis.kicad_sch

## KiCad design 01 - Simulations/01 - Analogue Filter - 1st order RC LPF/LPF simulation for thesis/LPF simulation for thesis.kicad_sch (2023-10-14)

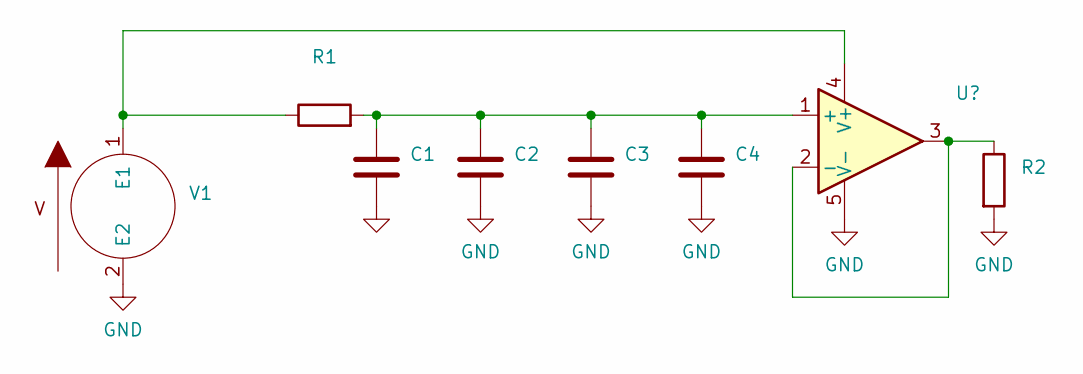
[picture p81: schematic LPF simulation for thesis.kicad_sch]

Parts:
C1, C2, C3, C4: (no value)
R1, R2: (no value)
V1: (no value)

Connections:
unnamed: C1.1, C2.1, C3.1, C4.1, R1.2
unnamed: R1.1, V1.1 (E1)
