Dreamy-Z3r0/VGU-WirelessMeteorologyStation/02 - Module Testings/06-Anemometer/Input_RC_LPF/Input_RC_LPF.kicad_sch

## KiCad design 02 - Module Testings/06-Anemometer/Input_RC_LPF/Input_RC_LPF.kicad_sch (2022-06-29)

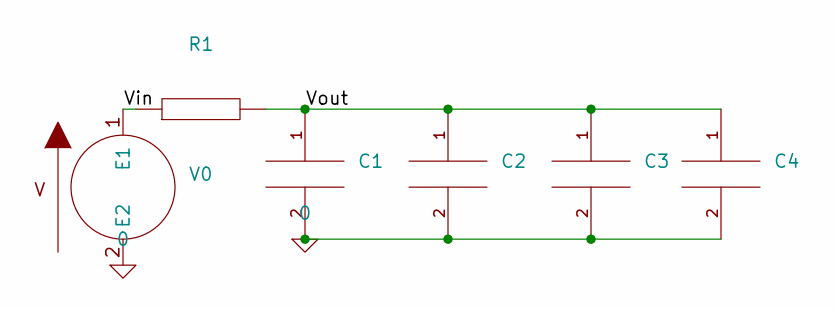
[picture p82: schematic Input_RC_LPF.kicad_sch]

Parts:
C1, C2, C3, C4: (no value)
R1: (no value)
V0: (no value)

Connections:
unnamed: C1.2, C2.2, C3.2, C4.2
Vin: R1.1, V0.1 (E1)
Vout: C1.1, C2.1, C3.1, C4.1, R1.2
