Dreamy-Z3r0/VGU-WirelessMeteorologyStation/02 - Module Testings/06-Anemometer/Input_RLC_LPF/Input_RLC_LPF.kicad_sch

## KiCad design 02 - Module Testings/06-Anemometer/Input_RLC_LPF/Input_RLC_LPF.kicad_sch (2022-06-29)

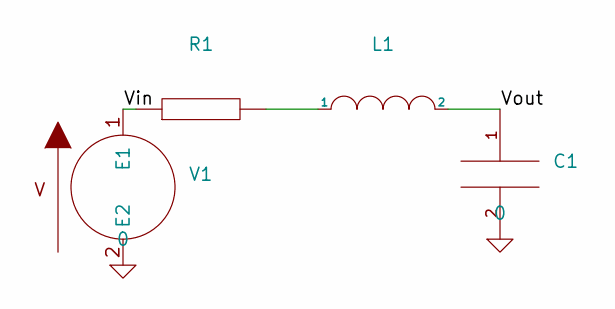
[picture p83: schematic Input_RLC_LPF.kicad_sch]

Parts:
C1: (no value)
L1: (no value)
R1: (no value)
V1: (no value)

Connections:
unnamed: L1.1, R1.2
Vin: R1.1, V1.1 (E1)
Vout: C1.1, L1.2
