Dreamy-Z3r0/VGU-WirelessMeteorologyStation/02 - Module Testings/06-Anemometer/Input_active_RC_LPF/Input_active_RC_LPF.kicad_sch

## KiCad design 02 - Module Testings/06-Anemometer/Input_active_RC_LPF/Input_active_RC_LPF.kicad_sch (2022-06-29)

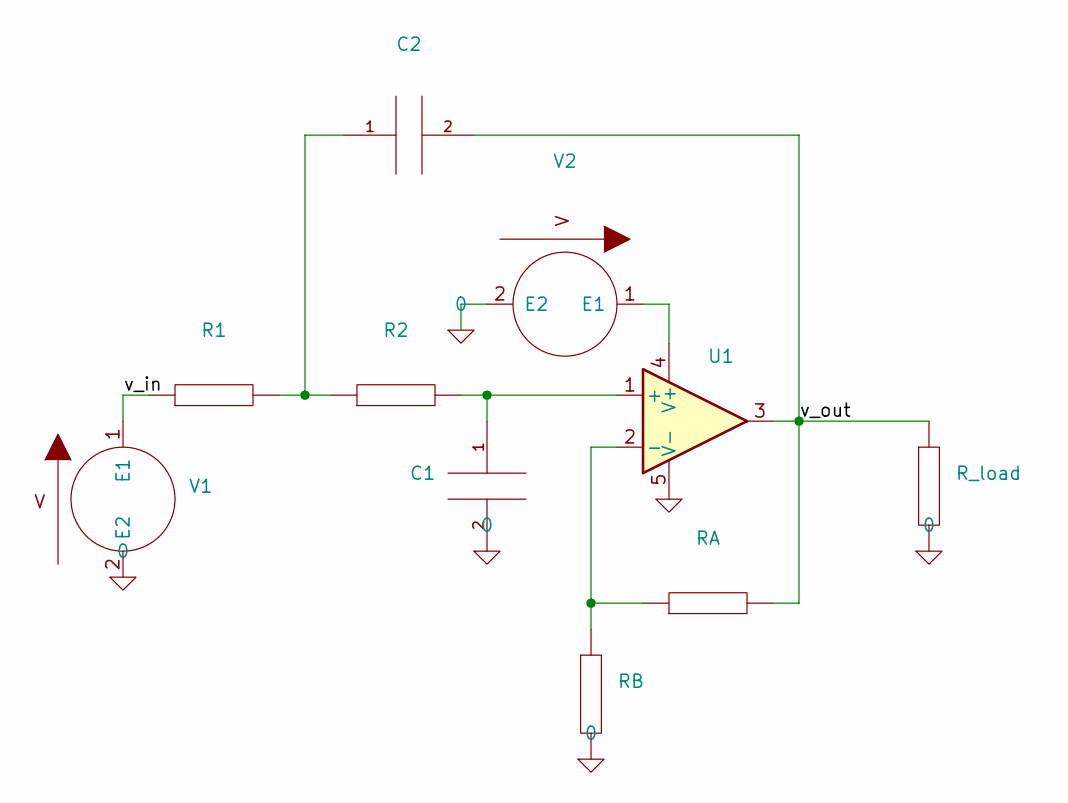
[picture p84: schematic Input_active_RC_LPF.kicad_sch]

Parts:
C1, C2: (no value)
R1, R2: (no value)
RA: (no value)
RB: (no value)
R_load: (no value)
U1: (no value)
V1, V2: (no value)

Connections:
unnamed: C1.1, R2.2, U1.1 (+)
unnamed: C2.1, R1.2, R2.1
unnamed: RA.1, RB.1, U1.2 (-)
unnamed: U1.4 (V+), V2.1 (E1)
v_in: R1.1, V1.1 (E1)
v_out: C2.2, RA.2, R_load.1, U1.3
