Dreamy-Z3r0/VGU-WirelessMeteorologyStation/01 - Simulations/LPF/Analog RC Filter/RC-LPF/RC-LPF.kicad_sch

## KiCad design 01 - Simulations/LPF/Analog RC Filter/RC-LPF/RC-LPF.kicad_sch (2023-03-25)

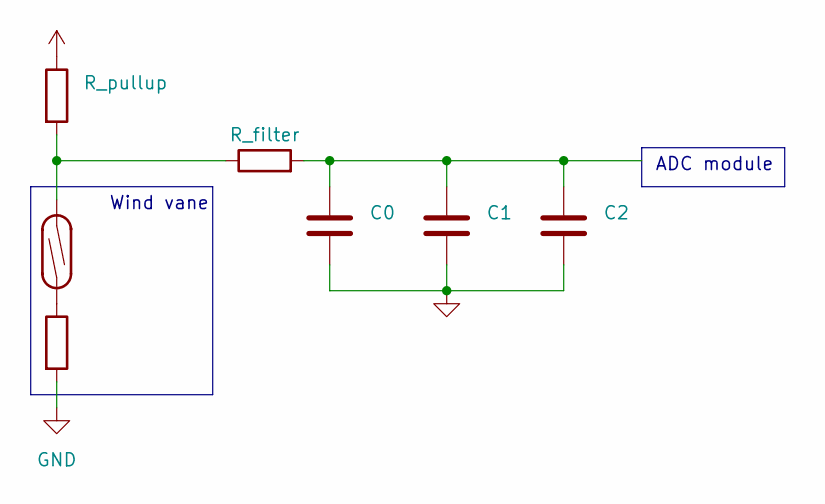
[picture p85: schematic RC-LPF.kicad_sch]

Parts:
C0, C1, C2: (no value)
R_filter: (no value)
R_pullup: (no value)

Connections:
unnamed: C0.1, C1.1, C2.1, R_filter.2
unnamed: C0.2, C1.2, C2.2
unnamed: R_filter.1, R_pullup.2

Notes on the sheet:
ADC module
Wind vane
