Dreamy-Z3r0/VGU-WirelessMeteorologyStation/02 - Module Testings/11-Multiple-SPI-Multiple-Slaves/LoRa_Gateway/LoRa_Gateway.ino

/***
 *** LoRa connectivity test - Simple gateway
 *** 
 *** Microcontroller: ESP32 on NodeMCU-32S
 *** LoRa module: SX1278
 *** LoRa settings are input via Serial and updated with LoRaSettings(..)
 *** Initial LoRa settings:
 ***    + LoRa frequency: 433 MHz
 ***    + Spreading factor: 12    
 ***    + Signal bandwidth: 500 kHz    
 ***    + Coding rate: 4/5 
 ***    + Sync word: 0x12 
 ***
 ***      Hardware connections
 ***      ESP32    | SX1278 |  Function
 *** --------------|--------|----------------
 ***     GPIO23    |  MOSI  | VSPI MOSI
 ***     GPIO19    |  MISO  | VSPI MISO
 ***     GPIO18    |  SCK   | VSPI CLK
 ***     GPIO5     |  NSS   | VSPI CS0
 *** --------------|--------|----------------
 ***  GPIO16 / RX2 |  RST   | LoRa Reset
 ***  GPIO17 / TX2 |  DIO0  | EXTI from LoRa
 ***/


#include <SPI.h>
#include <LoRa.h>

const long frequency = 433E6;   // LoRa frequency

const int csPin = 5;      // SPI NCSS for LoRa
const int resetPin = 16;  // LoRa reset
const int irqPin = 17;    // Interrupt by LoRa

int spreadingFactor = 12;
long signalBandwidth = 500E3;
int codingRate4 = 5;
int syncWord = 0x12;

bool new_sf = false,
     new_sb = false,
     new_cr = false,
     new_sw = false;

bool nodeReplied = false;

unsigned long timestamp;

void setup() {
  // Initialize Serial
  Serial.begin(9600);
  while (!Serial);

  // Initialize LoRa
  LoRa.setPins(csPin, resetPin, irqPin);
  if (!LoRa.begin(frequency)) {
    Serial.println("LoRa init failed. Check your connections.");
    while (true);                       // if failed, do nothing
  }
  
  Serial.println("LoRa init succeeded.");

  LoRa.onReceive(onReceive);
  LoRa.onTxDone(onTxDone);
  LoRa_rxMode();

  timestamp = millis();
}

void loop() {
  static int counter = 0;

  Serial_InputHandler();
  if (new_sf | new_sb | new_cr | new_sw) {
    LoRaSettings();
  }

  String message = "Gateway counter = ";
  message += String(counter);

  counter += 1;
  if (10 < counter) counter = 0;

  LoRa_sendMessage(message);
  
  while (!nodeReplied) {
    if (millis() - timestamp >= 5000) {
      nodeReplied = true;
      timestamp = millis();
    }
  }
  
  nodeReplied = false;
  delay(5000);
}

void Serial_InputHandler(void) {
  if (Serial.available()) {   // Check for user input
    String input = Serial.readString();
    bool validity_check = Input_Message_Handler(input);
    
    if (validity_check) {
      Serial.println("At least 1 input is available and valid.");
    } else if (input.equals("settings?")) {      // Request for current LoRa settings
      Serial.println("Current LoRa settings:");

      // LoRa frequency
      Serial.print("   + LoRa frequency: ");
      Serial.print((int)(frequency/1E6));
      Serial.println("MHz");

      // Spreading factor
      Serial.print("   + Spreading factor: ");
      Serial.println(spreadingFactor);

      // Signal bandwidth
      Serial.print("   + Signal bandwidth: ");
      if (31.25E3 == signalBandwidth)    
        Serial.print("31.25");
      else if (125E3 <= signalBandwidth) 
        Serial.print((int)(signalBandwidth/1E3));
      else 
        Serial.print((float)(signalBandwidth/1E3), 1);
      Serial.println("kHz");

      // Coding rate
      Serial.print("   + Coding rate: 4/");
      Serial.println(codingRate4);

      // Sync word
      Serial.print("   + Sync word: 0x");
      Serial.print(syncWord, HEX);
      Serial.println("\n");
    } else {
      Serial.println("Invalid input.\n");
    }
  }
}

bool Input_Message_Handler(String inputString) {
  Serial.println("\nString processing scope:");
  
  Serial.print("  String to process: ");
  Serial.println(inputString);
  
  int command_start_index = inputString.indexOf('?'),
      command_stop_index = -1,
      colon_index = -1;

  if (0 != command_start_index) {
    if (-1 == command_start_index) {
      Serial.println("  Invalid command format: no start character.");
      return false;
    } else {
      inputString.remove(0, command_start_index);
      command_start_index = 0;
      colon_index = inputString.indexOf(':');
      
      Serial.print("  Command starts at ");
      Serial.println(command_start_index);
    }
  } else {
    Serial.print("  Command starts at ");
    Serial.println(command_start_index);
    colon_index = inputString.indexOf(':');
  }

  if (-1 == colon_index) {
    Serial.println("  Invalid command format: no colon");
    return false;
  } else {
    Serial.print("  Colon at ");
    Serial.println(colon_index);
    command_stop_index = inputString.indexOf(' ');
  }    
   
  if (-1 == command_stop_index) {
    Serial.println("  Invalid command format: no stop character.");
    return false;
  } else {
    Serial.print("  Command stops at ");
    Serial.println(command_stop_index);
  }
  
  String command = inputString.substring(0, colon_index);

  Serial.print("  Input type: ");
  if (command.equals("?sf")) {
    Serial.print("spreading factor\n  Value: ");
    command = inputString.substring(colon_index+1, command_stop_index);
    bool isHEX, isFloat;
    if (isValidValue(command, &isHEX, &isFloat)) {
      if (isHEX || isFloat) {
        Serial.println(" (invalid - float or hex input)");
        return false;
      } else {
        int value = command.toInt();
        if ((6 <= value) && (12 >= value)) {
          Serial.print(spreadingFactor);
          if (spreadingFactor == value) {
            if (new_sf) Serial.println(" (duplicated input)");
            else Serial.println(" (unchanged)");
          } else {
            new_sf = true;
            spreadingFactor = value;
            Serial.print(" -> ");
            Serial.println(spreadingFactor);
          }
        } else {
          Serial.println(" (invalid - out of range)");
          return false;
        }
      }
    } else {
      Serial.println(" (invalid value)");
      return false;
    }
  } else if (command.equals("?sb")) {
    Serial.print("signal bandwidth\n  Value: ");
    command = inputString.substring(colon_index+1, command_stop_index);
    bool isHEX, isFloat;
    if (isValidValue(command, &isHEX, &isFloat)) {
      if (isHEX) {
        Serial.println(" (invalid - hex input)");
        return false;
      } else {
        long value = (long)(command.toFloat() * 1000);
        switch (value) {
          case (long)7.8E3:
          case (long)10.4E3:
          case (long)15.6E3:
          case (long)20.8E3:
          case (long)31.25E3:
          case (long)41.7E3:
          case (long)62.5E3:
          case (long)125E3:
          case (long)250E3:
          case (long)500E3: {
            if (31.25E3 == signalBandwidth)    
              Serial.print("31.25");
            else if (125E3 <= signalBandwidth) 
              Serial.print((int)(signalBandwidth/1E3));
            else 
              Serial.print((float)(signalBandwidth/1E3), 1);
            Serial.print("kHz");

            if (signalBandwidth == value) {
              if (new_sb) Serial.println(" (duplicated input)");
              else Serial.println(" (unchanged)");
            } else {
              new_sb = true;
              signalBandwidth = value;
              Serial.print(" -> ");
              if (31.25E3 == signalBandwidth)
                Serial.print("31.25");
              else if (125E3 <= signalBandwidth)
                Serial.print((int)(signalBandwidth/1E3));
              else
                Serial.print((float)(signalBandwidth/1E3), 1);
              Serial.println("kHz");
            }
            break;
          }
          default: {
            Serial.println(" (invalid value)");
            return false;
            break;
          }
        }
      }
    } else {
      Serial.println(" (invalid)");
      return false;
    }
  } else if (command.equals("?cr")) {
    Serial.print("coding rate\n  Value: ");
    command = inputString.substring(colon_index+1, command_stop_index);
    bool isHEX, isFloat;
    if (isValidValue(command, &isHEX, &isFloat)) {
      if (isHEX || isFloat) {
        Serial.println(" (invalid - float or hex input)");
        return false;
      } else {
        int value = command.toInt();
        if ((5 <= value) && (8 >= value)) {
          Serial.print("4/");
          Serial.print(codingRate4);
          if (codingRate4 == value) {
            if (new_cr) Serial.println(" (duplicated input)");
            else Serial.println(" (unchanged)");
          } else {
            codingRate4 = value;
            Serial.print(" -> 4/");
            Serial.println(codingRate4);
          }
        } else {
          Serial.println(" (invalid value)");
          return false;
        }
      }
    } else {
      Serial.println(" (invalid)");
      return false;
    }
  }  else if (command.equals("?sw")) {
    Serial.print("sync word\n  Value: ");
    command = inputString.substring(colon_index+1, command_stop_index);
    bool isHEX, isFloat;
    if (isValidValue(command, &isHEX, &isFloat)) {
      if (!isHEX) {
        Serial.println(" (invalid - not HEX)");
      } else {
        command.toLowerCase();
        uint8_t char0 = command.charAt(2),
                char1 = command.charAt(3);
        
        int value = (HEX_to_int(char0) << 4) | HEX_to_int(char1);
        Serial.print("0x");
        Serial.print(syncWord, HEX);

        if (syncWord == value) {
          if (new_sw) Serial.println(" (duplicated input)");
          else Serial.println(" (unchanged)");
        } else {
          new_sw = true;
          syncWord = value;
          Serial.print(" -> 0x");
          Serial.println(syncWord, HEX);
        }
      }
    } else {
      Serial.println(" (invalid)");
      return false;
    }
  }

  inputString.remove(0, command_stop_index);
  Serial.print("  Remaining input string length: ");
  Serial.println(inputString.length());

  if (1 < inputString.length()) {
    Input_Message_Handler(inputString);
  }

  return true;
}

void LoRaSettings(void) {
  if (new_sf) {
    new_sf = false;
    LoRa.setSpreadingFactor(spreadingFactor);
  }

  if (new_sb) {
    new_sb = false;
    LoRa.setSignalBandwidth(signalBandwidth);
  }

  if (new_cr) {
    new_cr = false;
    LoRa.setCodingRate4(codingRate4);
  }

  if (new_sw) {
    new_sw = false;
    LoRa.setSyncWord(syncWord);
  }
}

void LoRa_rxMode() {
  LoRa.disableInvertIQ();               // normal mode
  LoRa.receive();                       // set receive mode
}

void LoRa_txMode() {
  LoRa.idle();                          // set standby mode
  LoRa.enableInvertIQ();                // active invert I and Q signals
}

void LoRa_sendMessage(String message) {
  LoRa_txMode();                        // set tx mode
  LoRa.beginPacket();                   // start packet
  LoRa.print(message);                  // add payload
  LoRa.endPacket(true);                 // finish packet and send it
}

void onReceive(int packetSize) {
  String message = "";

  while (LoRa.available()) {
    message += (char)LoRa.read();
  }

  Serial.print("Gateway Receive: ");
  Serial.println(message);
  nodeReplied = true;
}

void onTxDone() {
  Serial.println("TxDone");
  LoRa_rxMode();
}

bool isValidValue(String stringData, bool* isHEX, bool* isFloat) {
  bool output = true;
  
  *isHEX = false;
  uint8_t counter = 0;
  if (stringData.substring(0, 2).equals("0x")) {
    *isHEX = true;
    stringData.remove(0, 2);
    stringData.toLowerCase();
  }

  uint8_t stringLength = stringData.length();
  *isFloat = false;

  for (uint8_t index = 0; index < stringLength; index += 1) {
    char charInCheck = stringData.charAt(index);

    if ('.' == charInCheck) {   // Check floating point indicator '.'
      if ((0 == index) || *isFloat || *isHEX) return false;   // String starts with '.', already has '.' present, or is a HEX number
      else *isFloat = true;
    } else if (('0' <= charInCheck) && ('9' >= charInCheck)) {
      if (*isHEX) {
        counter += 1;
        if (counter > 2) return false;
      }
    } else if (*isHEX && ('a' <= charInCheck) && ('f' >= charInCheck)) {
      counter += 1;
      if (counter > 2) return false;
    } else {  // Input string is not a (valid) number
      return false;
    }
  }

  if (*isHEX && (2 != counter)) return false;
  return output;
}

int HEX_to_int(uint8_t HEX_value) {
  if (('0' <= HEX_value) && (HEX_value <= '9')) {
    HEX_value -= '0';
  } else if (('a' <= HEX_value) && (HEX_value <= 'f')) {
    HEX_value -= 'W';
  }

  return HEX_value;
}
