Dreamy-Z3r0/VGU-WirelessMeteorologyStation/02 - Module Testings/03-BME280/BME280/BME280.ino

/******************************************************************
 ******************************************************************
 ***    BME280 test for STM32F103CBT6 on Arduino framework      ***
 *** ---------------------------------------------------------- ***
 ***                                                            ***
 *** BME280 is a temperature - humidity - barometric pressure   ***
 *** sensor which could communicate via either I2C or SPI. This ***
 *** test is designed for the default SPI on the STM32.         ***
 ***                                                            ***
 *** On the STM32F103CBT6, the default SPI is mapped to SPI1:   ***
 *** (MOSI, MISO, SCK, NCSS) = (PA7, PA6, PA5, PA4). The NCSS   ***
 *** pin, however, is user-defined in the code.                 ***
 ***                                                            ***
 *** Should other configurations be desired, the followings     ***
 *** could be applied:                                          ***
 ***  - Interface:                                              ***
 ***    + I2C: Adafruit_BME280 bme;                             ***                                                            
 ***    + Default hardware SPI1: Adafruit_BME280 bme(BME_CS);   ***                                                            
 ***    + Software SPI: Adafruit_BME280 bme(BME_CS, BME_MOSI,   ***                                                            
 ***                                        BME_MISO, BME_SCK); ***    
 ***                                                            ***                                        
 *** - Configurations for I2C:                                  ***                                                            
 ***    + Default: bme.begin(); -> Also used for SPI            *** 
 ***    + Different address: bme.begin(ADDRESS);                ***                                                            
 ***    + Different I2C bus: bme.begin(Address, &Wire_x);       ***    
 ***                                                            ***    
 *** Note:                                                      ***                                                            
 ***  - I2C address could be either 0x77 or 0x76, thus no more  ***                                                            
 ***    than 2 BME280s on the same I2C bus.                     ***
 ***  - Wire_x is Wire1 for I2C1, Wire2 for I2C2, etc.          ***
 ***  - Any free digital pins could be used as BME_CS for SPI,  ***                                                        
 ***    so the maximum allowed number of BME280s on the same    ***  
 ***    SPI bus is the number of free digital pins.             ***    
 ******************************************************************
 ******************************************************************/


#include <SPI.h>
#include <Adafruit_Sensor.h>
#include <Adafruit_BME280.h>

// The following comments are for the purpose of remapping SPI only, which is no longer of use.
//#define default_MOSI_Pin PB15
//#define default_MISO_Pin PB14
//#define default_SCLK_Pin PB13
//#define default_SSEL_Pin PB12

//#define BME_CS PA4
#define SEALEVELPRESSURE_HPA (1013.25)

//Adafruit_BME280 bme(BME_CS); // hardware SPI
Adafruit_BME280 bme;

typedef struct {
  float temperature;
  float humidity;
  float pressure;
} BME280_Data;

BME280_Data BME280_dataStorage;
bool BME280_readFlag = false;

void setup() {
  Serial.begin(9600);
  delay(2000);
  Serial.println("begin...");

//  SPI.setMOSI(default_MOSI_Pin);
//  SPI.setMISO(default_MISO_Pin);
//  SPI.setSCLK(default_SCLK_Pin);
//  SPI.setSSEL(default_SSEL_Pin);

  unsigned status;
  status = bme.begin(0x76);
  if (!status) {
    Serial.println("status = false");
    while (1);
  }

  read_BME280(&BME280_dataStorage, &BME280_readFlag);

  HardwareTimer *sensorRoutine = new HardwareTimer(TIM4);
  sensorRoutine->setOverflow(1, HERTZ_FORMAT);
  sensorRoutine->attachInterrupt(std::bind(read_BME280, &BME280_dataStorage, &BME280_readFlag));
  sensorRoutine->resume();
}

void loop() {
  if (BME280_readFlag) {
    BME280_readFlag = false;

    Serial.print("Ambient temperature = ");
    Serial.print(BME280_dataStorage.temperature);
    Serial.println(" ºC");

    Serial.print("Relative humidity = ");
    Serial.print(BME280_dataStorage.humidity);
    Serial.println(" %RH");

    Serial.print("Atmospheric pressure = ");
    Serial.print(BME280_dataStorage.pressure);
    Serial.println(" hPa");

    Serial.println();
  }

  delay(1000);
}

void read_BME280(BME280_Data* storage, bool* controlFlag) {
  storage->temperature = bme.readTemperature();         // Read temperature data in degree Celsius
  storage->pressure    = bme.readPressure() / 100.0F;   // Read barometric data in hPa
  storage->humidity    = bme.readHumidity();            // Read relative humidity data in %RH

  *controlFlag = true;
}
