Dreamy-Z3r0/VGU-WirelessMeteorologyStation/02 - Module Testings/14-HAL_Libraries/ADC_IT/ADC_IT.ino

/* STM32F1xx specific HAL configuration options. */
#if __has_include("hal_conf_custom.h")
#include "hal_conf_custom.h"
#else
#if __has_include("hal_conf_extra.h")
#include "hal_conf_extra.h"
#endif
#include "stm32f1xx_hal_conf_default.h"
#endif

ADC_HandleTypeDef hadc1;

uint16_t raw[50];
uint8_t arr_index = 0;
bool output_ready = false;

unsigned long t1, t2;

void setup() {
  Serial.begin(9600);

  MX_ADC1_Init();
  HAL_ADCEx_Calibration_Start(&hadc1);
}

void loop() {
  t1 = micros();
  HAL_ADC_Start_IT(&hadc1);

  while(!output_ready);
  output_ready = false;

  Serial.print("ADC readout: ");

  for (uint8_t i = 0; i < 50; i += 1) {
    if (0 == i%10) Serial.printf("\n");
    Serial.printf(" %d", raw[i]);
  }

  Serial.printf("\nRead time: %d us\n\n", t2 - t1);

//  Serial.printf("ADC readout: %d\n", raw);
//  Serial.printf("V = %.2f V\n\n", 3.3*raw/4095);
  
  HAL_Delay(1000);
}

/**
  * @brief This function handles ADC1 and ADC2 global interrupts.
  */
extern "C" void ADC1_2_IRQHandler(void)
{
  HAL_ADC_IRQHandler(&hadc1);
}

/**
* @brief ADC MSP Initialization
* This function configures the hardware resources used in this example
* @param hadc: ADC handle pointer
* @retval None
*/
extern "C" void HAL_ADC_MspInit(ADC_HandleTypeDef* hadc)
{
  GPIO_InitTypeDef GPIO_InitStruct = {0};
  if(hadc->Instance==ADC1)
  {
    /* Peripheral clock enable */
    __HAL_RCC_ADC1_CLK_ENABLE();

    __HAL_RCC_GPIOB_CLK_ENABLE();
    /**ADC1 GPIO Configuration
    PB1     ------> ADC1_IN9
    */
    GPIO_InitStruct.Pin = GPIO_PIN_1;
    GPIO_InitStruct.Mode = GPIO_MODE_ANALOG;
    HAL_GPIO_Init(GPIOB, &GPIO_InitStruct);

    /* ADC1 interrupt Init */
    HAL_NVIC_SetPriority(ADC1_2_IRQn, 0, 0);
    HAL_NVIC_EnableIRQ(ADC1_2_IRQn);
  }

}

/**
* @brief ADC MSP De-Initialization
* This function freeze the hardware resources used in this example
* @param hadc: ADC handle pointer
* @retval None
*/
extern "C" void HAL_ADC_MspDeInit(ADC_HandleTypeDef* hadc)
{
  if(hadc->Instance==ADC1)
  {
    /* Peripheral clock disable */
    __HAL_RCC_ADC1_CLK_DISABLE();

    /**ADC1 GPIO Configuration
    PB1     ------> ADC1_IN9
    */
    HAL_GPIO_DeInit(GPIOB, GPIO_PIN_1);

    /* ADC1 interrupt DeInit */
    HAL_NVIC_DisableIRQ(ADC1_2_IRQn);
  }

}

/**
  * @brief ADC1 Initialization Function
  * @param None
  * @retval None
  */
void MX_ADC1_Init(void)
{

  ADC_ChannelConfTypeDef sConfig = {0};

  /** Common config
  */
  hadc1.Instance = ADC1;
  hadc1.Init.ScanConvMode = ADC_SCAN_DISABLE;
  hadc1.Init.ContinuousConvMode = DISABLE;
  hadc1.Init.DiscontinuousConvMode = DISABLE;
  hadc1.Init.ExternalTrigConv = ADC_SOFTWARE_START;
  hadc1.Init.DataAlign = ADC_DATAALIGN_RIGHT;
  hadc1.Init.NbrOfConversion = 1;
  if (HAL_ADC_Init(&hadc1) != HAL_OK)
  {
    while (1);
  }

  /** Configure Regular Channel
  */
  sConfig.Channel = ADC_CHANNEL_9;
  sConfig.Rank = ADC_REGULAR_RANK_1;
  sConfig.SamplingTime = ADC_SAMPLETIME_1CYCLE_5;
  if (HAL_ADC_ConfigChannel(&hadc1, &sConfig) != HAL_OK)
  {
    while (1);
  }
}

void HAL_ADC_ConvCpltCallback(ADC_HandleTypeDef* hadc) {
  raw[arr_index] = HAL_ADC_GetValue(&hadc1);

  arr_index += 1;
  if (50 == arr_index) {
    t2 = micros();
    output_ready = true;
    arr_index = 0;
  }
  else {
    HAL_ADC_Start_IT(&hadc1);
  }
}
