Dreamy-Z3r0/VGU-WirelessMeteorologyStation/04 - Assembly/Version 0.5.1 (Beta) - OOP/Main_Code/Libraries.h

#pragma once

// Basic communication protocols
#include <Wire.h>
#include <SPI.h>

// Logger with an SD card
#include "SD.h"

// Real-time clock DS3231
#include <DS3231.h>

// Temperature - Humidity - Barometric pressure sensor BME280
#include <Adafruit_Sensor.h>
#include <Adafruit_BME280.h>

// Temperature sensor DS18B20
#include <OneWire.h>

// Custom functions
#include "RTC.h"
#include "Thermometer_Hygrometer_Barometer.h"
#include "Precipitation.h"
#include "Wind_Vane.h"
