Dreamy-Z3r0/VGU-WirelessMeteorologyStation/04 - Assembly/Version 0.5.1 (Beta) - OOP/Main_Code/RTC.h

#include <DS3231.h>


enum DateTime_Control {
   day = 1,   month = 2,    year = 4, 
  hour = 8, minute = 16, second = 32
};

typedef struct {
  int year;
  int month;
  int day;
} Date;   // Temporary storage for input date processing function 

typedef struct {
  int hour;
  int minute;
  int second;
} Time;   // Temporary storage for input time processing function


class DS3231_Control {
  private:
    RTClib myRTC;
    int RTC_data[6];    // Date and time data holder: day - month - year - hour - minute - second
    bool readRTC_control_flag;      // set "true" to request a date-time reading from the RTC
  
  public:    
    DS3231_Control();
  
    // Fetch time kept by the DS3231
    void readRTC(void);
    // Extract the input data and check the validity before storing for updating
    void input_DateTime(String input_data, int type, bool* entryVerification);
    // Update the RTC
    void update_RTC(int type);

    int readDay(void);
    int readMonth(void);
    int readYear(void);

    int readHour(void);
    int readMinute(void);
    int readSecond(void);
    
    void request_from_RTC(void);
    bool is_RTC_requested(void);
    void clearRTC_request(void);

  protected:
    // Validate input date
    bool isValidDate(Date* inputDate);
    // Validate input time
    bool isValidTime(Time* inputTime);
};


void request_from_RTC(DS3231_Control* RTC_DS3231);
