Dreamy-Z3r0/VGU-WirelessMeteorologyStation/02 - Module Testings/11-Multiple-SPI-Multiple-Slaves/LoRa-SD-BME280/LoRa_Handler.h

#include <SPI.h>
#include <LoRa.h>

typedef struct {
  int spreadingFactor;
  long signalBandwidth;
  int codingRate4;
  int syncWord;

  bool new_sf;
  bool new_sb;
  bool new_cr;
  bool new_sw;
} LoRa_Settings;

typedef struct {
  String LoRa_message;
  bool gateway_messaged;
} LoRa_rx_handler;

extern LoRa_Settings LoRa_settings;
extern LoRa_rx_handler Received_over_LoRa;

void LoRaSettings();
void LoRa_new_sf_handler(int new_sf_value);
void LoRa_new_sf_handler(long new_sb_value);
void LoRa_new_cr_handler(int new_cr_value);
void LoRa_new_sw_handler(int new_sw_value);

void LoRa_rxMode();
void LoRa_txMode();
void LoRa_sendMessage(String message);
void onReceive(int packetSize);
void onTxDone();
