Dreamy-Z3r0/VGU-WirelessMeteorologyStation/(commit log)

2022-06-29 Move files from separated repositories
    [Wind vane Vout handler.xlsx]
2022-06-29 Move files from separate repositories (2)
    [Input_RC_LPF.kicad_pcb, Input_RC_LPF.kicad_sch, Input_RLC_LPF.kicad_pcb, Input_RLC_LPF.kicad_sch, Input_active_RC_LPF.kicad_pcb, Input_active_RC_LPF.kicad_sch]
2022-06-30 Update Multiple SPI - Multiple Slaves
2022-07-14 Switching LoRa channels is now available
2022-07-14 Final touch on channel switching
2022-07-14 Tada! Let's start LoRa CAD test!
    (CAD: Channel Activity Detection)
2022-07-14 update CAD source code for tests
2022-07-20 Remove CAD and update wind sensors' tests
2022-07-21 Remove SPI remapping in version 0.3 beta
2022-08-15 Re-arrange source code structures + resolve issues
    [Anemometer.cpp, Anemometer.h, Anemometer_TimerInputCapture_Nonblocking.ino, Main_Code.ino]
2022-08-25 Update IIR filter
2022-08-31 Allow update of timestamps for sensors
2022-09-05 Add missing delete[] command + fix printf issues
    [Main_Code.ino, Wind_Vane.cpp]
2022-09-09 The start of general control class for sensors
2022-09-10 Updates regarding sensor general control class
2022-09-12 Further updates of Sensor_Control class
2022-09-12 New anemometer-reading method!!!
    New changes bring:
    1. Saving 1 hardware timer for future uses
    2. Less variables/flags to be managed
    3. Simplified codes
2022-09-13 Revision needed; wind vane fails to read correctly
    [Main_Code.ino, Sensor_Control.cpp, Sensor_Control.h, Wind_Vane.cpp]
2022-09-14 Changed the order of IIR filter from 2nd to 1st
2022-09-15 Add/Update timer callbacks
2022-09-21 Fix standby_routine() and Serial guard issues
    [Sensor_Base.cpp, Sensor_Base.h, Sensor_Control.cpp, Wind_Vane.cpp]
2022-10-03 Change SX1278 SPI init method
2022-10-11 Establish SPI communication between uC & SX1278
2022-11-02 Version 2.1.2 (beta) - change to I2C for BME280
2023-01-30 add STM32 end of the 3-way UART communication
2023-01-30 add bridge for 3-way UART communication
2023-02-27 Rename directories
    [01-Beta-PCB-From-Breadboard-B_Cu.gbl, 01-Beta-PCB-From-Breadboard-B_Mask.gbs, 01-Beta-PCB-From-Breadboard-B_Paste.gbp, 01-Beta-PCB-From-Breadboard-B_Silkscreen.gbo, 01-Beta-PCB-From-Breadboard-Edge_Cuts.gm1, 01-Beta-PCB-From-Breadboard-F_Cu.gtl, 01-Beta-PCB-From-Breadboard-F_Mask.gts, 01-Beta-PCB-From-Breadboard-F_Paste.gtp]
2023-02-27 add simulations and results
    [CHEBYSHEVLPF.DSN, ChebyshevLPF.opj, Choosing Ra and Rb.xlsx, Components.xlsx, ScopeIIR Filter Coefficients.xlsx, Wind vane Vout handler.xlsx]
2023-03-06 New prototype design + update rain gauge test
    [03-Beta-PCB-Prototype.kicad_pcb, 03-Beta-PCB-Prototype.kicad_sch]
2023-03-25 Initialisation of the thesis
    [01-Beta-PCB-From-Breadboard.kicad_sch, RC-LPF.kicad_pcb, RC-LPF.kicad_sch]
2023-03-25 Restructure with archives
    [CHEBYSHEVLPF.DSN, ChebyshevLPF.opj, Choosing Ra and Rb.xlsx, Components.xlsx, RC-LPF.kicad_pcb, RC-LPF.kicad_sch, ScopeIIR Filter Coefficients.xlsx, Wind vane Vout handler.xlsx]
2023-04-01 Modify microSD card access
    [Abbreviations.xlsx, Components.xlsx]
2023-04-22 Add server tests: ThingSpeak + InfluxDB
    [04-BuckConverter.kicad_pcb, 04-BuckConverter.kicad_sch]
2023-05-15 DS18B20: timer for delay + new method
2023-07-11 New software version + new data
    [01-Beta-PCB-From-Breadboard.kicad_sch, 05-Prototype-UpdatedComponents.kicad_pcb, 05-Prototype-UpdatedComponents.kicad_sch, Active filter - 3.3k pull down.xlsx, Active filter - 4.7k pull down.xlsx, Filter (11.587kHz) and voltage buffer.xlsx, LM317.xlsx, No filter, no amplifier.xlsx]
2023-07-15 hardware update
    [05-Prototype-UpdatedComponents.kicad_pcb, 05-Prototype-UpdatedComponents.kicad_sch]
2023-07-16 Schematic update
    [05-Prototype-UpdatedComponents.csv, 05-Prototype-UpdatedComponents.kicad_pcb, 05-Prototype-UpdatedComponents.kicad_sch]
2023-07-16 Update PCB
    [05-Prototype-UpdatedComponents.kicad_pcb, 05-Prototype-UpdatedComponents.kicad_sch]
2023-07-18 First version of updated board
    [05-Prototype-UpdatedComponents.kicad_pcb, 05-Prototype-UpdatedComponents.kicad_sch]
2023-07-18 Fill modification + gerber files
    [05-Prototype-UpdatedComponents-B_Cu.gbr, 05-Prototype-UpdatedComponents-B_Fab.gbr, 05-Prototype-UpdatedComponents-B_Mask.gbr, 05-Prototype-UpdatedComponents-B_Paste.gbr, 05-Prototype-UpdatedComponents-B_Silkscreen.gbr, 05-Prototype-UpdatedComponents-Edge_Cuts.gbr, 05-Prototype-UpdatedComponents-F_Cu.gbr, 05-Prototype-UpdatedComponents-F_Fab.gbr]
2023-07-18 Finalise 2nd version
    [05-Prototype-UpdatedComponents-B_Cu.gbr, 05-Prototype-UpdatedComponents-B_Fab.gbr, 05-Prototype-UpdatedComponents-B_Mask.gbr, 05-Prototype-UpdatedComponents-B_Paste.gbr, 05-Prototype-UpdatedComponents-B_Silkscreen.gbr, 05-Prototype-UpdatedComponents-Edge_Cuts.gbr, 05-Prototype-UpdatedComponents-F_Cu.gbr, 05-Prototype-UpdatedComponents-F_Fab.gbr]
2023-10-14 All updates: codes and hardware 14 Oct
    [09-Prototype-Final-BugFixing-B_Cu.gbr, 09-Prototype-Final-BugFixing-B_Mask.gbr, 09-Prototype-Final-BugFixing-B_Silkscreen.gbr, 09-Prototype-Final-BugFixing-Edge_Cuts.gbr, 09-Prototype-Final-BugFixing-F_Cu.gbr, 09-Prototype-Final-BugFixing-F_Mask.gbr, 09-Prototype-Final-BugFixing-F_Silkscreen.gbr, 09-Prototype-Final-BugFixing-NPTH.drl]
2023-10-18 Introduce calibration data
